donaldsonlab/Operant-Cage/V3/Documentation/Images/Dispenser/dispenser_fullAssembly.JPG

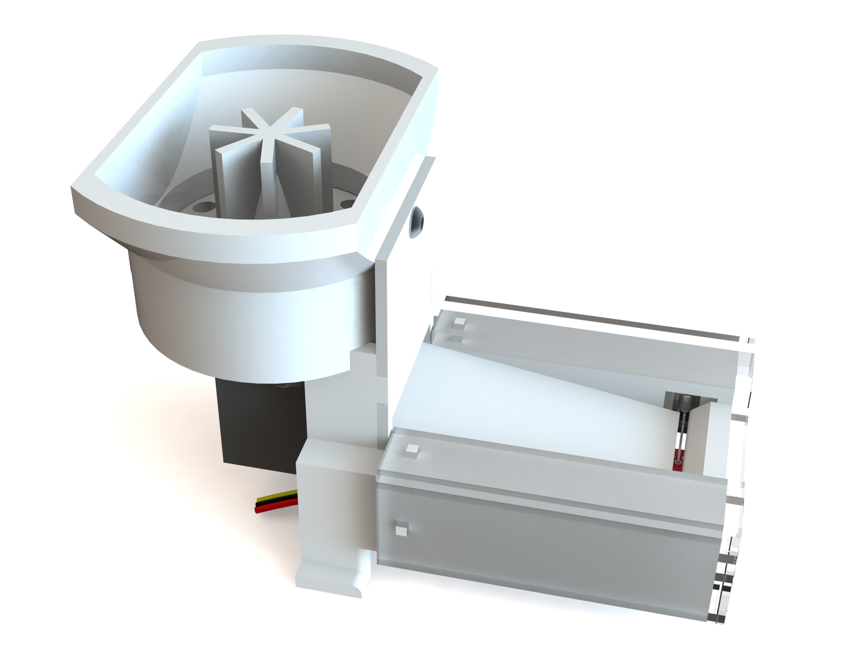
V3/Documentation/Images/Dispenser/dispenser_fullAssembly.JPG
