donaldsonlab/Operant-Cage/V3/Documentation/Images/Dispenser/dispenser_servoMount.JPG

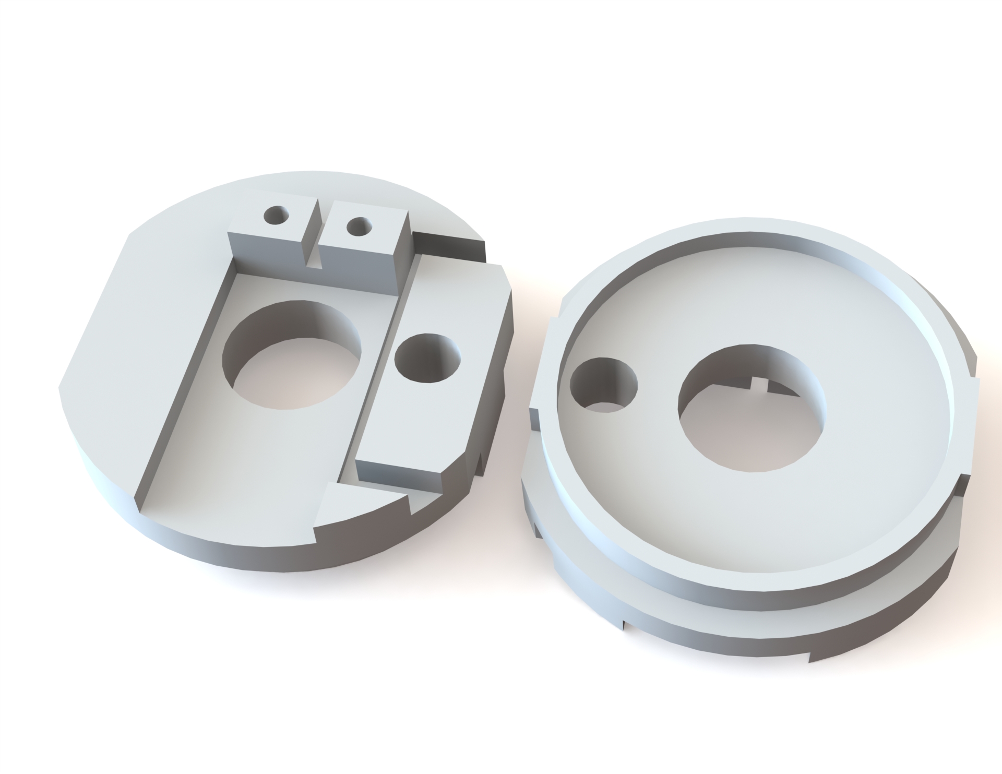
V3/Documentation/Images/Dispenser/dispenser_servoMount.JPG
