donaldsonlab/Operant-Cage/README.md

# Operant-Cage

This repository houses all of the hardware and software documents necessary for designing, manufacturing, and operating the operant cage developed by the Donaldson Lab at the University of Colorado - Boulder.

Its cool stuff.
