donaldsonlab/Operant-Cage/V3/Documentation/electricalDocumentationNotes.rtf

Introduction
- Link to operant documentation
- Maybe describe operant cage somewhat unless this is to be part of the full documentation (perhaps it should be since none of these components are really standalone)
Components
- Do we need to mention Bonsai here?
- If so, we should have an individual section on it, since it is somewhat complex
Raspberry Pi
- Give a brief intro explaining what a pi is and why we are using it
- We use a Raspberry Pi 3 B+
- Power supply
-5V
- SD card
- Size, purpose
Servo Hat
- Necessary for PWM control since Pi doesn't do it well
- Power supply can be 5-6V
- Current depends on number of servos, but we use 3A for 6 servos
- Can be easily controlled using Python and the Adafruit CircuitPython ServoKit library
- https://learn.adafruit.com/adafruit-16-channel-pwm-servo-hat-for-raspberry-pi/using-the-python-library
- I don't know if this is something we want to include in the setup tutorial or not
Front PCB
- PCBs are used to support secure connections with modularity (avoids jumper cables and permanent connections)
- Should we label the female vs male headers in the schematic? This can also just be mentioned in the assembly
Wiring
- Indicate the size of JST connectors
- JST are used for securement as well as modularity
- Wires are not easy to disconnect but can be if needed
- Link to JST assembly video/ say these can be purchased pre-assembled?
- It might be useful to give measurements for minimum wire lengths (this will be helpful for us too)
Raspberry Pi Setup
- I think there is a missing link for the microSD setup
- We may want to mention that a keyboard, mouse, and monitor are not neccessarily needed but are the easiest option
- We may want to mention that this is all using Python version 3
- I changed the import <packageName> suggestion to try to make it more clear
- Does the clone step have to be done from a specific directory?
- I think the code for making the local file and directory might not work
- Not sure if cd into \etc and then cd .. into RPI_operant will work
- Definitely need sudo commands for working in the local etc directory
- I don't even know if we will need this with the new code and config files
- The local settings file cannot be edited that easilly
- need to sudo vi or some other editing technique from the command line
- SSH needs to be enabled, should we mention that?
Assembly
Raspberry Pi
- It may be more useful to have a table with the total pinout, including front/back/hat specifications
- This should include which pins the servos are connected to
- This could also mention that these are the default pins and should be verified with the local settings file
- I'm not sure what this means "Note here that not all of the GPIO pins on the Pi are listed, and that is because these are the pins that come up through the Servo Hat and are available for the custom PCB to be connected to. "
Servo Hat
- Detail pin attachment
- Headers are included when purchased
- No need to solder 3V pin
- Add screws or spacers between hat and pi
Custom PCBs
- Mention that the user will have to solder pins either way
- Detail what pins to place where (is this obvious in the schematic?)
-Female vs. male headers
Third Party Printing
Connecting the Wires
- The servos are separate from the other components when going from front to back
- I don't remember if we changed this or not
Wire Holders
- Any epoxy will work
- Act as 0.5" spacers to match the feet
- I need to ask about the foam strips
- Might not be necessary if the wires are cut to the right length

GENERAL NOTES
- We should reference material sources
- We might want a BOM
- The document is missing some pictures and links
