donaldsonlab/Operant-Cage/V3/Documentation/Images/Chamber/cableCases.JPG

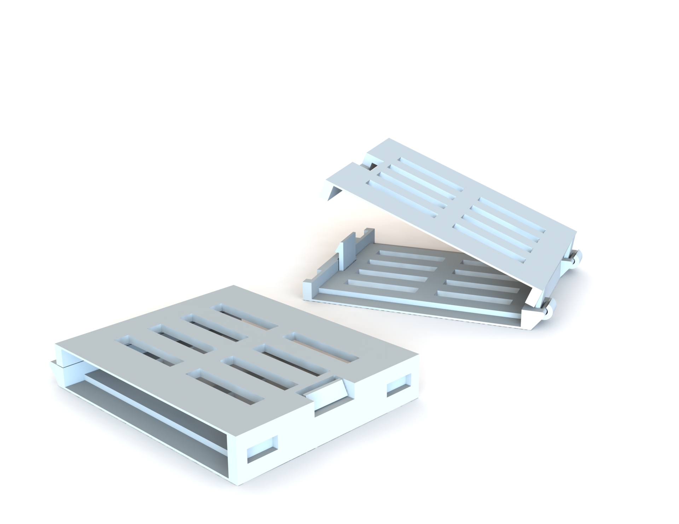
V3/Documentation/Images/Chamber/cableCases.JPG
