donaldsonlab/Operant-Cage/V3/Documentation/Images/Dispenser/disipenser_sectionView.JPG

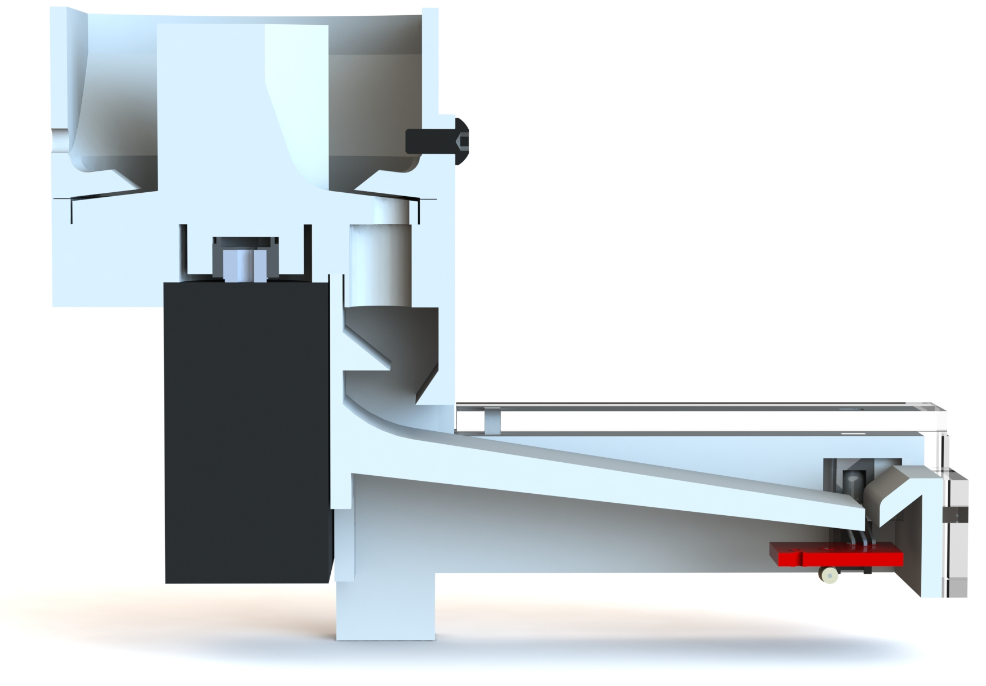
V3/Documentation/Images/Dispenser/disipenser_sectionView.JPG
