donaldsonlab/Operant-Cage/V3/Documentation/Images/Dispenser/dispenser_fullExploded.JPG

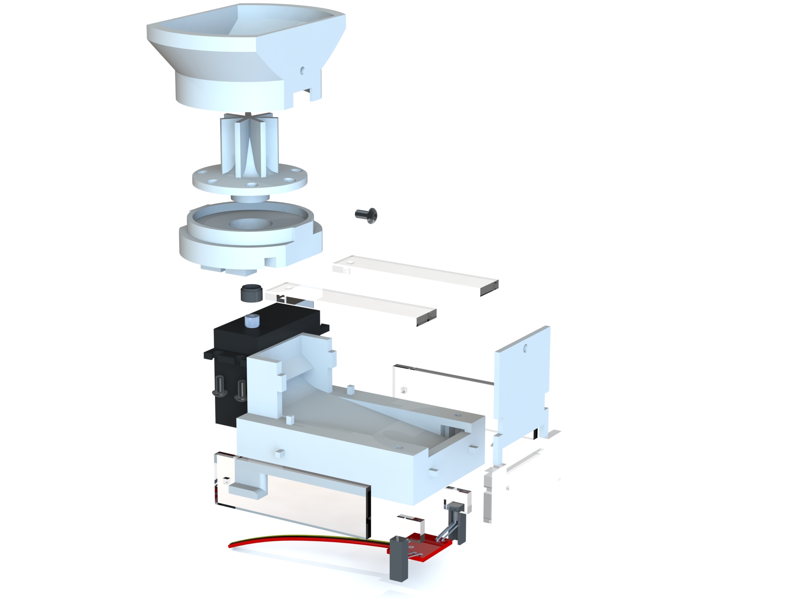
V3/Documentation/Images/Dispenser/dispenser_fullExploded.JPG
