donaldsonlab/Operant-Cage/V3/Documentation/Images/Dispenser/dispenser_hopperExplode2.JPG

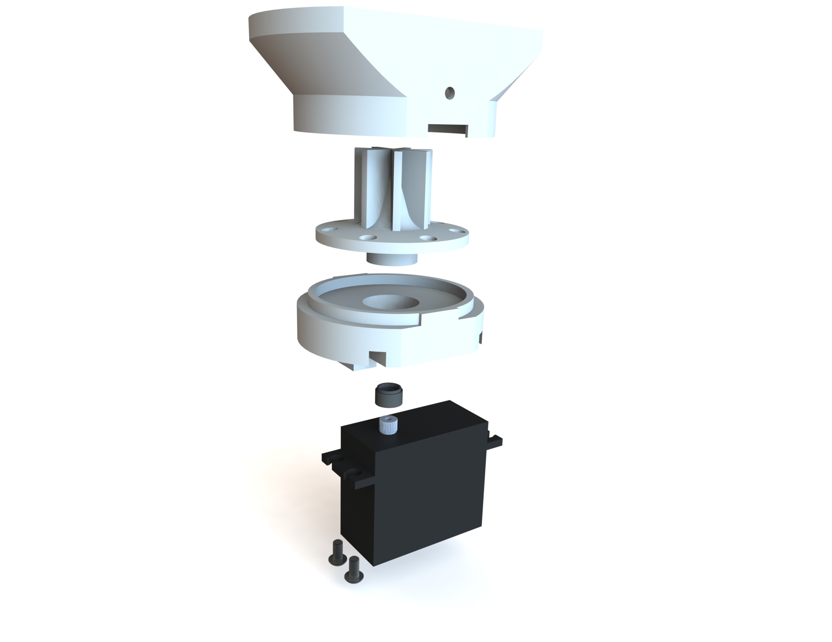
V3/Documentation/Images/Dispenser/dispenser_hopperExplode2.JPG
