donaldsonlab/Operant-Cage/V3/Documentation/Images/Dispenser/dispenser_hopperExplode.JPG

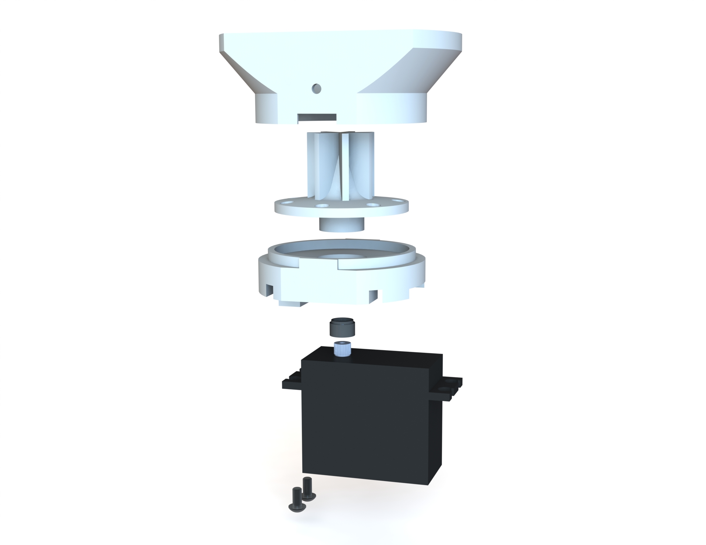
V3/Documentation/Images/Dispenser/dispenser_hopperExplode.JPG
