donaldsonlab/Operant-Cage/V3/Documentation/Images/Dispenser/dispenser_IR2.JPG

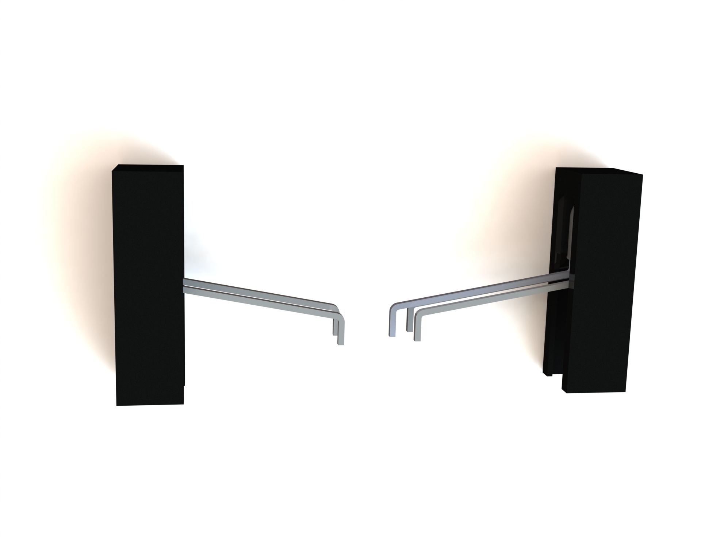
V3/Documentation/Images/Dispenser/dispenser_IR2.JPG
