donaldsonlab/Operant-Cage/V3/Documentation/Images/Dispenser/dispenser_IR.JPG

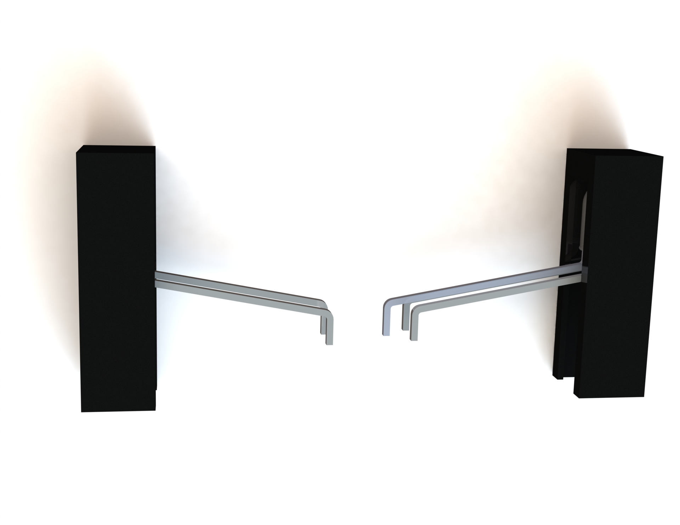
V3/Documentation/Images/Dispenser/dispenser_IR.JPG
