donaldsonlab/Operant-Cage/V3/Documentation/Images/Dispenser/dispenser_mountingPlate.JPG

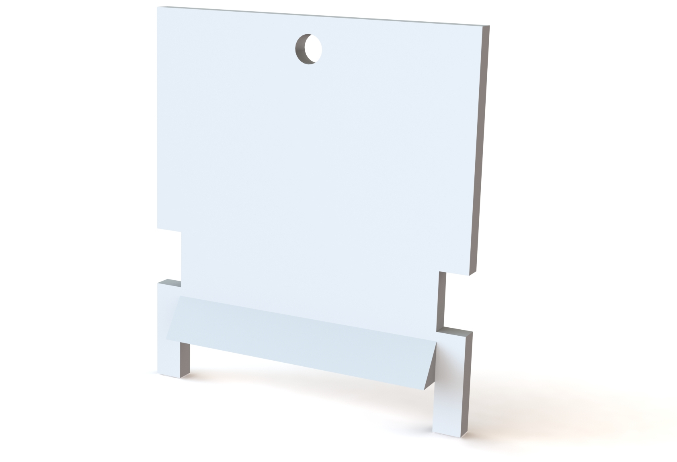
V3/Documentation/Images/Dispenser/dispenser_mountingPlate.JPG
