donaldsonlab/Operant-Cage/V3/Documentation/Images/Dispenser/dispenser_trough2.JPG

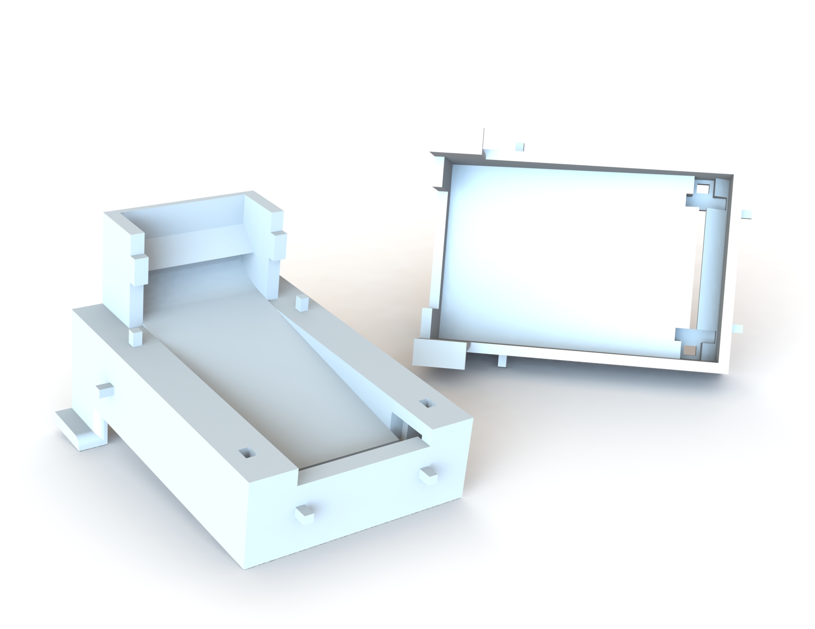
V3/Documentation/Images/Dispenser/dispenser_trough2.JPG
