donaldsonlab/Operant-Cage/V3/Documentation/Images/Dispenser/dispenser_troughExplode.JPG

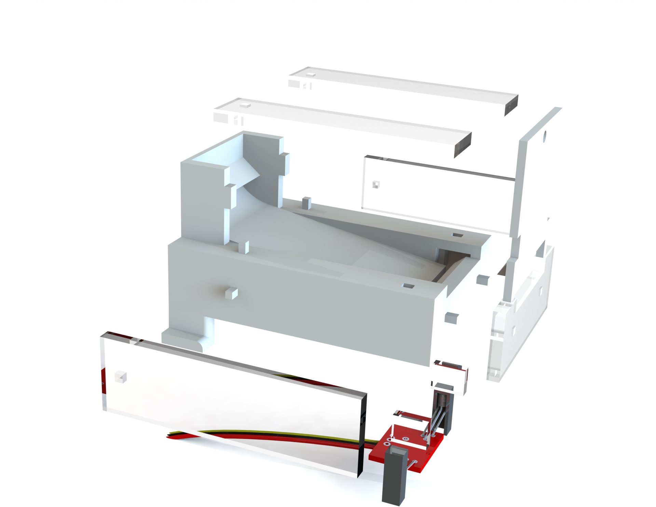
V3/Documentation/Images/Dispenser/dispenser_troughExplode.JPG
