donaldsonlab/Operant-Cage/V3/Documentation/Images/Dispenser/sparkfunPhotointerrupter.jpg

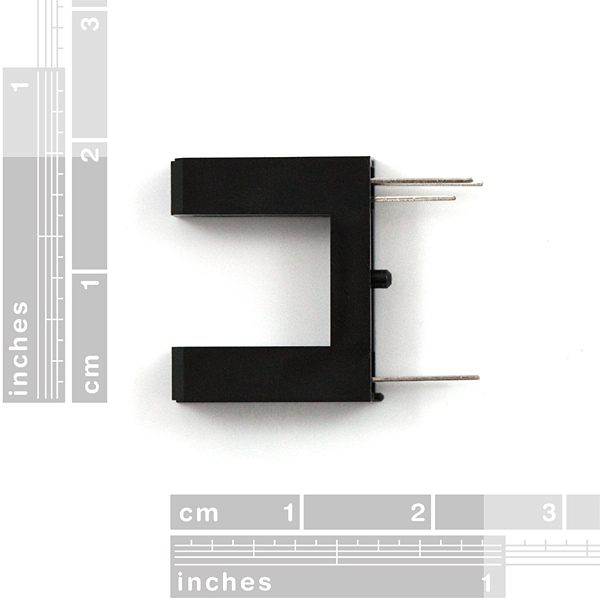
V3/Documentation/Images/Dispenser/sparkfunPhotointerrupter.jpg
