donaldsonlab/Operant-Cage/V3/Documentation/Images/Lever/AH1_schematic.png

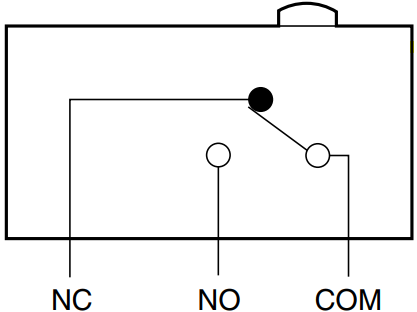
V3/Documentation/Images/Lever/AH1_schematic.png
