donaldsonlab/Operant-Cage/V3/Documentation/Images/Lever/ah1Dimensions.png

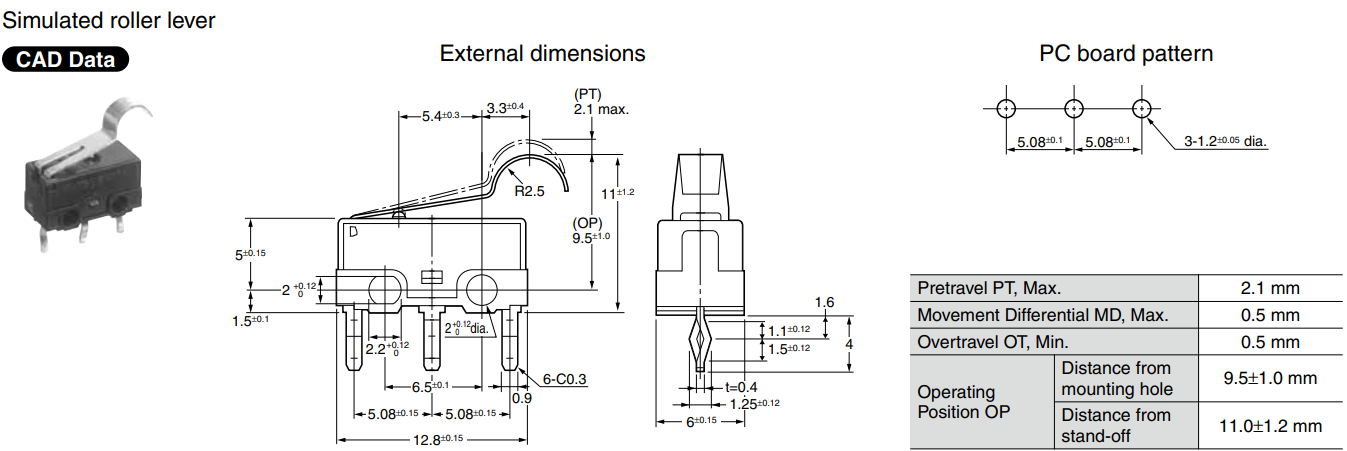
V3/Documentation/Images/Lever/ah1Dimensions.png
