donaldsonlab/Operant-Cage/V3/Documentation/Images/Lever/ah1Dimensions_2.png

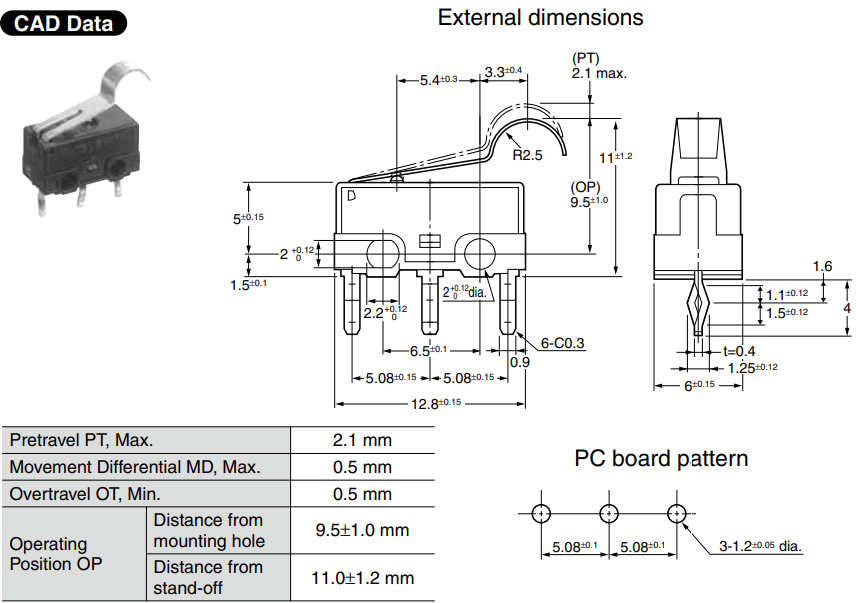
V3/Documentation/Images/Lever/ah1Dimensions_2.png
