donaldsonlab/Operant-Cage/V3/Documentation/Images/Lever/attachPinCap.jpg

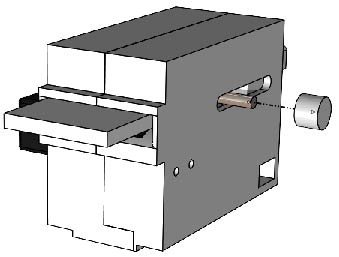
V3/Documentation/Images/Lever/attachPinCap.jpg
