donaldsonlab/Operant-Cage/V3/Documentation/Images/Lever/d2rvDimensions.png

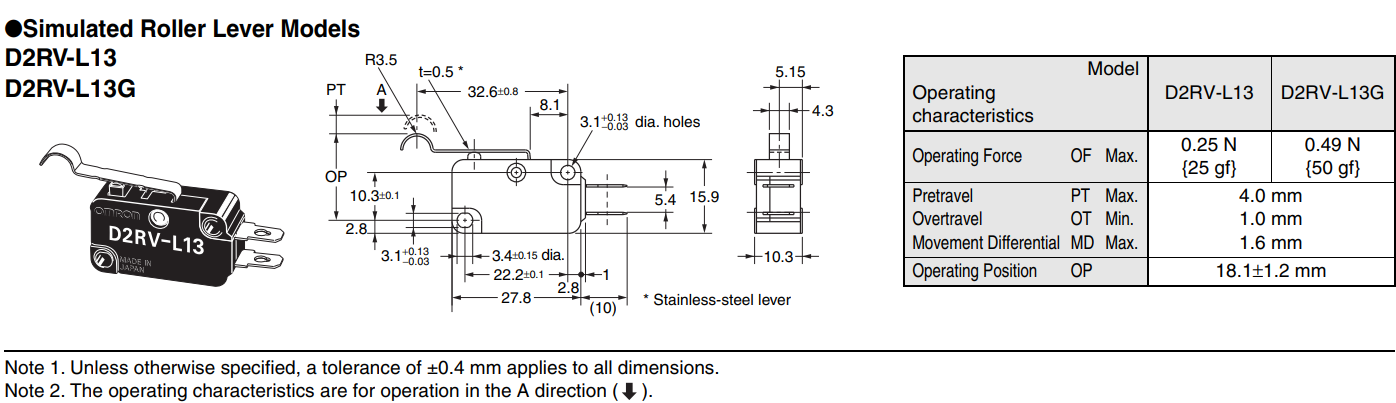
V3/Documentation/Images/Lever/d2rvDimensions.png
