donaldsonlab/Operant-Cage/V3/Documentation/Images/Lever/d2rvDimensions_2.png

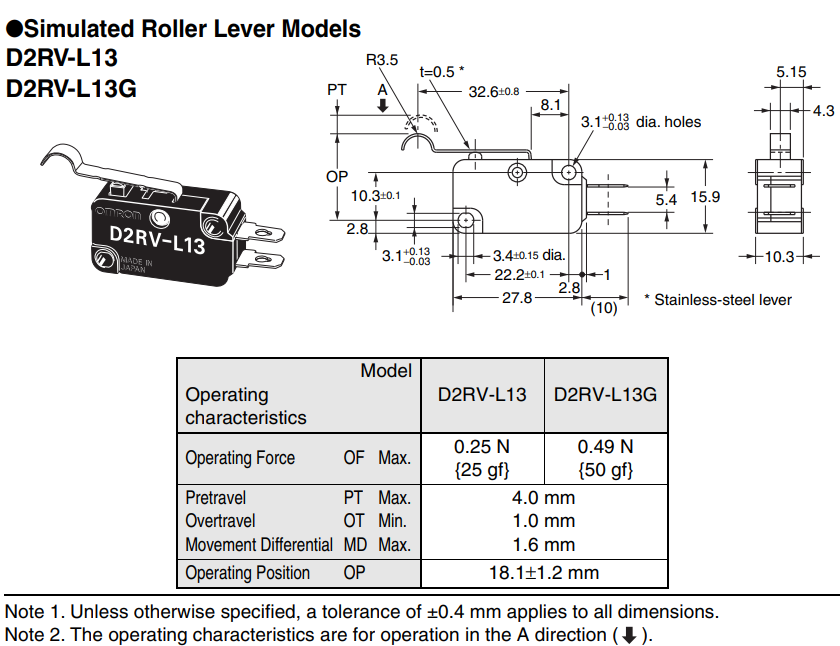
V3/Documentation/Images/Lever/d2rvDimensions_2.png
