donaldsonlab/Operant-Cage/V3/Documentation/Images/Lever/hornAdapterOnServo.jpg

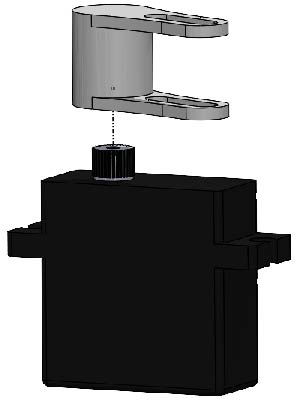
V3/Documentation/Images/Lever/hornAdapterOnServo.jpg
