donaldsonlab/Operant-Cage/V3/Documentation/Images/Lever/hornAdapterOnServo.png

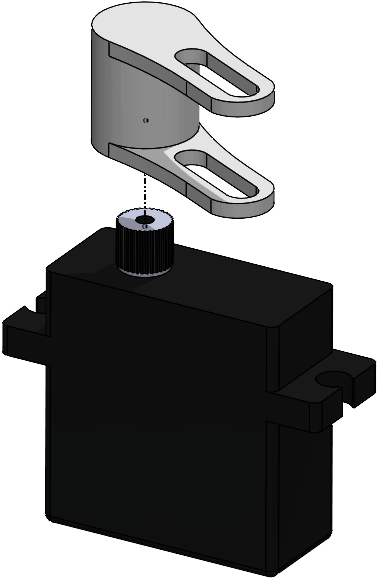
V3/Documentation/Images/Lever/hornAdapterOnServo.png
