donaldsonlab/Operant-Cage/V3/Documentation/Images/Lever/hornIntoAdapter.jpg

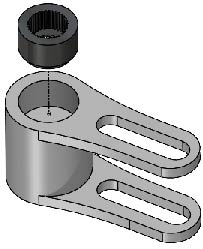
V3/Documentation/Images/Lever/hornIntoAdapter.jpg
