donaldsonlab/Operant-Cage/V3/Documentation/Images/Lever/insertM2Bolts.jpg

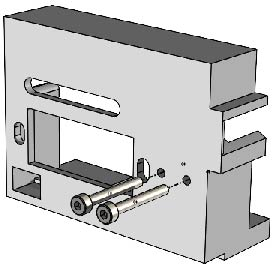
V3/Documentation/Images/Lever/insertM2Bolts.jpg
