donaldsonlab/Operant-Cage/V3/Documentation/Images/Lever/insertMagnets2.png

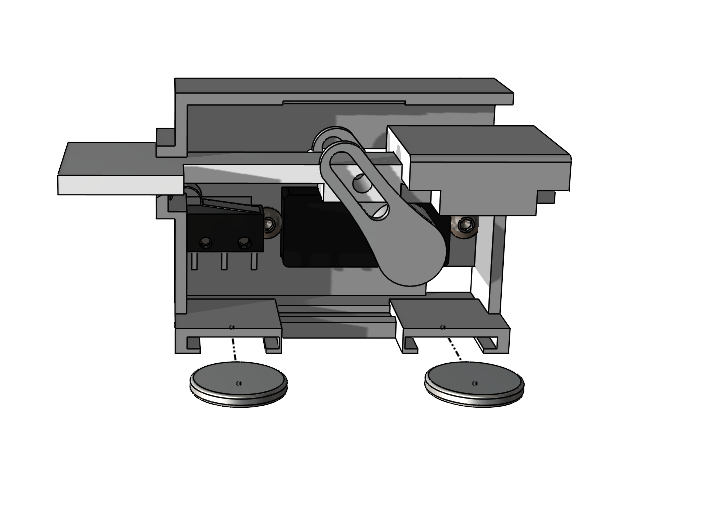
V3/Documentation/Images/Lever/insertMagnets2.png
