donaldsonlab/Operant-Cage/V3/Documentation/Images/Lever/insertPin2.png

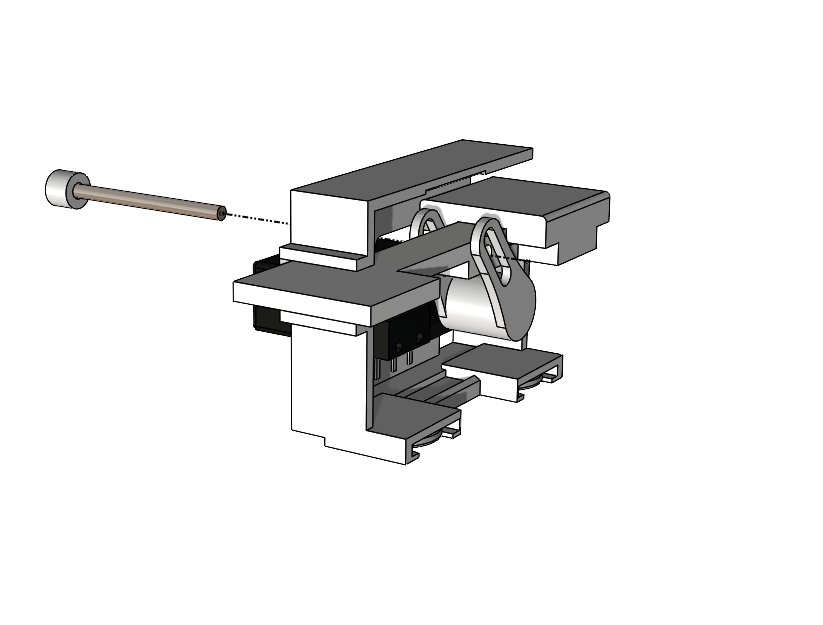
V3/Documentation/Images/Lever/insertPin2.png
