donaldsonlab/Operant-Cage/V3/Documentation/Images/Lever/lvrDrawing_metric.PNG

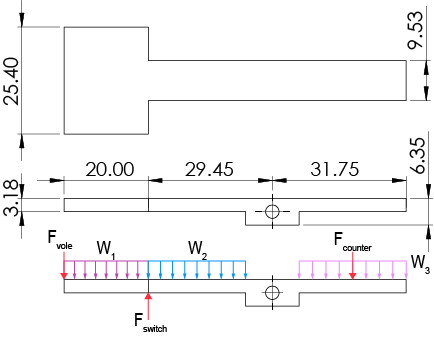
V3/Documentation/Images/Lever/lvrDrawing_metric.PNG
