donaldsonlab/Operant-Cage/V3/Documentation/Images/Lever/mountAH1.png

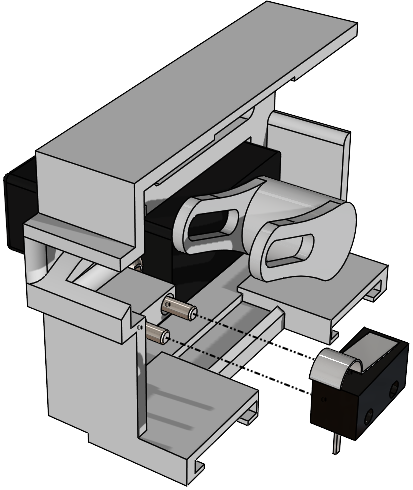
V3/Documentation/Images/Lever/mountAH1.png
