donaldsonlab/Operant-Cage/V3/Documentation/Images/Lever/mountLvrArm2.png

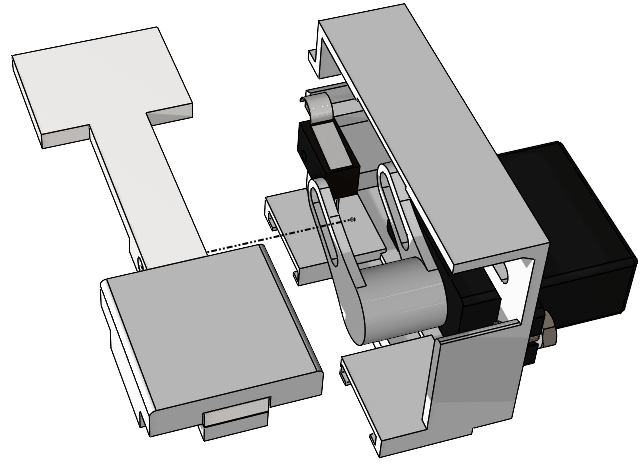
V3/Documentation/Images/Lever/mountLvrArm2.png
