donaldsonlab/Operant-Cage/V3/Documentation/Images/Lever/mountLvrArm3.png

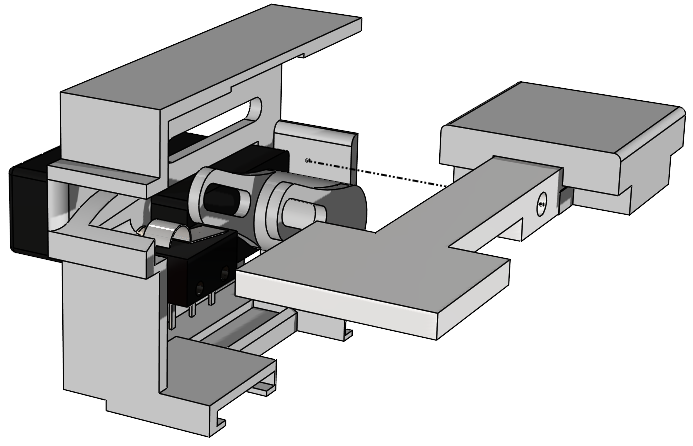
V3/Documentation/Images/Lever/mountLvrArm3.png
