donaldsonlab/Operant-Cage/V3/Documentation/Images/Lever/mountLvrArm4.png

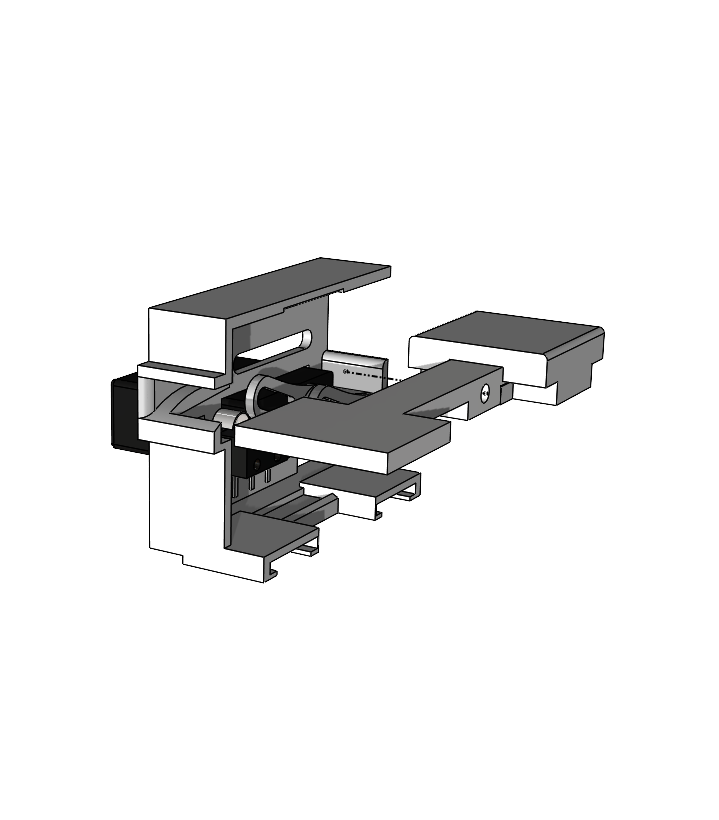
V3/Documentation/Images/Lever/mountLvrArm4.png
