donaldsonlab/Operant-Cage/V3/Documentation/Images/Lever/Screenshot 2021-10-13 123603.png

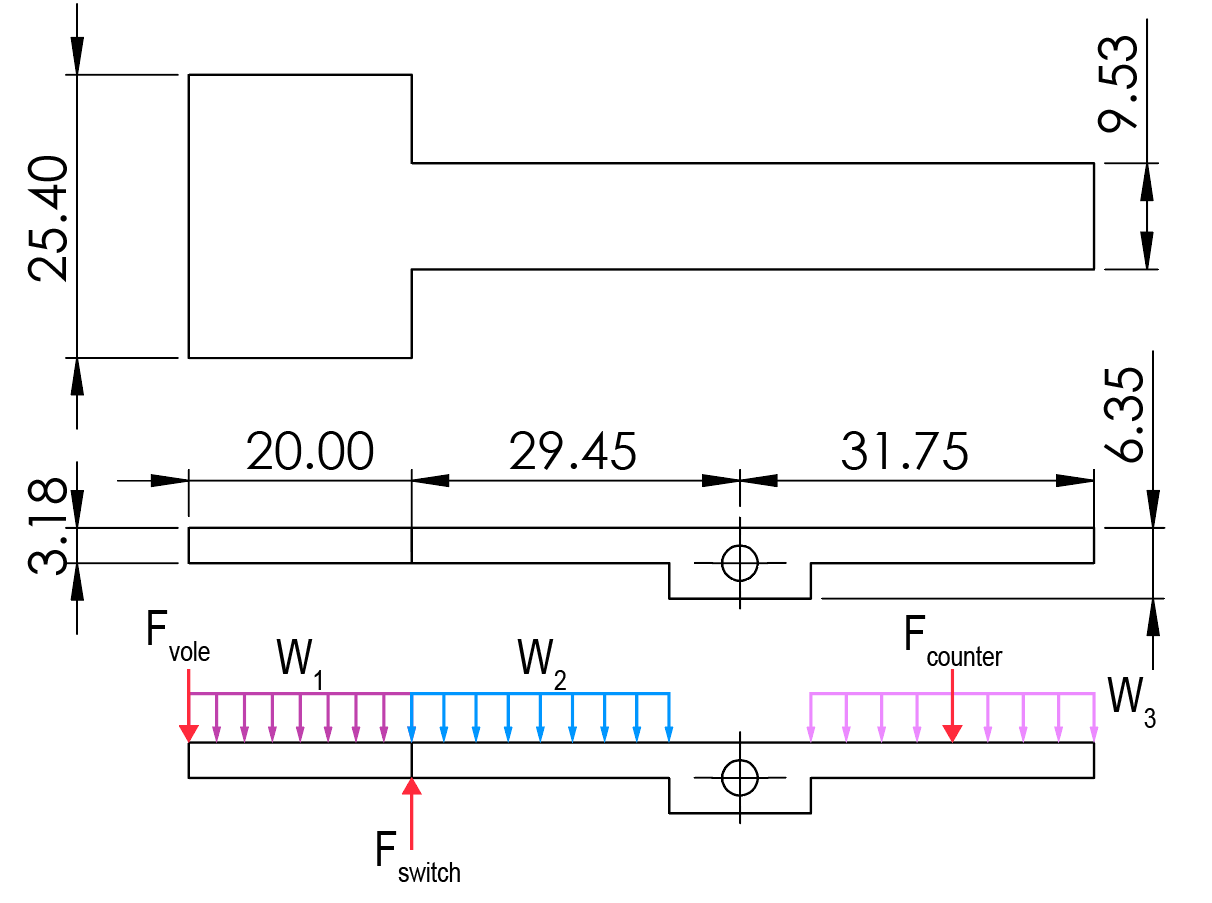
V3/Documentation/Images/Lever/Screenshot 2021-10-13 123603.png
