donaldsonlab/Operant-Cage/V3/Sound_Box/Bill of Materials.xlsx

Part | Boxes | Quantity | Price/Unit | Seller | Price
Plywood
3/4" x 4' x 8' MDF Panel | 4 | 1 | 45.61 | https://www.homedepot.com/p/3-4-in-x-4-ft-x-8-ft-MDF-Panel-D11612490970000/304325742 | 182.44
3/4 in.x 2 ft. x 4 ft. MDF Panel | 4 | 0.5 | 19.2 | https://www.homedepot.com/p/Medium-Density-Fiberboard-Common-3-4-in-x-2-ft-x-4-ft-Actual-0-734-in-x-23-75-in-x-47-75-in-219743/202093815 | 38.4
Hardware |  |  |  |  | 0
Everbuilt 1.5" x 30" Bright nickel Continuous Hinge | 4 | 2 | 9.78 | https://www.homedepot.com/p/Everbilt-1-1-2-in-x-30-in-Bright-Nickel-Continuous-Hinge-15175/202034057 | 78.24
API 2385-SN Window Casement Fastener, Zinc, Satin Nickel | 4 | 4 | 7.99 | https://www.mcguckin.com/2804141/product/API-2385-SN | 127.84
Simpson Strong Tie 2" x 1.5" x 1-3/8" Galvanized Angle | 4 | 4 | 0.58 | https://www.homedepot.com/p/Simpson-Strong-Tie-2-in-x-1-1-2-in-x-1-3-8-in-Galvanized-Angle-A21/100374951 | 9.28
Everbuilt 2" Zinc-Plated Heavy Duty Corner Brace (2-Pack) | 4 | 1 | 4.28 | https://www.homedepot.com/p/Everbilt-2-in-Zinc-Plated-Heavy-Duty-Corner-Brace-2-Pack-15442/202034088 | 17.12 | Total Price | 453.32
4.8mm screw holes |  | 24
#9 screws |  | 16
#9 screws again? |  | 6
