donaldsonlab/Operant-Cage/V3/Documentation/Assemblies/dispenser_feedingDisk.SLDASM

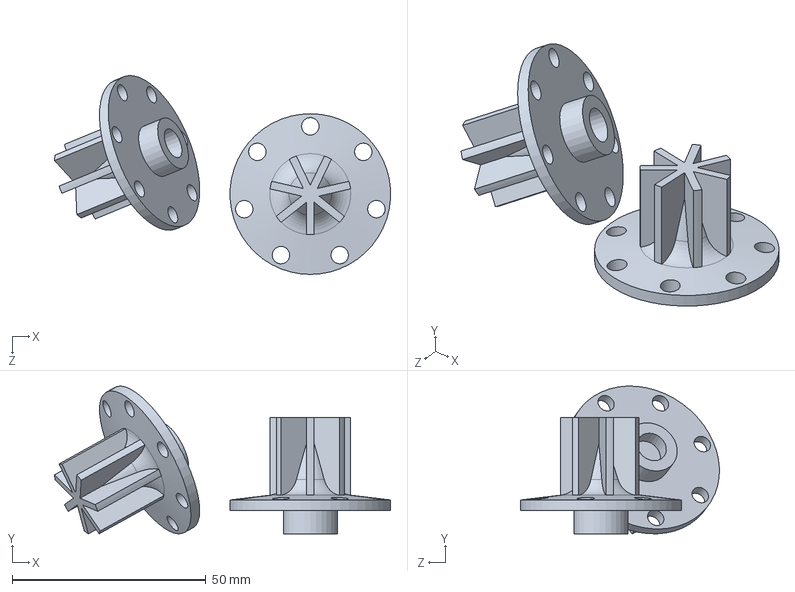
[picture p107: CAD file, 2022-07-01]
V3/Documentation/Assemblies/dispenser_feedingDisk.SLDASM
86.8 x 38.2 x 51.4 mm
preferenceV2_dispenser_feedingDisk_withAgitator x 2
