donaldsonlab/Operant-Cage/V3/Lever/lvrV2_assembly_22217.SLDASM

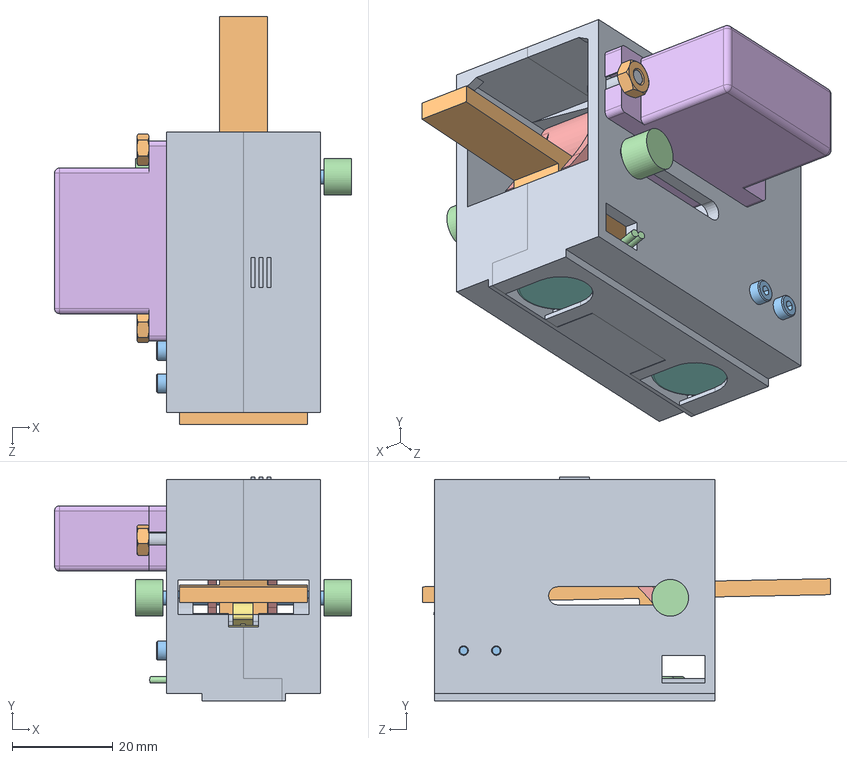
[picture p108: CAD file, 2023-07-26]
V3/Lever/lvrV2_assembly_22217.SLDASM
59.1 x 44.5 x 81.2 mm
lvrV2_housing_22217 x 2
lvrV2_arm
lvrV2_pin
lvrV2_pinCap x 2
lvrV2_HornAdapter
servoOutline_micro
AH1_switchOutline
lvrV2_magnet x 2
socket button head cap screw_am_V3 x 2
hex nut style 1_am_V3 x 2
socket head cap screw_am_V3 x 2
Wires^lvrV2_assembly_22217
