donaldsonlab/Operant-Cage/V3/Sound_Box/soundAssem2.SLDASM

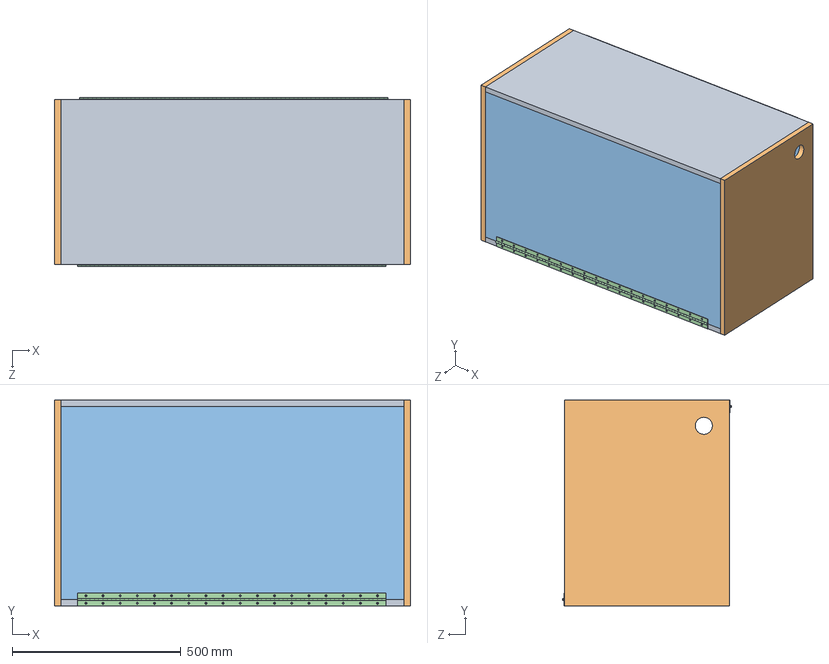
[picture p109: CAD file, 2023-07-11]
V3/Sound_Box/soundAssem2.SLDASM
1054.1 x 609.6 x 501.4 mm
bottom x 2
side x 2
front x 2
box-hinge x 2
preferenceV2_chamberBottom x 3
preferenceV2_chamberFront x 6
preferenceV2_chamberSide x 2
preferenceV2_door x 2
preferenceV2_door_panelSpacerClip x 2
preferenceV2_door_stopper x 2
door_rail x 2
preferenceV2_Extend_Feet x 8
preferenceV2_dispenser_trough
preferenceV2_dispenser_servoMount
servoOutline_DoorServo x 3
preferenceV2_dispenser_funnel
preferenceV2_dispenser_feedingDisk
preferenceV2_dispenser_troughShield_Top x 2
preferenceV2_dispenser_troughShield_Side x 2
lvrV2_housing1 x 6
lvr_armPin x 3
lvr_armPinClip x 3
servoOutline_micro x 3
lvrV2_HornAdapter x 3
lvrV2_armSleeve x 3
lvrV2_magnetMount x 3
preferenceV2_door_servoSpacer x 2
preferenceV2_door_guide x 2
pinion_201007 x 2
preferenceV2_irMount x 4
preferenceV2_door_GuideFlange x 4
preferenceV2_Extend_bracket x 4
preferenceV2_Extend_LBracket x 4
preferenceV2_Extend_topBracket x 4
