donaldsonlab/Operant-Cage/V3/Dispenser/sparkfunIR_LEDandCase.SLDPRT.SLDASM

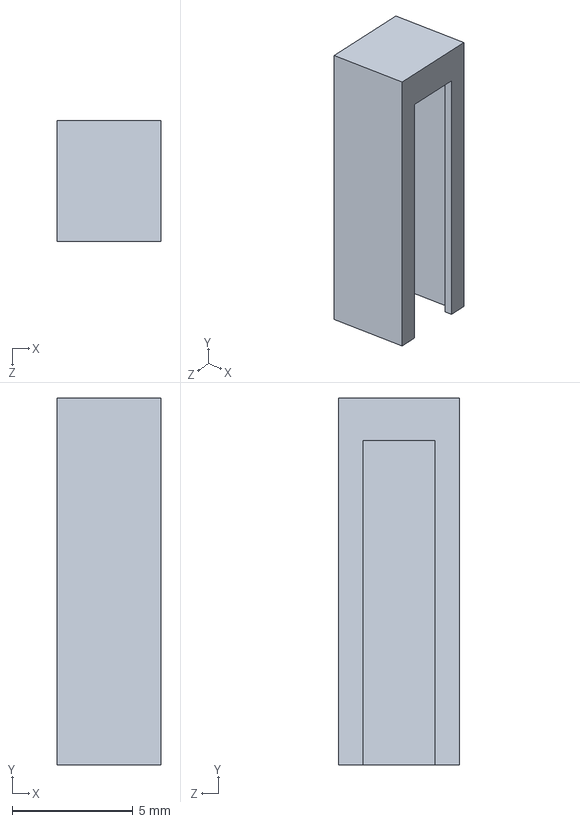
[picture p110: CAD file, 2024-12-18]
V3/Dispenser/sparkfunIR_LEDandCase.SLDPRT.SLDASM
4.30 x 15.2 x 5.00 mm
