donaldsonlab/Operant-Cage/V3/Documentation/Assemblies/dispenser_trough.SLDASM

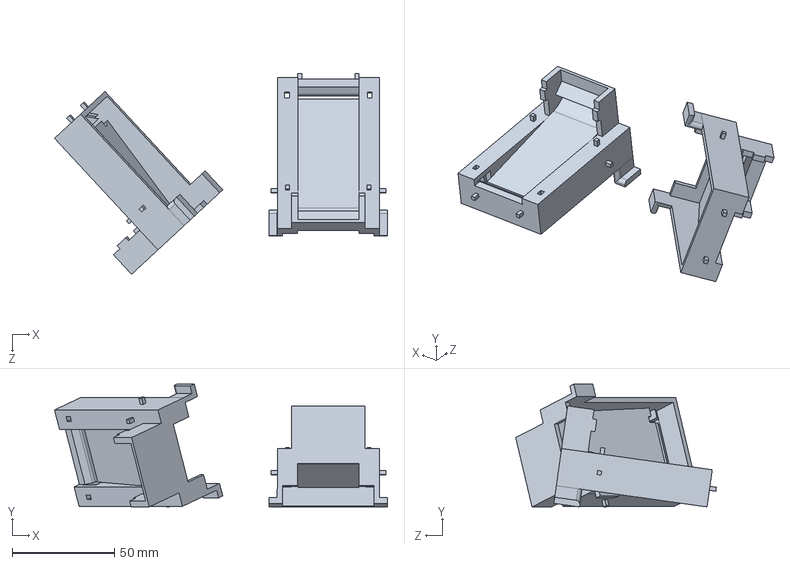
[picture p111: CAD file, 2022-07-01]
V3/Documentation/Assemblies/dispenser_trough.SLDASM
163.2 x 60.2 x 98.4 mm
preferenceV2_dispenser_trough_separateMount x 2
