donaldsonlab/Operant-Cage/V3/operant box bracket .SLDASM

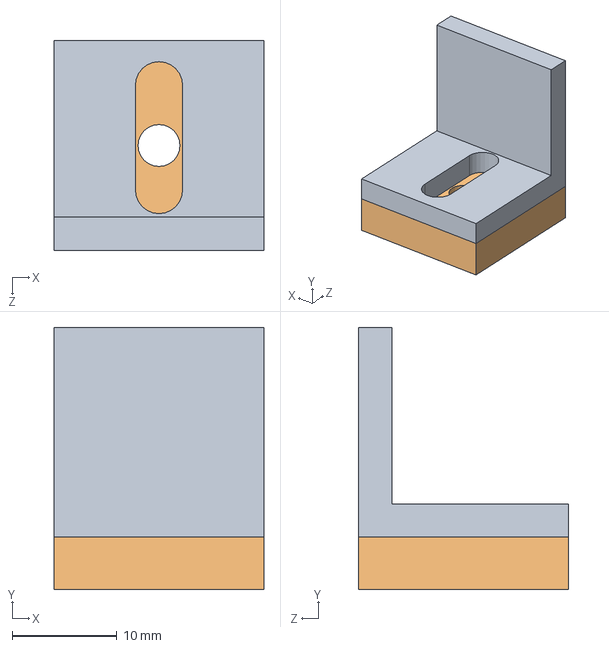
[picture p112: CAD file, 2024-12-18]
V3/operant box bracket .SLDASM
20.0 x 25.0 x 20.0 mm
operant box_bracket_A
operant box_bracket_B
