donaldsonlab/Operant-Cage/V3/Documentation/Assemblies/dispenser_servoMount.SLDASM

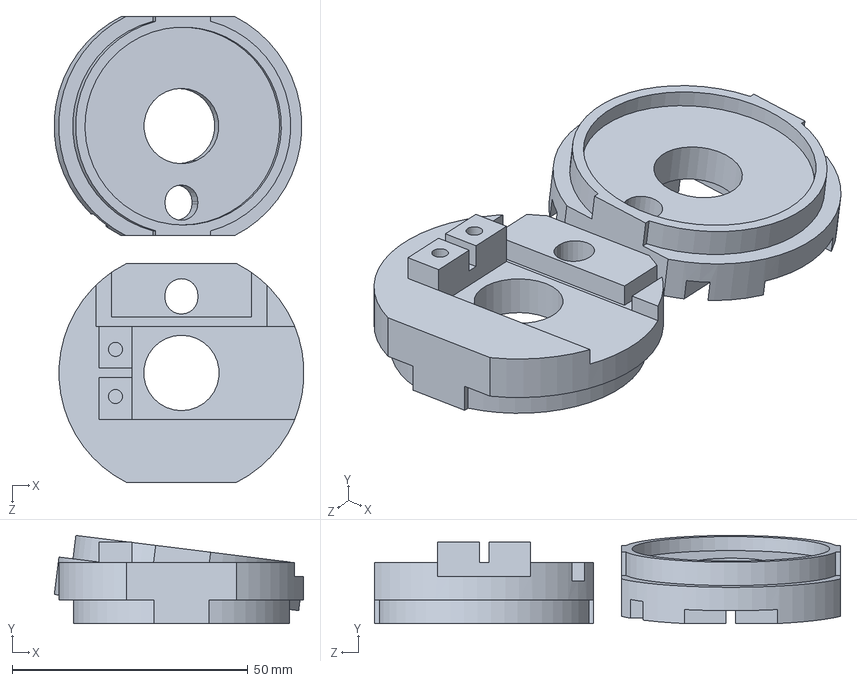
[picture p114: CAD file, 2022-07-01]
V3/Documentation/Assemblies/dispenser_servoMount.SLDASM
52.9 x 18.7 x 98.9 mm
preferenceV2_dispenser_servoMount x 2
