donaldsonlab/Operant-Cage/V3/Lever/nosepoke_V3/Nosepoke_Fit_check - new doors.SLDASM

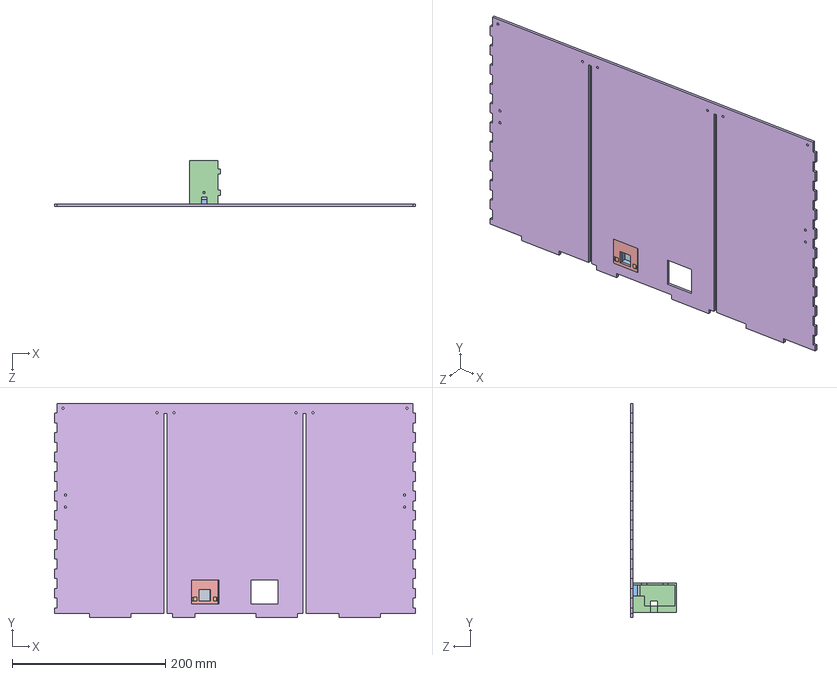
[picture p115: CAD file, 2024-12-18]
V3/Lever/nosepoke_V3/Nosepoke_Fit_check - new doors.SLDASM
470.8 x 279.4 x 60.2 mm
preferenceV2_chamberFront_new doors
nosepoke_new_wall_connector
nosepoke x 2
nosepoke_guard
sparkfunIR_casing x 2
nosepoke_guard_backing
