donaldsonlab/Operant-Cage/V3/Structural_base_TotalAssembly_V3.SLDPRT

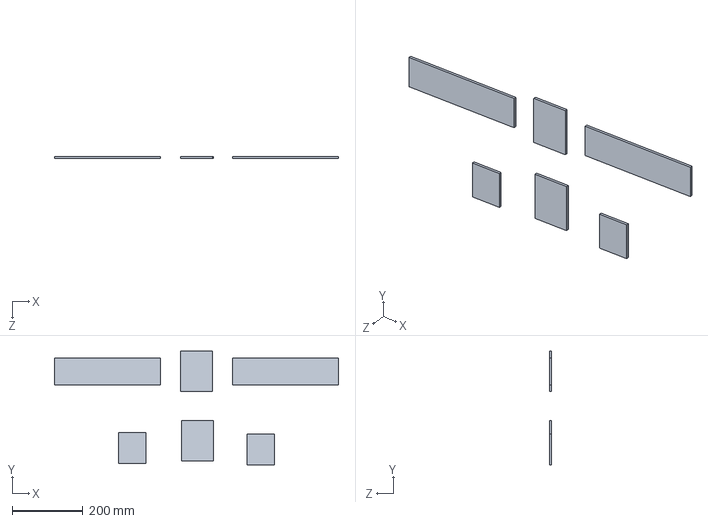
[picture p116: CAD file, 2024-12-18]
V3/Structural_base_TotalAssembly_V3.SLDPRT
802.8 x 322.2 x 6.35 mm
