donaldsonlab/Operant-Cage/GLOBAL/D2RV_L13/D2RV_L13_FLAT.SLDASM

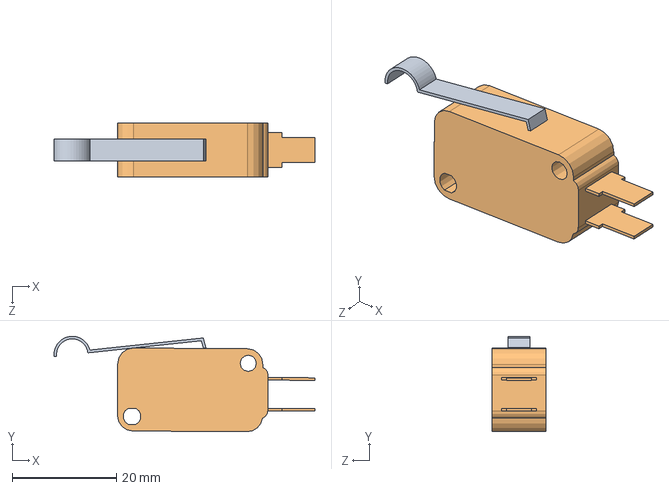
[picture p117: CAD file, 2021-05-10]
GLOBAL/D2RV_L13/D2RV_L13_FLAT.SLDASM
50.0 x 18.3 x 10.3 mm
D2RV_L13_ACTUATOR
D2RV_L13_BASE_FLAT
