donaldsonlab/Operant-Cage/V3/Chamber/New interaction box/Interaction_Box.SLDASM

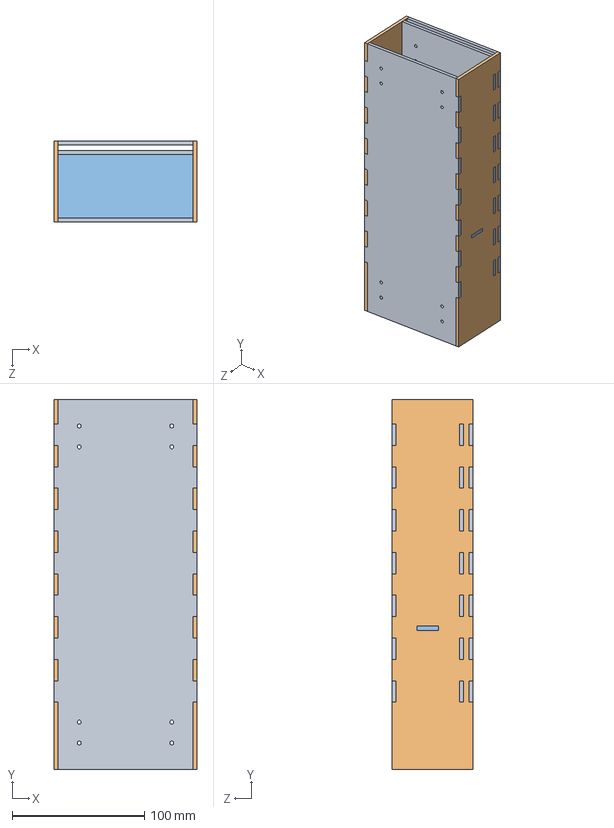
[picture p118: CAD file, 2024-11-19]
V3/Chamber/New interaction box/Interaction_Box.SLDASM
107.9 x 279.4 x 61.4 mm
front_back x 3
side x 2
interaction_lid
