donaldsonlab/Operant-Cage/V3/Documentation/Assemblies/dispenser_funnel.SLDASM

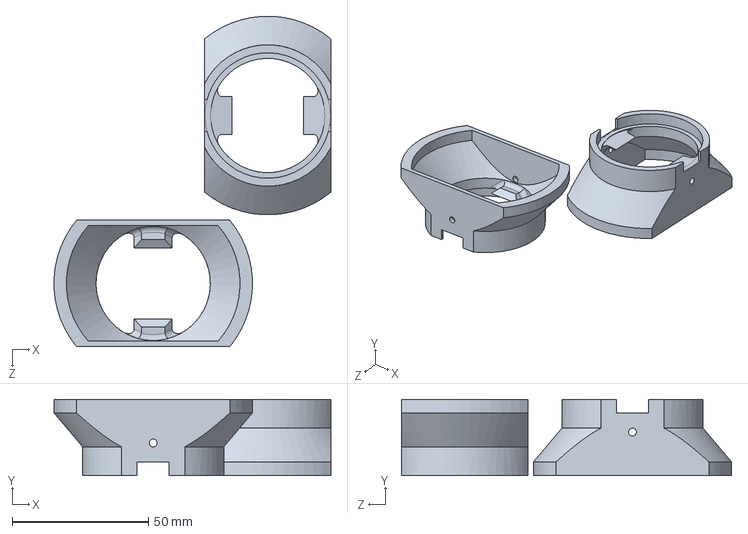
[picture p119: CAD file, 2022-07-01]
V3/Documentation/Assemblies/dispenser_funnel.SLDASM
101.8 x 28.0 x 121.4 mm
preferenceV2_dispenser_funnel x 2
