donaldsonlab/Operant-Cage/V3/Door/preferenceV2_door_Assembly.SLDASM

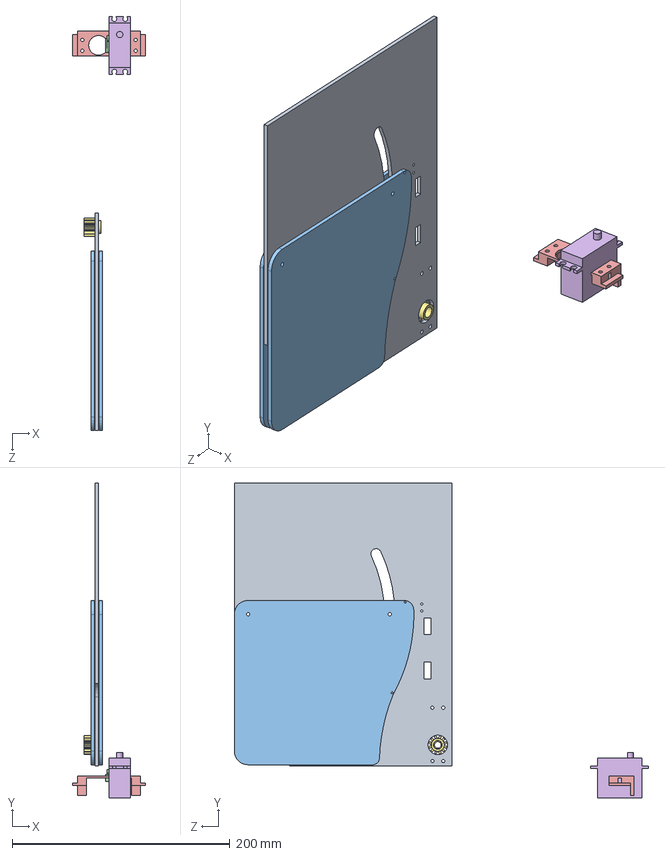
[picture p120: CAD file, 2024-06-27]
V3/Door/preferenceV2_door_Assembly.SLDASM
67.0 x 289.6 x 381.0 mm
preferenceV2_door
preferenceV2_door_panelSpacer
2TiltCageV2_doorPanel x 2
AH1_switchOutline
preferenceV2_doorServoMount
servoOutline_DoorServo
pinion_211705_2
