donaldsonlab/Operant-Cage/V3/operant box cable management.SLDASM

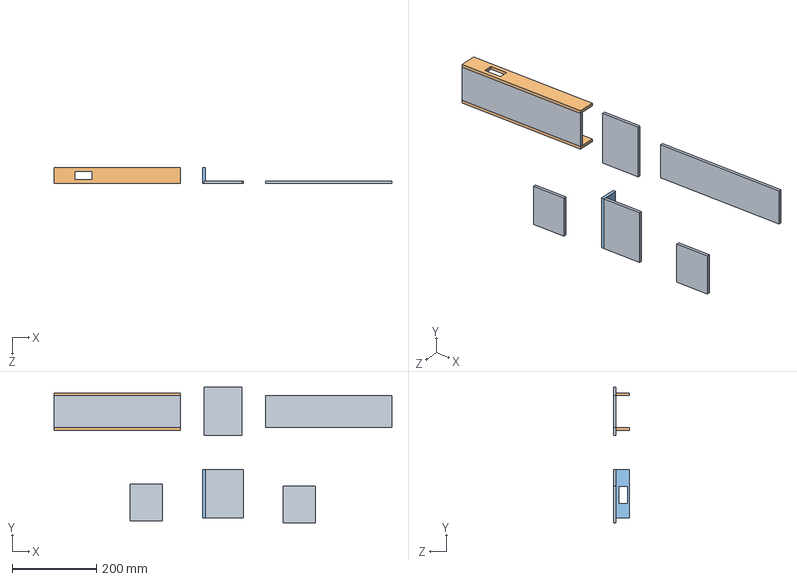
[picture p122: CAD file, 2024-12-18]
V3/operant box cable management.SLDASM
802.8 x 322.2 x 38.1 mm
Structural_base_TotalAssembly_V3
structural_base_A_side x 2
Part7^operant box cable management
