donaldsonlab/Operant-Cage/GLOBAL/D2RV_L13/D2RV_L13.SLDASM

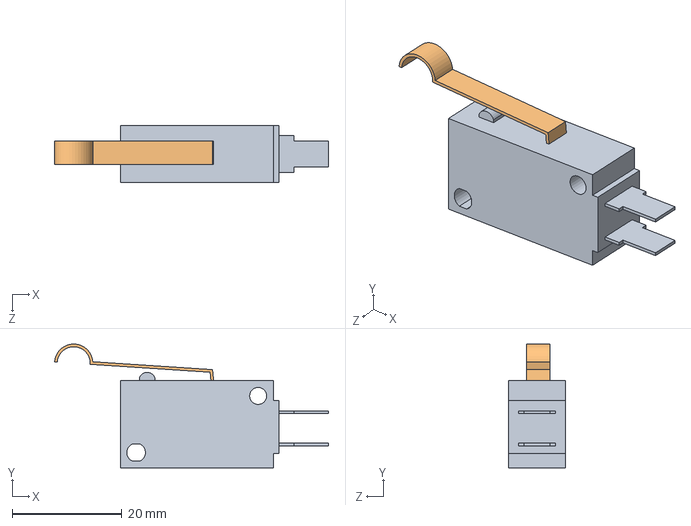
[picture p123: CAD file, 2021-05-10]
GLOBAL/D2RV_L13/D2RV_L13.SLDASM
49.8 x 22.5 x 10.3 mm
D2RV_L13_BASE
D2RV_L13_ACTUATOR
