donaldsonlab/Operant-Cage/V3/Chamber/New interaction box/Interaction_Box_Cover^preference_TotalAssembly_V3.SLDPRT

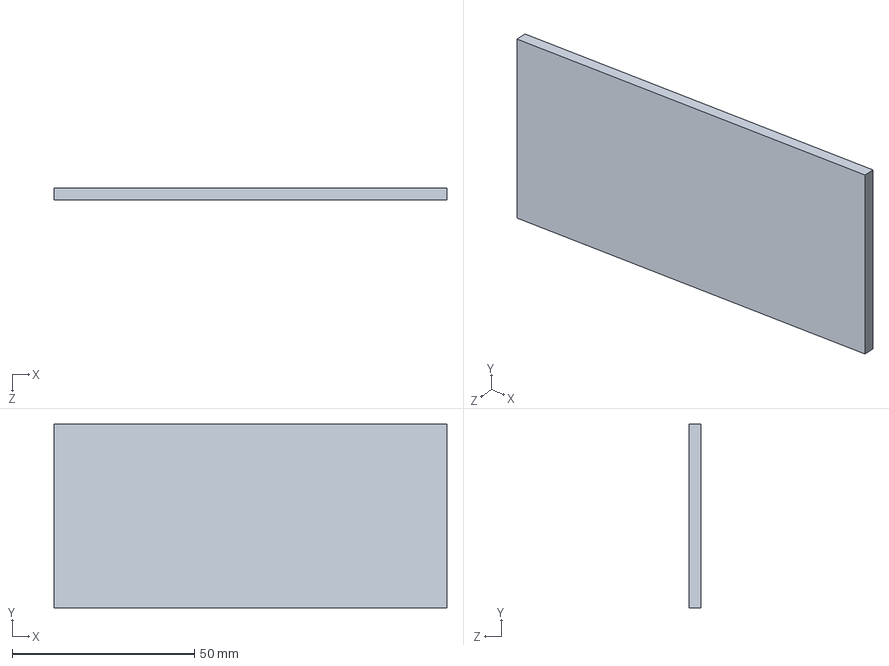
[picture p124: CAD file, 2023-07-26]
V3/Chamber/New interaction box/Interaction_Box_Cover^preference_TotalAssembly_V3.SLDPRT
107.9 x 50.5 x 3.17 mm
