donaldsonlab/Operant-Cage/V3/Documentation/Assemblies/chamber_cableCases.SLDASM

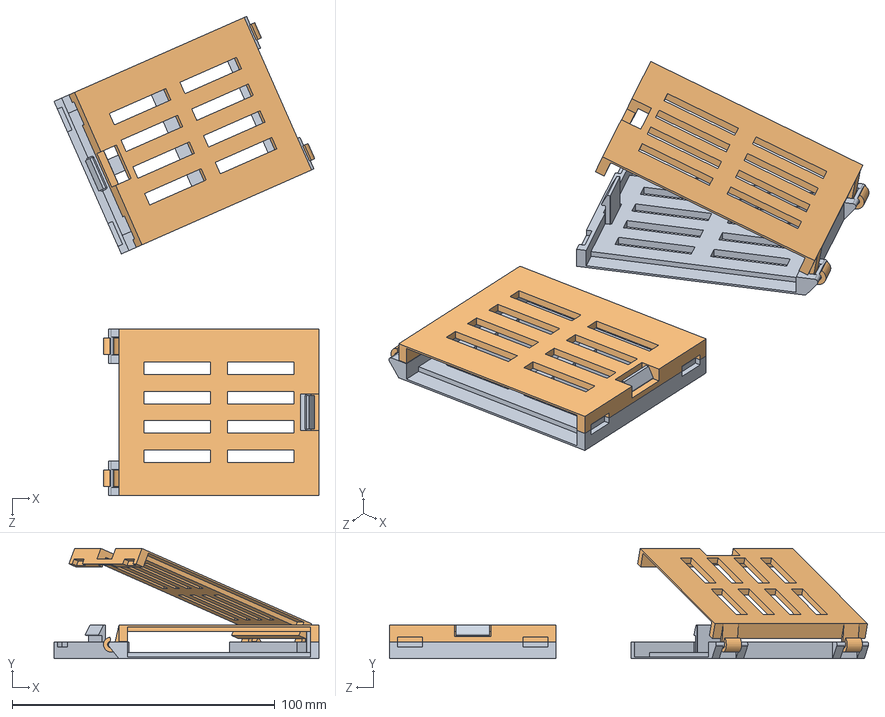
[picture p125: CAD file, 2022-07-01]
V3/Documentation/Assemblies/chamber_cableCases.SLDASM
100.9 x 42.0 x 182.5 mm
cableCase_bottom x 2
cableCase_top x 2
