donaldsonlab/Operant-Cage/V3/Dispenser/preferenceV2_dispenserAssembly.SLDASM

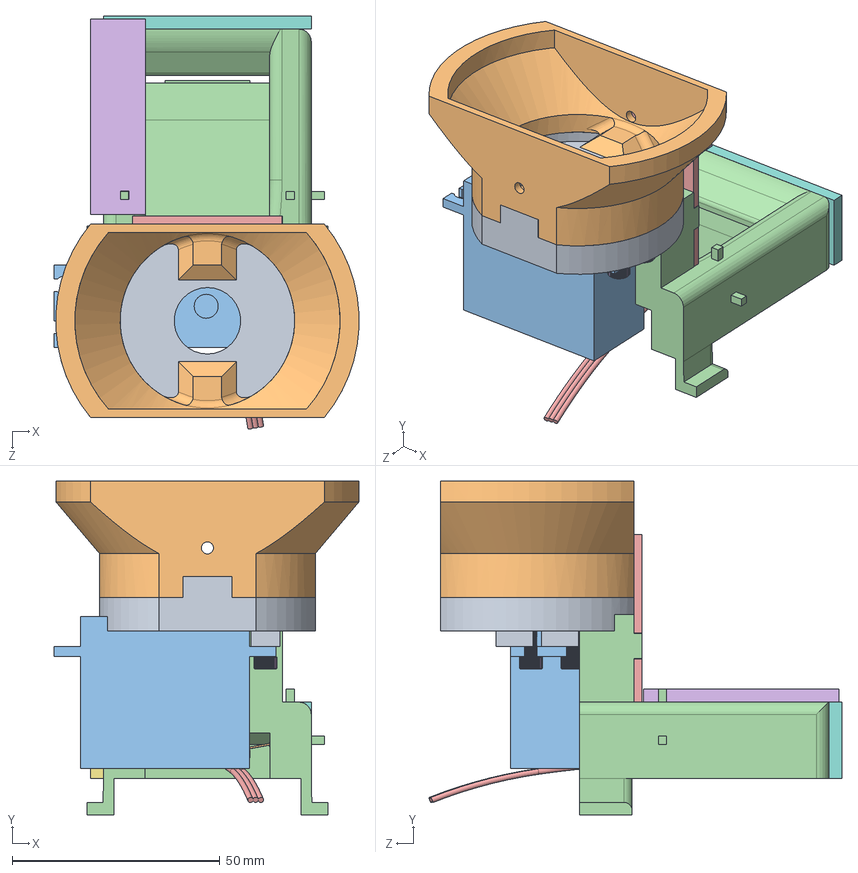
[picture p126: CAD file, 2023-05-15]
V3/Dispenser/preferenceV2_dispenserAssembly.SLDASM
73.3 x 80.3 x 99.4 mm
preferenceV2_dispenser_servoMount
preferenceV2_dispenser_funnel
servoOutline_DoorServo
preferenceV2_dispenser_trough
preferenceV2_dispenser_mountingPlate
preferenceV2_dispenser_troughShield_Top
preferenceV2_dispenser_troughShield_Side
preferenceV2_dispenser_troughShield_Front
preferenceV2_dispenser_IRShield x 2
sparkfunIR_LED x 2
sparkfunIR_casing x 2
sparkfunIR_breakoutBoard
dispenser_wires
M3x12 x 2
