donaldsonlab/Operant-Cage/V3/Lever/lvrV2_Nosepoke.SLDASM

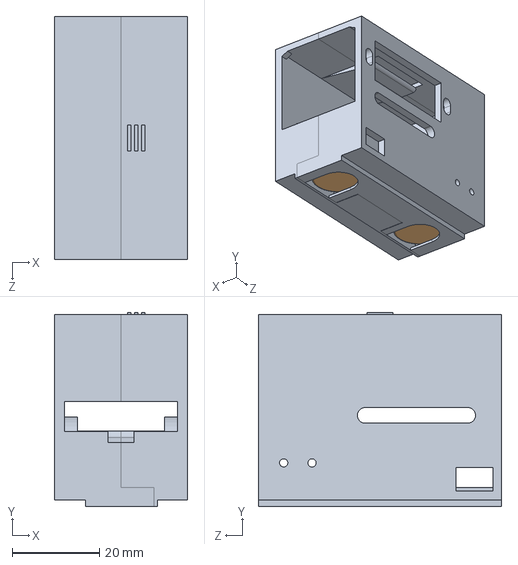
[picture p127: CAD file, 2023-07-26]
V3/Lever/lvrV2_Nosepoke.SLDASM
30.6 x 44.5 x 55.8 mm
lvrV2_housing_22217 x 2
lvrV2_magnet x 2
