donaldsonlab/Operant-Cage/V3/Lever/nosepoke_V3_extended/extended nosepoke.SLDASM

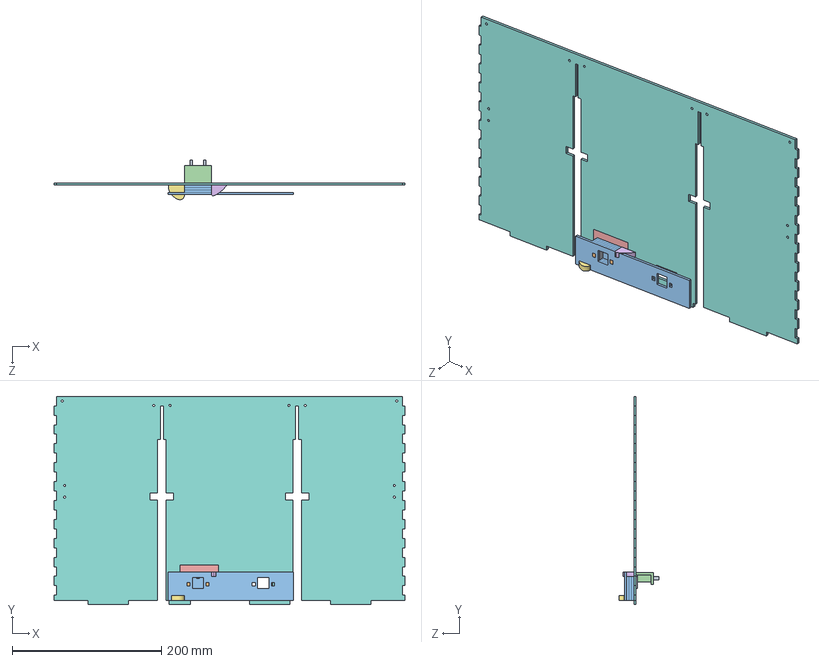
[picture p128: CAD file, 2024-11-25]
V3/Lever/nosepoke_V3_extended/extended nosepoke.SLDASM
470.8 x 279.4 x 53.0 mm
inner floor x 2
sparkfunIR_casing x 2
outside guard extended x 4
preferenceV2_chamberFront_nosepokes_scoped
