donaldsonlab/Operant-Cage/V3/Sound_Box/box_assem.SLDASM

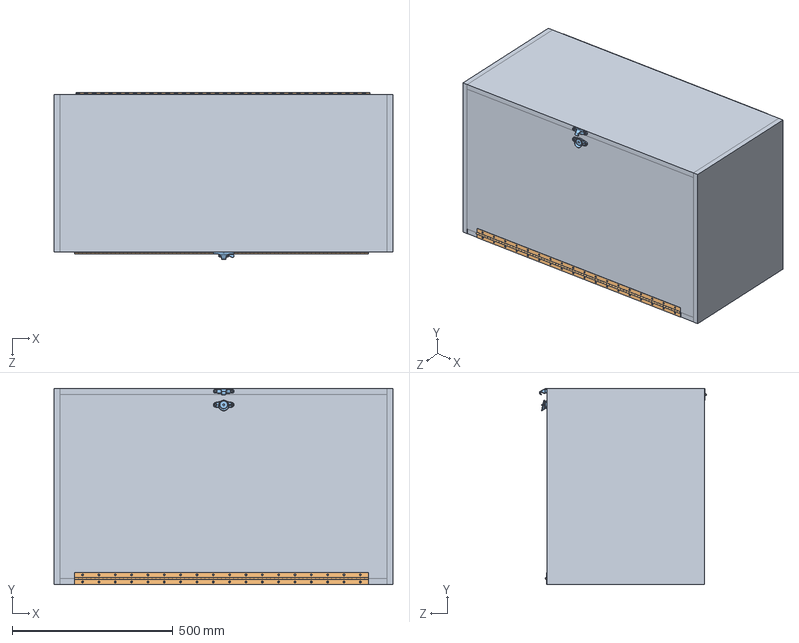
[picture p129: CAD file, 2021-06-29]
V3/Sound_Box/box_assem.SLDASM
1054.1 x 609.6 x 520.5 mm
boxV2
box-hinge x 2
latch
