donaldsonlab/Operant-Cage/V3/Lever/nosepoke_V3/nosepoke_assembly_V3.SLDASM

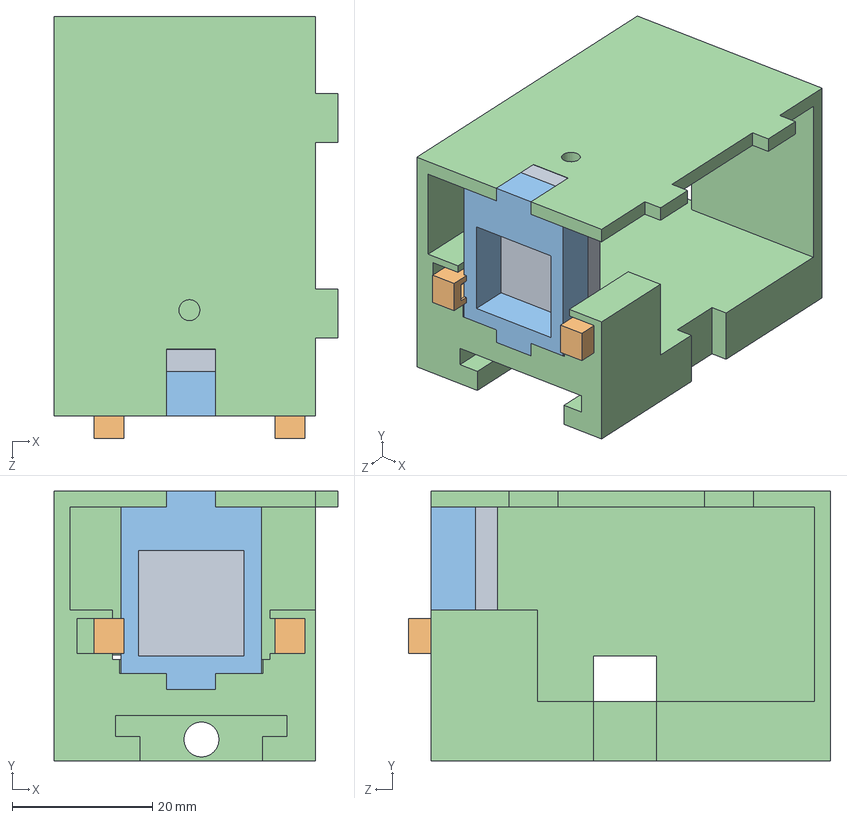
[picture p130: CAD file, 2024-12-18]
V3/Lever/nosepoke_V3/nosepoke_assembly_V3.SLDASM
40.5 x 38.5 x 60.2 mm
nosepoke x 2
nosepoke_guard
sparkfunIR_casing x 2
nosepoke_guard_backing
