donaldsonlab/Operant-Cage/V3/Lever/nosepoke_CloserIRs/Assem1.SLDASM

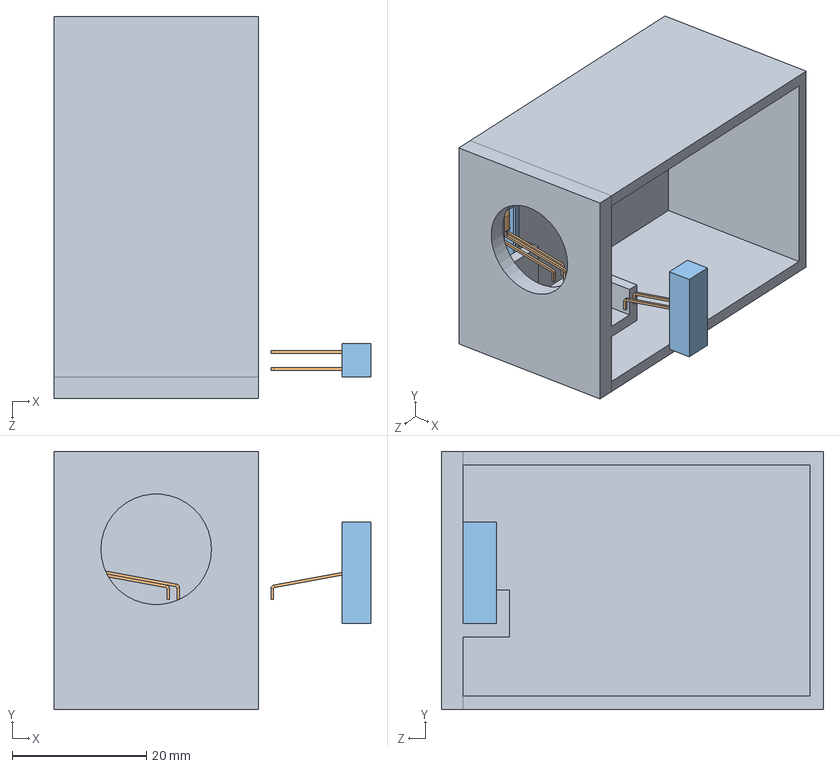
[picture p131: CAD file, 2023-07-26]
V3/Lever/nosepoke_CloserIRs/Assem1.SLDASM
47.3 x 38.5 x 57.0 mm
nosepoke
sparkfunIR_LED x 2
sparkfunIR_casing x 2
