donaldsonlab/Operant-Cage/V3/preference_TotalAssembly_V3.SLDASM

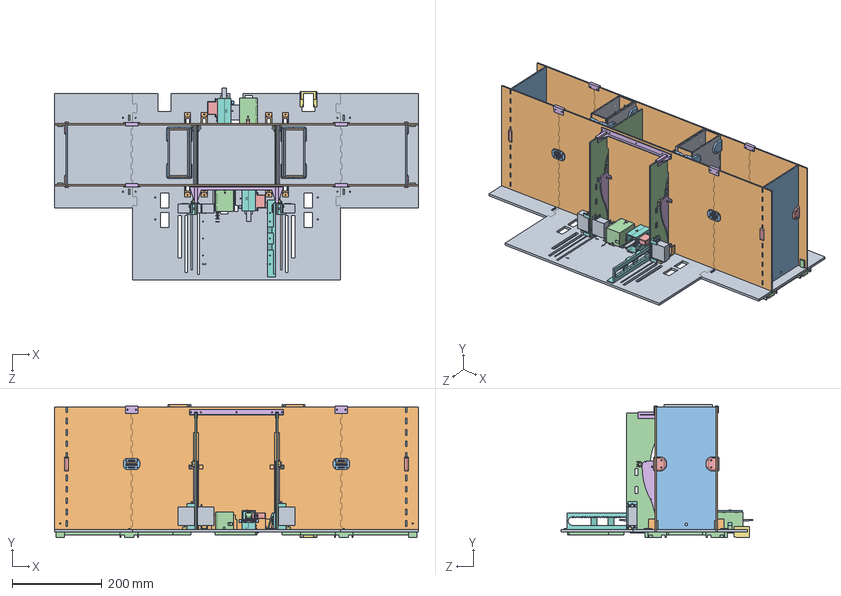
[picture p132: CAD file, 2024-06-27]
V3/preference_TotalAssembly_V3.SLDASM
812.8 x 297.7 x 428.2 mm
preferenceV2_chamberBottom x 3
preferenceV2_chamberFront x 6
preferenceV2_chamberSide x 2
preferenceV2_door x 2
preferenceV2_door_panelSpacer x 2
2TiltCageV2_doorPanel x 4
AH1_switchOutline x 6
preferenceV2_doorServoMount x 2
servoOutline_DoorServo x 3
pinion_211705_2 x 2
socket head cap screw_am_V3 x 16
flat washer regular_am_V3 x 4
hex nut style 1_am_V3 x 16
preferenceV2_door_guide
preferenceV2_door_GuideFlange x 4
door_rail_SurfaceMount
lvrV2_magnetMount x 3
preferenceV2_irMount x 8
preferenceV2_Extend_bracket x 4
preferenceV2_Extend_Feet x 8
preferenceV2_Extend_LBracket x 4
preferenceV2_Extend_topBracket x 4
preferenceV2_pcbMount
lvrV2_housing_22217 x 4
lvrV2_arm x 2
lvrV2_pin x 2
lvrV2_pinCap x 4
lvrV2_HornAdapter x 2
servoOutline_micro x 2
lvrV2_magnet x 4
socket button head cap screw_am_V3 x 4
Wires^lvrV2_assembly_22217 x 2
front_back x 6
side x 4
wall_bracket x 8
nosepoke x 4
nosepoke_guard x 2
sparkfunIR_casing x 4
nosepoke_guard_backing x 2
nosepoke_magnet_mount x 2
Structural_base_TotalAssembly_V3
