donaldsonlab/Operant-Cage/V3/Lever/nosepoke_V3/preferenceV2_dispenser_IRAssembly - Copy.SLDASM

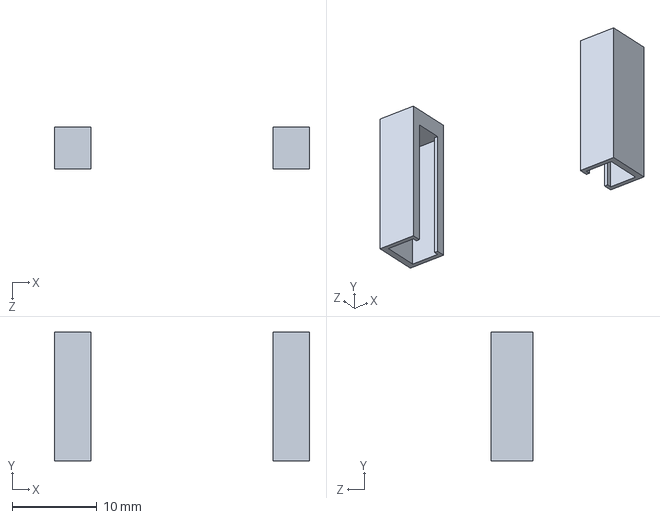
[picture p133: CAD file, 2024-12-18]
V3/Lever/nosepoke_V3/preferenceV2_dispenser_IRAssembly - Copy.SLDASM
30.1 x 15.2 x 5.00 mm
sparkfunIR_casing x 2
