donaldsonlab/Operant-Cage/V3/Lever/nosepoke_CloserIRs/preferenceV2_dispenser_IRAssembly.SLDASM

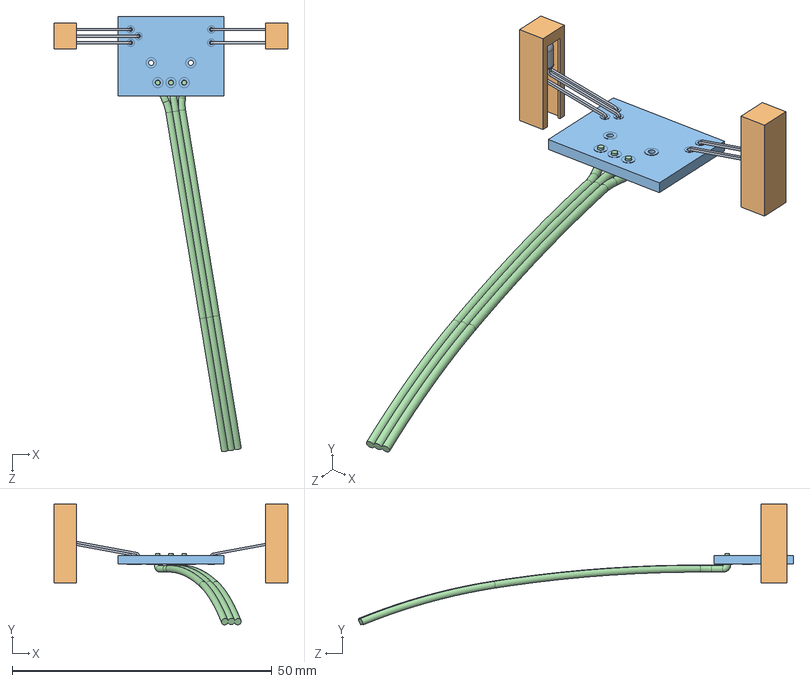
[picture p134: CAD file, 2023-07-26]
V3/Lever/nosepoke_CloserIRs/preferenceV2_dispenser_IRAssembly.SLDASM
45.0 x 23.2 x 83.7 mm
sparkfunIR_LED x 2
sparkfunIR_casing x 2
sparkfunIR_breakoutBoard
dispenser_wires
