donaldsonlab/Operant-Cage/V3/Lever/lvrV2_assembly.SLDASM

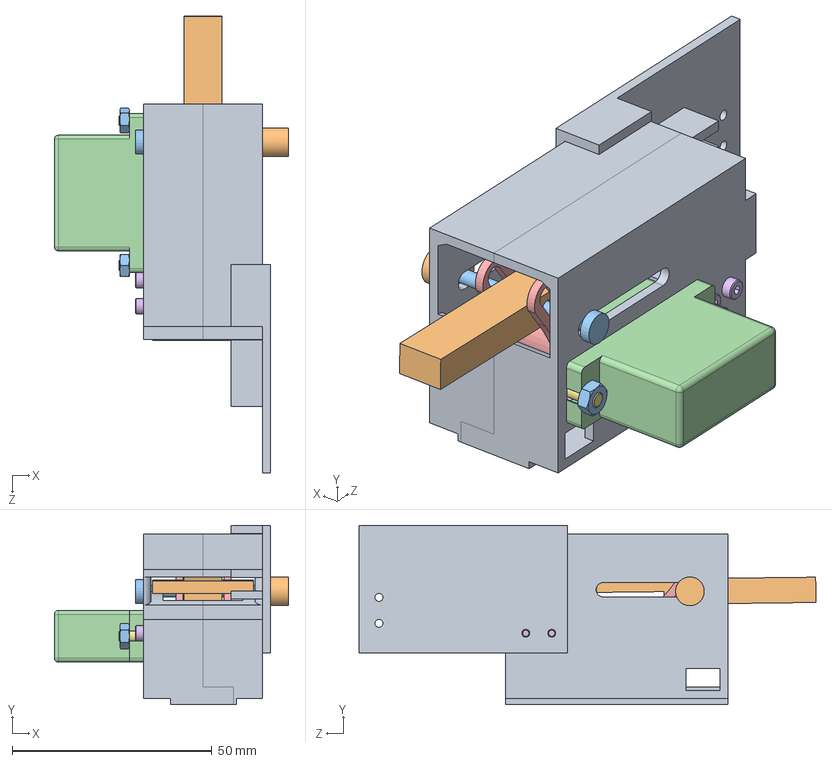
[picture p135: CAD file, 2023-05-15]
V3/Lever/lvrV2_assembly.SLDASM
58.7 x 44.9 x 114.5 mm
lvrV2_housing1 x 2
lvr_armV3
lvr_armPin
servoOutline_micro
lvrV2_HornAdapter
socket head cap screw_am x 2
socket button head cap screw_am x 2
lvr_magnet x 2
lvrV2_armCap
hex nut style 1_am x 2
