donaldsonlab/Operant-Cage/V3/Lever/lvrV2_magnetAssembly.SLDASM

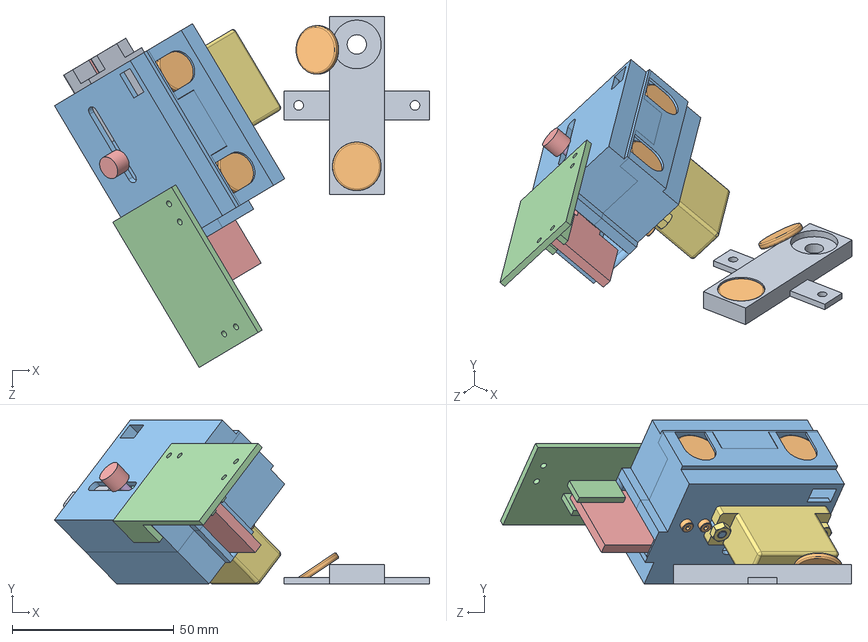
[picture p136: CAD file, 2022-07-01]
V3/Lever/lvrV2_magnetAssembly.SLDASM
116.1 x 50.7 x 108.6 mm
lvrV2_magnetMount
lvr_magnet x 4
lvrV2_housing1 x 2
AH1_switchOutline
lvr_arm
lvr_armPin
servoOutline_micro
lvrV2_HornAdapter
lvrV2_armSleeve
socket head cap screw_am x 2
socket button head cap screw_am x 2
lvrV2_armCap x 2
servoHorn_DoorServo
hex nut style 1_am x 2
