donaldsonlab/Operant-Cage/V3/Lever/nosepoke_V3_extended/nosepoke_assembly_V3.SLDASM

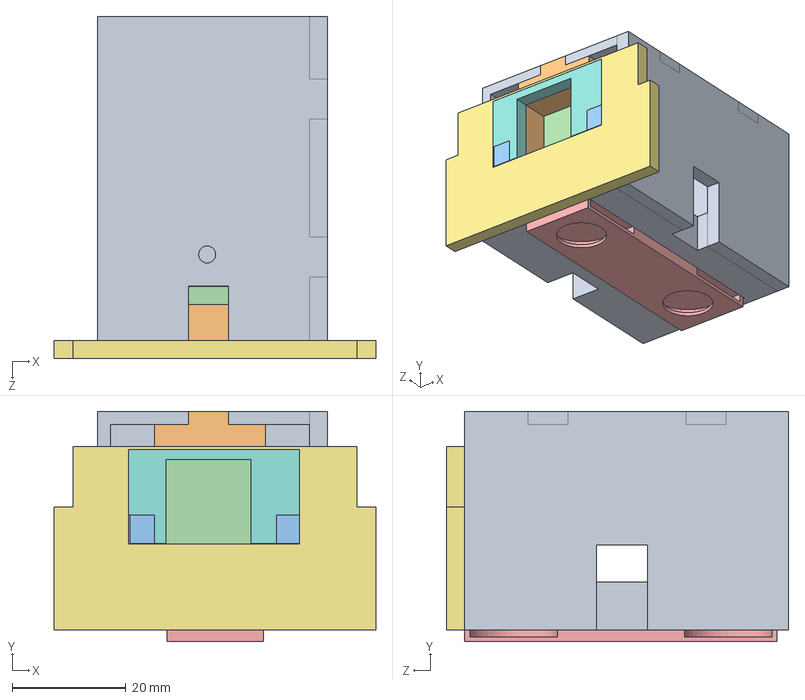
[picture p137: CAD file, 2024-06-27]
V3/Lever/nosepoke_V3_extended/nosepoke_assembly_V3.SLDASM
56.6 x 40.5 x 60.2 mm
nosepoke x 2
nosepoke_guard
sparkfunIR_casing x 2
nosepoke_guard_backing
nosepoke_magnet_mount
