donaldsonlab/Operant-Cage/V3/Lever/lvrV2_housingHalves.SLDASM

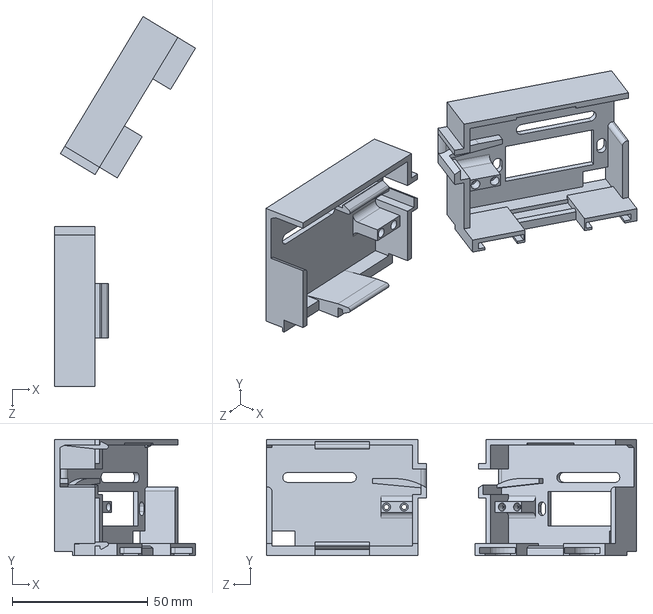
[picture p138: CAD file, 2022-07-01]
V3/Lever/lvrV2_housingHalves.SLDASM
52.0 x 42.8 x 136.3 mm
lvrV2_housing1 x 2
