donaldsonlab/Operant-Cage/GLOBAL/D2RV_L13/D2RV_L13_BASE_FLAT.SLDPRT

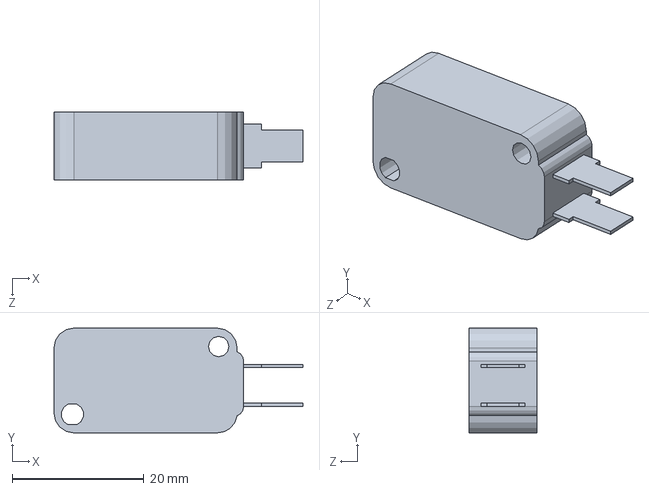
[picture p139: CAD file, 2021-05-10]
GLOBAL/D2RV_L13/D2RV_L13_BASE_FLAT.SLDPRT
37.8 x 15.9 x 10.3 mm
