donaldsonlab/Operant-Cage/GLOBAL/Door/door_rail.SLDPRT

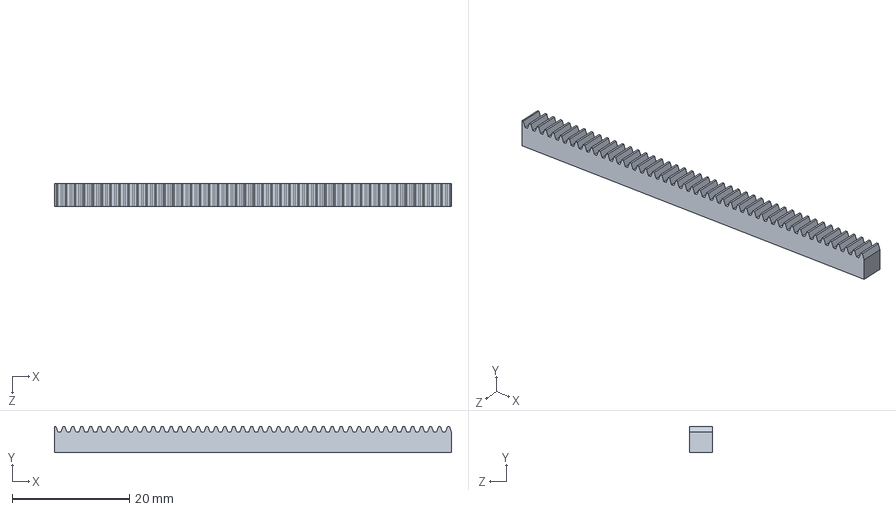
[picture p140: CAD file, 2021-06-29]
GLOBAL/Door/door_rail.SLDPRT
67.7 x 4.50 x 4.00 mm
