donaldsonlab/Operant-Cage/GLOBAL/Food Dispenser/feedingDisk.SLDPRT

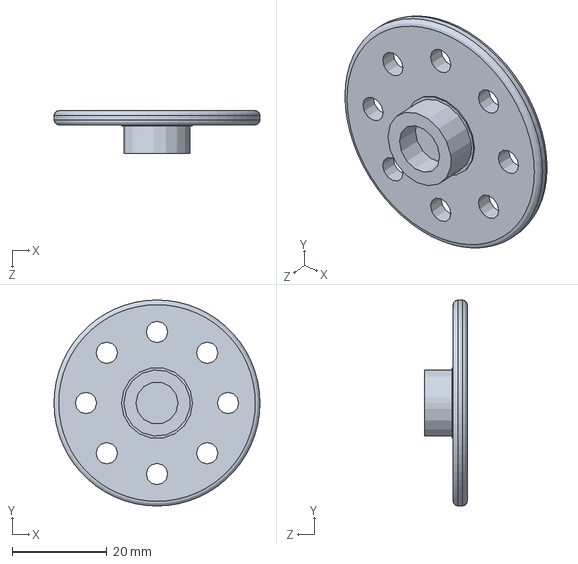
[picture p141: CAD file, 2021-05-10]
GLOBAL/Food Dispenser/feedingDisk.SLDPRT
43.5 x 43.5 x 9.00 mm
