donaldsonlab/Operant-Cage/GLOBAL/Lever/lvr_armPin.SLDPRT

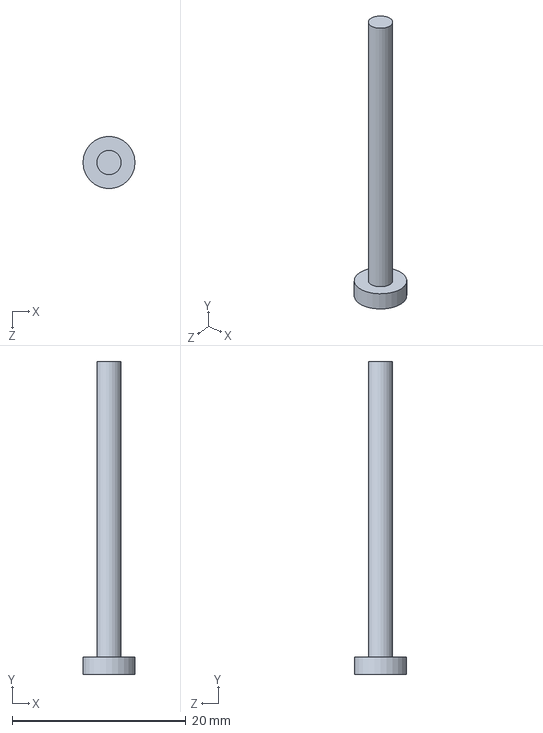
[picture p142: CAD file, 2022-07-01]
GLOBAL/Lever/lvr_armPin.SLDPRT
6.00 x 36.0 x 5.96 mm
