donaldsonlab/Operant-Cage/GLOBAL/Motors/servoOutline_DoorServo.SLDPRT

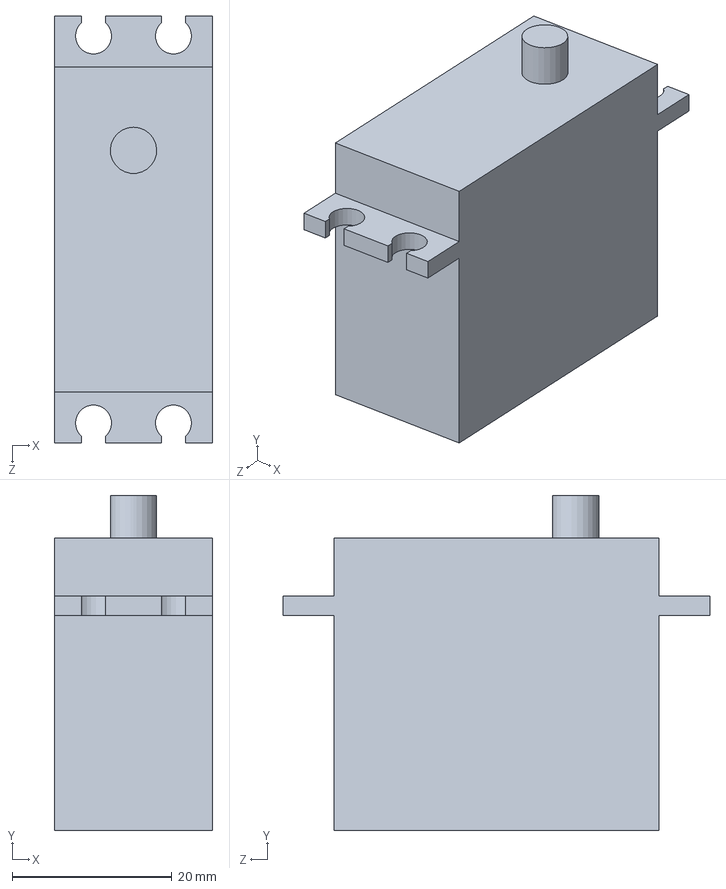
[picture p143: CAD file, 2023-07-24]
GLOBAL/Motors/servoOutline_DoorServo.SLDPRT
19.8 x 41.9 x 53.4 mm
