donaldsonlab/Operant-Cage/GLOBAL/STL/servoJig_leverSpacer.STL

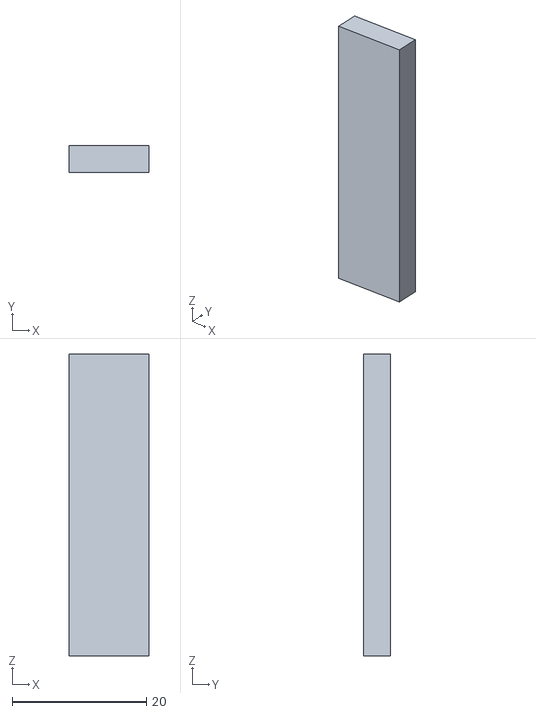
[picture p144: CAD file, 2021-05-10]
GLOBAL/STL/servoJig_leverSpacer.STL
11.9 x 4.00 x 45.0
