donaldsonlab/Operant-Cage/Operant Cage Drawing Files Scoped Voles - 20241001/preferenceV2_Extend_Feet_short.STL

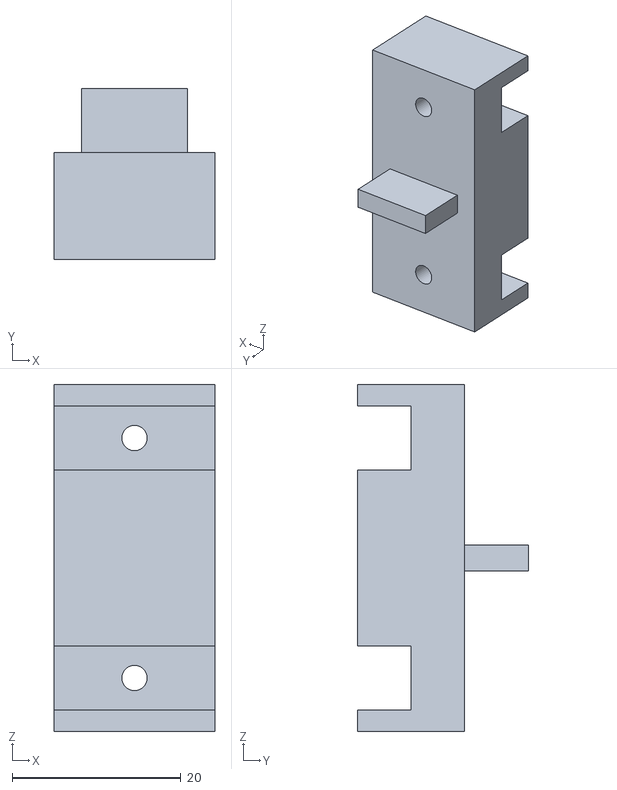
[picture p145: CAD file, 2024-09-05]
Operant Cage Drawing Files Scoped Voles - 20241001/preferenceV2_Extend_Feet_short.STL
19.1 x 20.3 x 41.1
