donaldsonlab/Operant-Cage/V3/Chamber/Interaction_Box/printing/Interaction_Box_Cover.DXF

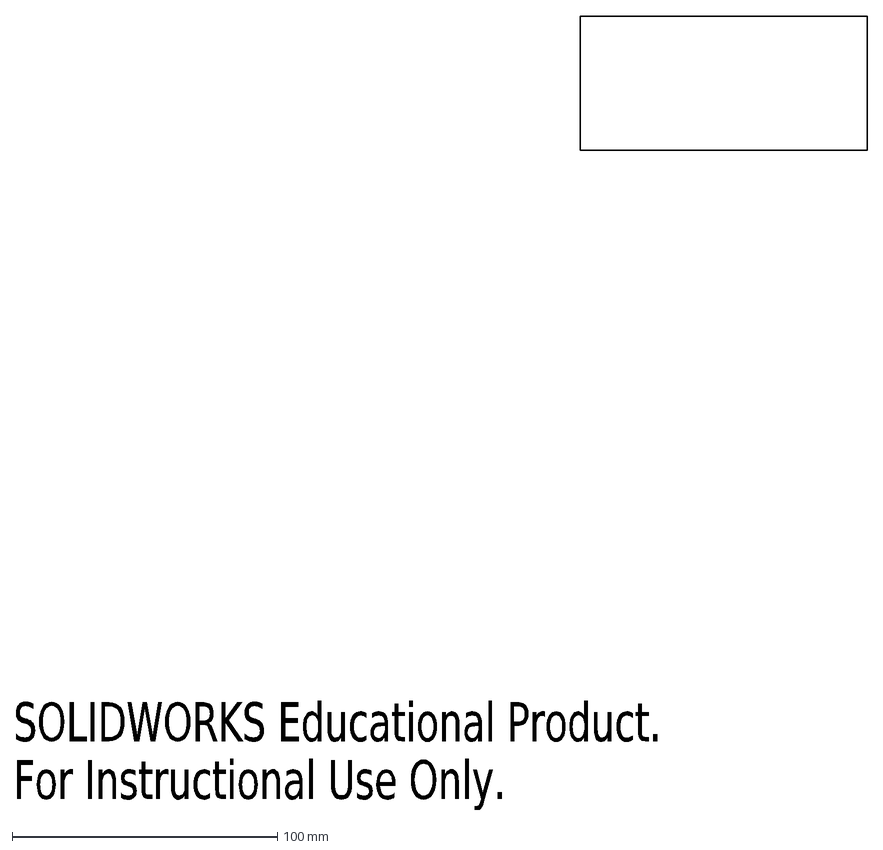
[picture p146: CAD file, 2023-07-26]
V3/Chamber/Interaction_Box/printing/Interaction_Box_Cover.DXF
SOLIDWORKS Educational Product.
For Instructional Use Only.
