donaldsonlab/Operant-Cage/V3/Chamber/New interaction box/20240415_drawing_files/side_v2.DXF

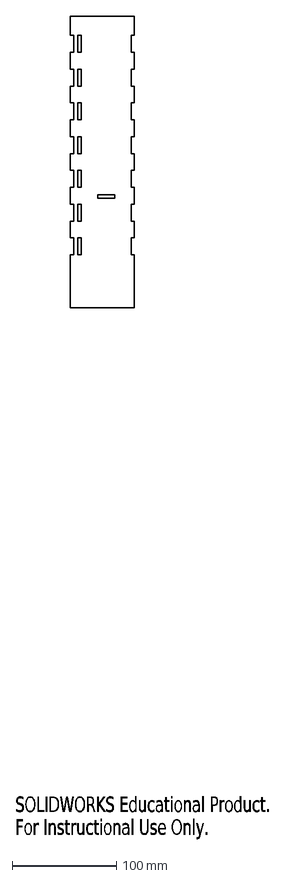
[picture p147: CAD file, 2024-11-19]
V3/Chamber/New interaction box/20240415_drawing_files/side_v2.DXF
SOLIDWORKS Educational Product.
For Instructional Use Only.
