donaldsonlab/Operant-Cage/V3/Chamber/New interaction box/20240521_new_interaction_box/front_back.DXF

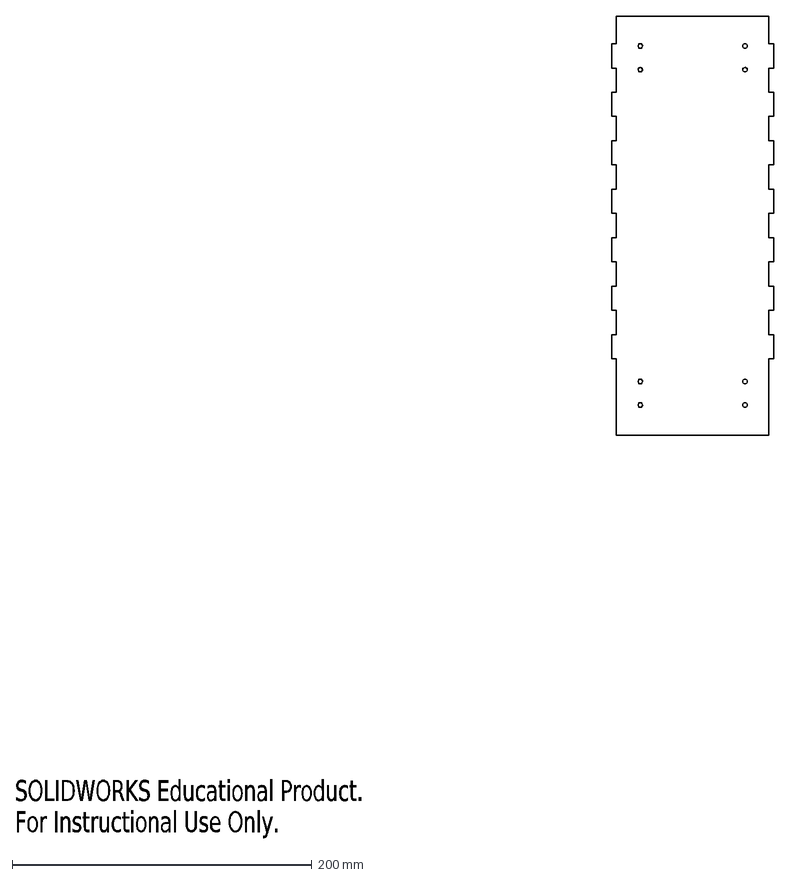
[picture p148: CAD file, 2024-09-05]
V3/Chamber/New interaction box/20240521_new_interaction_box/front_back.DXF
SOLIDWORKS Educational Product.
For Instructional Use Only.
