donaldsonlab/Operant-Cage/V3/Chamber/New interaction box/side.SLDPRT

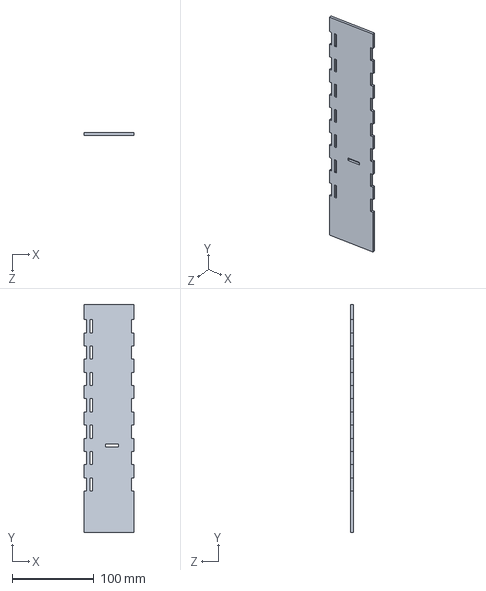
[picture p149: CAD file, 2024-11-19]
V3/Chamber/New interaction box/side.SLDPRT
61.4 x 279.4 x 3.17 mm
