donaldsonlab/Operant-Cage/V3/Chamber/printing/basex2.DXF

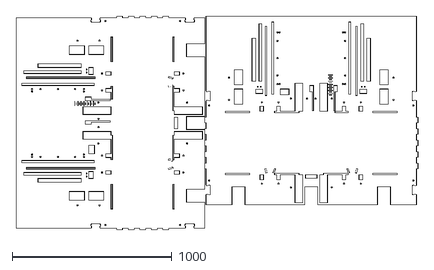
[picture p151: CAD file, 2023-06-13]
V3/Chamber/printing/basex2.DXF
2514.0 x 1335.0
