donaldsonlab/Operant-Cage/V3/Chamber/scoped nosepokes/preferenceV2_chamberFront_nosepokes_scoped.DXF

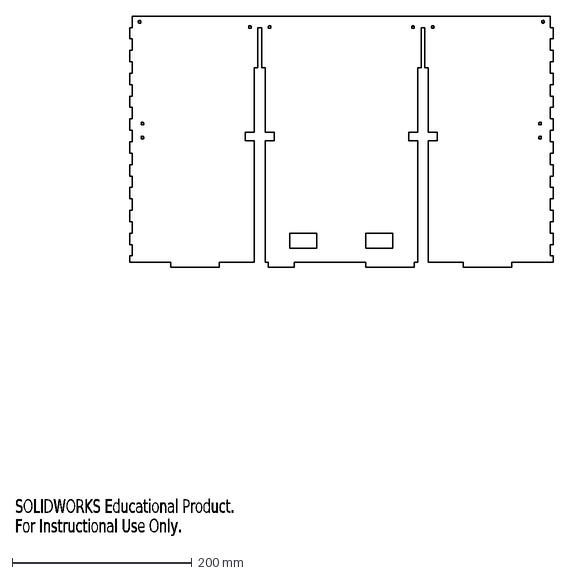
[picture p152: CAD file, 2024-09-05]
V3/Chamber/scoped nosepokes/preferenceV2_chamberFront_nosepokes_scoped.DXF
SOLIDWORKS Educational Product.
For Instructional Use Only.
