donaldsonlab/Operant-Cage/V3/Dispenser/printing/preferenceV2_dispenser_feedingDisk_4hole.STL

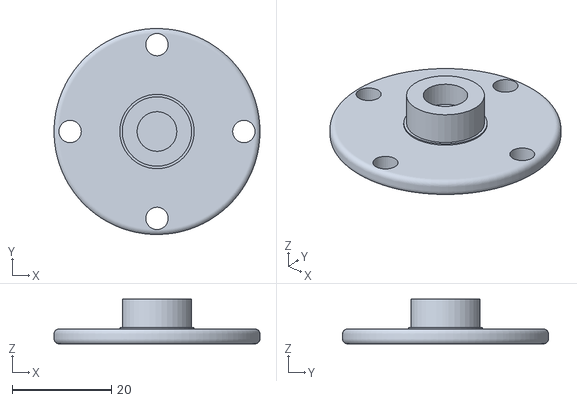
[picture p153: CAD file, 2023-02-03]
V3/Dispenser/printing/preferenceV2_dispenser_feedingDisk_4hole.STL
41.5 x 41.5 x 9.00
