donaldsonlab/Operant-Cage/V3/Door/preferenceV2_door_larger_gap.SLDPRT

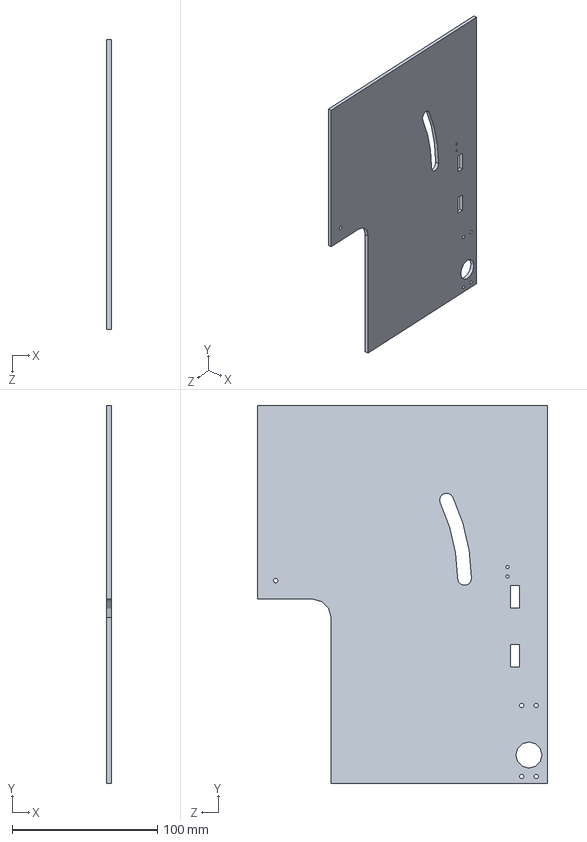
[picture p154: CAD file, 2024-12-18]
V3/Door/preferenceV2_door_larger_gap.SLDPRT
3.17 x 260.3 x 200.0 mm
