donaldsonlab/Operant-Cage/V3/Door/printing/pinion.STL

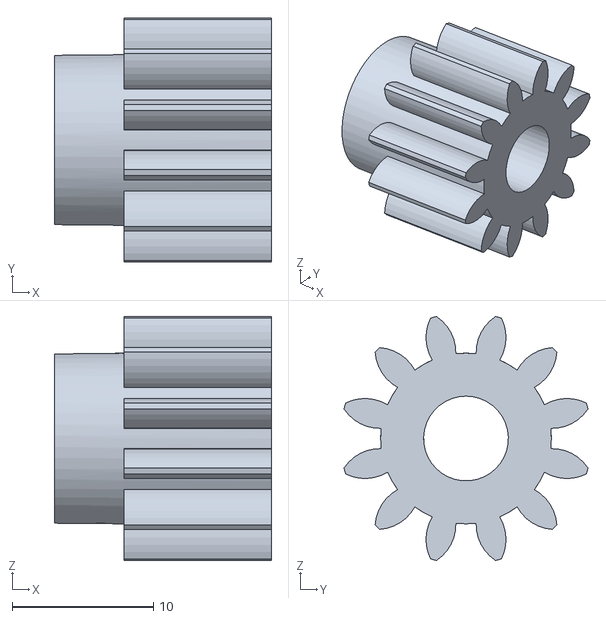
[picture p155: CAD file, 2022-08-15]
V3/Door/printing/pinion.STL
15.4 x 17.3 x 17.3
