donaldsonlab/Operant-Cage/V3/Extra Feet/preferenceV3_Extend_Feet_Extra_ thinner.SLDPRT

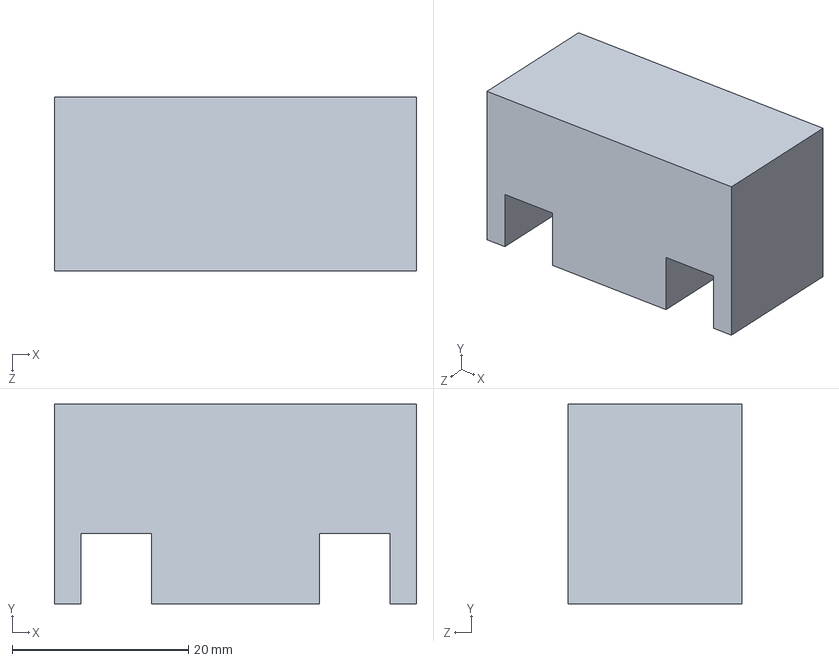
[picture p157: CAD file, 2024-11-19]
V3/Extra Feet/preferenceV3_Extend_Feet_Extra_ thinner.SLDPRT
41.1 x 22.7 x 19.7 mm
