donaldsonlab/Operant-Cage/V3/Lever/nosepoke_CloserIRs/nosepoke_guard.SLDPRT

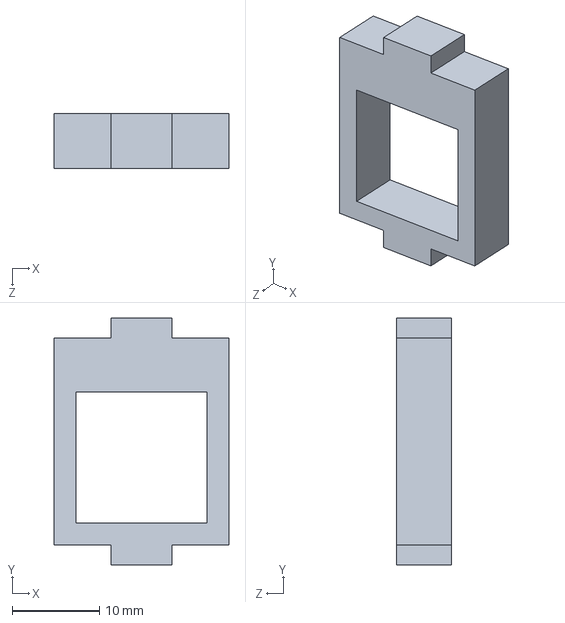
[picture p158: CAD file, 2024-11-25]
V3/Lever/nosepoke_CloserIRs/nosepoke_guard.SLDPRT
20.0 x 28.3 x 6.35 mm
