donaldsonlab/Operant-Cage/V3/Lever/nosepoke_V3/nosepoke_guard_backing.SLDPRT

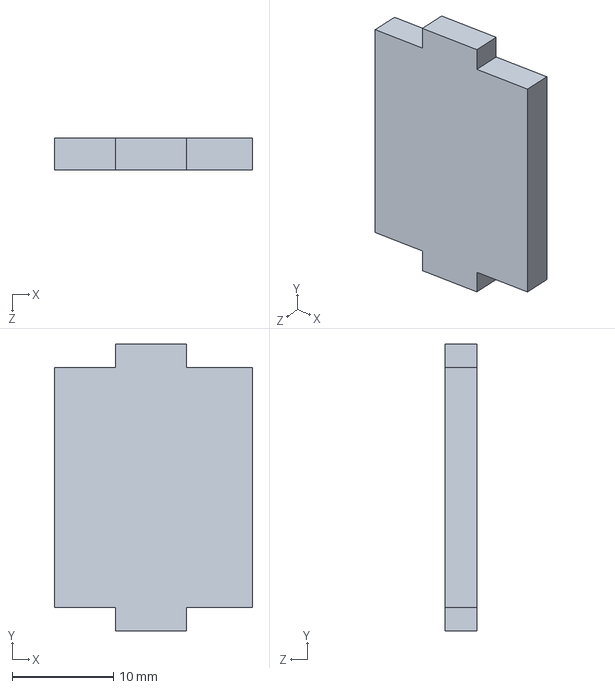
[picture p159: CAD file, 2024-12-18]
V3/Lever/nosepoke_V3/nosepoke_guard_backing.SLDPRT
19.5 x 28.3 x 3.17 mm
