donaldsonlab/Operant-Cage/V3/Lever/nosepoke_V3_extended - rotated IRs/extended_drw_v4/outside guard extended second face.DXF

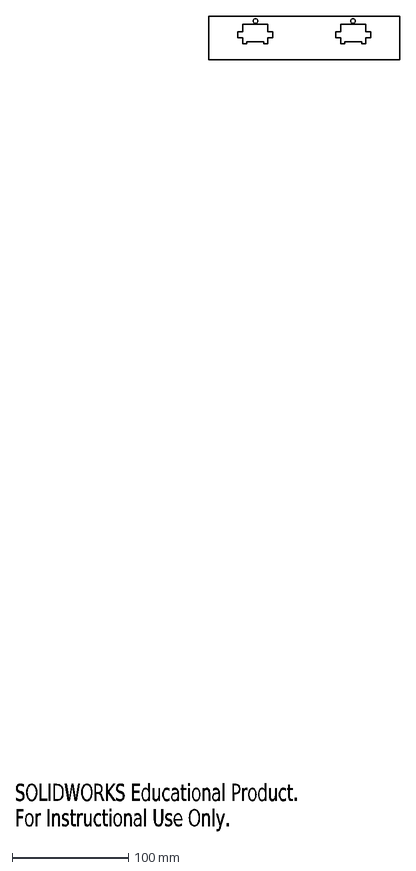
[picture p160: CAD file, 2024-09-05]
V3/Lever/nosepoke_V3_extended - rotated IRs/extended_drw_v4/outside guard extended second face.DXF
SOLIDWORKS Educational Product.
For Instructional Use Only.
