donaldsonlab/Operant-Cage/V3/Lever/nosepoke_V3_extended - rotated IRs/Food dispenser mod.SLDPRT

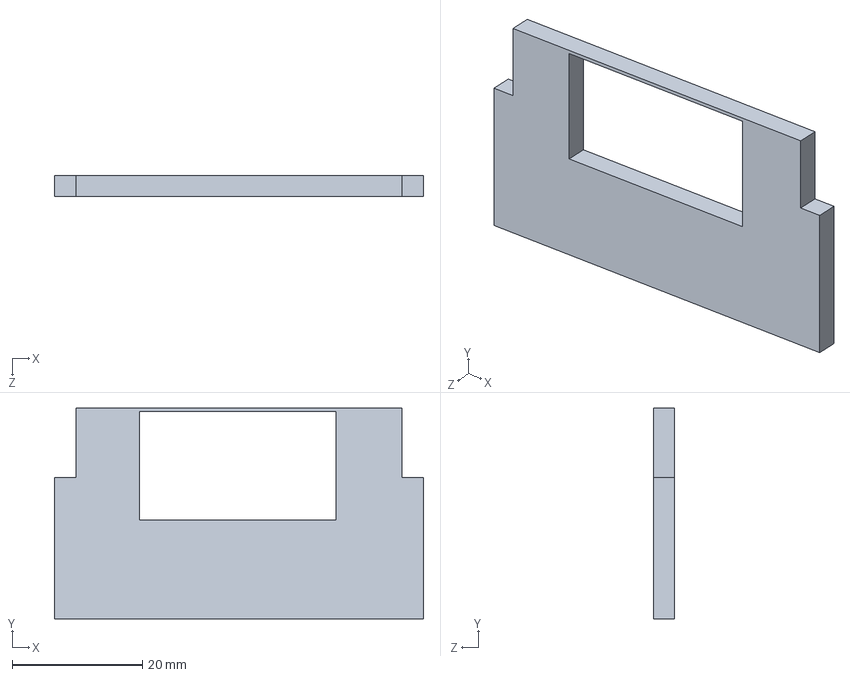
[picture p161: CAD file, 2024-11-25]
V3/Lever/nosepoke_V3_extended - rotated IRs/Food dispenser mod.SLDPRT
56.6 x 32.3 x 3.17 mm
