donaldsonlab/Operant-Cage/V3/Lever/nosepoke_V3_extended - rotated IRs/New folder/side_guard_A.DXF

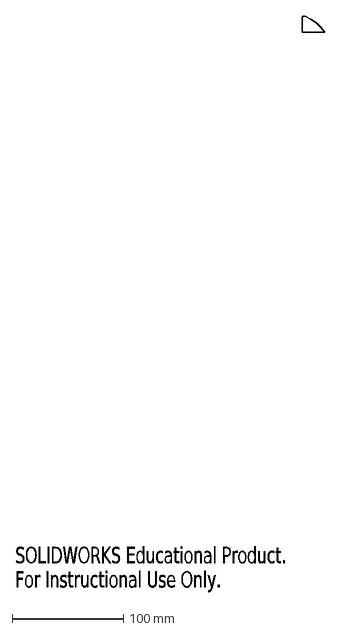
[picture p162: CAD file, 2024-11-25]
V3/Lever/nosepoke_V3_extended - rotated IRs/New folder/side_guard_A.DXF
SOLIDWORKS Educational Product.
For Instructional Use Only.
