donaldsonlab/Operant-Cage/V3/Lever/nosepoke_V3_extended/extended_drawing_files/outside guard extended.DXF

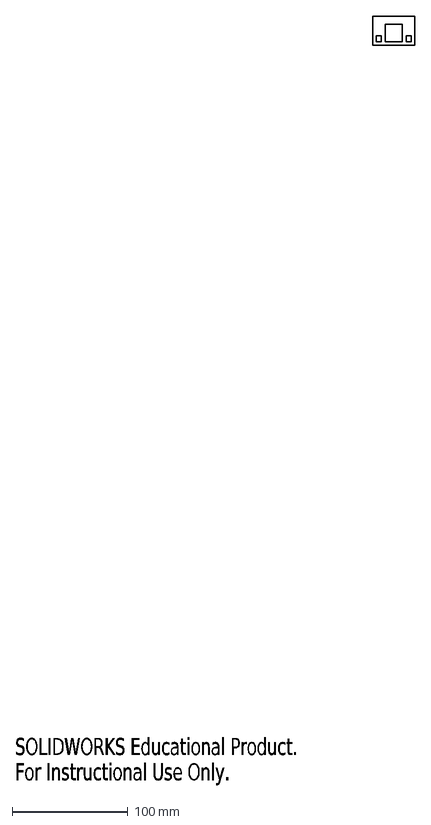
[picture p163: CAD file, 2024-11-25]
V3/Lever/nosepoke_V3_extended/extended_drawing_files/outside guard extended.DXF
SOLIDWORKS Educational Product.
For Instructional Use Only.
