donaldsonlab/Operant-Cage/V3/Lever/nosepoke_V3_extended/extended_drw_v4/inner walls.DXF

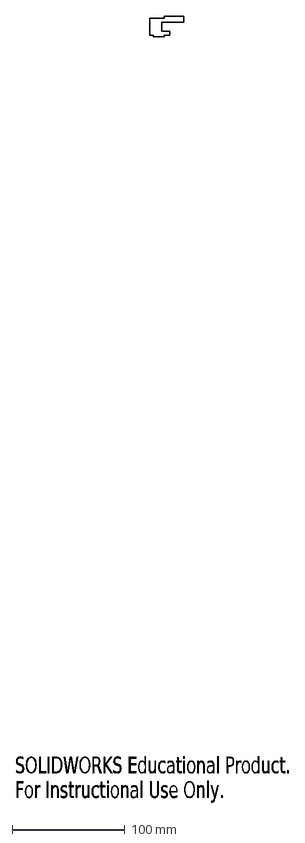
[picture p164: CAD file, 2024-09-05]
V3/Lever/nosepoke_V3_extended/extended_drw_v4/inner walls.DXF
SOLIDWORKS Educational Product.
For Instructional Use Only.
