donaldsonlab/Operant-Cage/V3/Lever/nosepoke_V3_extended/New folder/inner wall.DXF

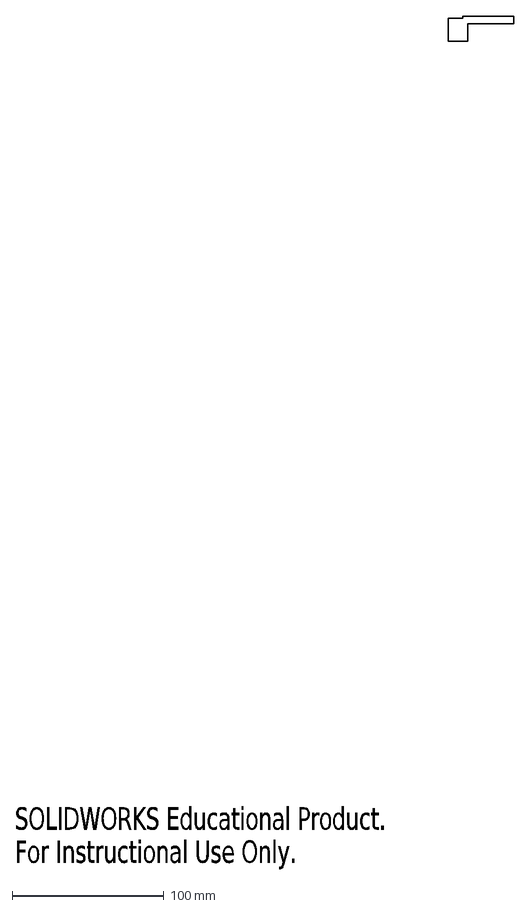
[picture p165: CAD file, 2024-11-25]
V3/Lever/nosepoke_V3_extended/New folder/inner wall.DXF
SOLIDWORKS Educational Product.
For Instructional Use Only.
