donaldsonlab/Operant-Cage/V3/Lever/printing/lvrV2_housing_tall_rightSide.STL

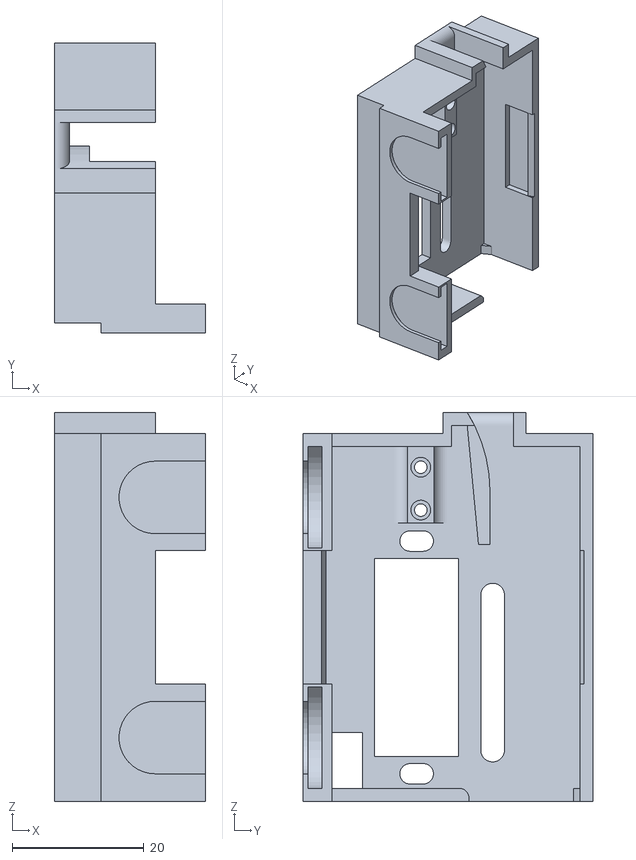
[picture p166: CAD file, 2023-05-15]
V3/Lever/printing/lvrV2_housing_tall_rightSide.STL
22.9 x 44.0 x 59.0
