donaldsonlab/Operant-Cage/V3/operant box_bracket_B.SLDPRT

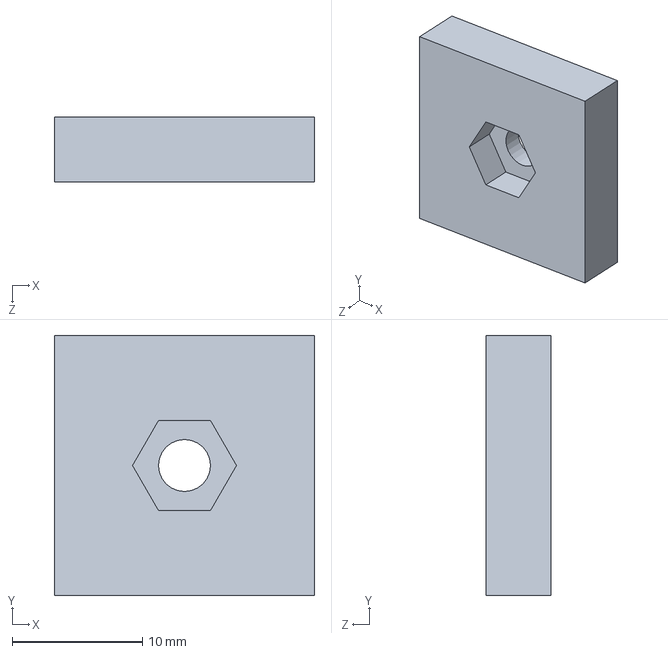
[picture p167: CAD file, 2024-12-18]
V3/operant box_bracket_B.SLDPRT
20.0 x 20.0 x 5.00 mm
