donaldsonlab/Operant-Cage/V3/STL/bw_LBracket.STL

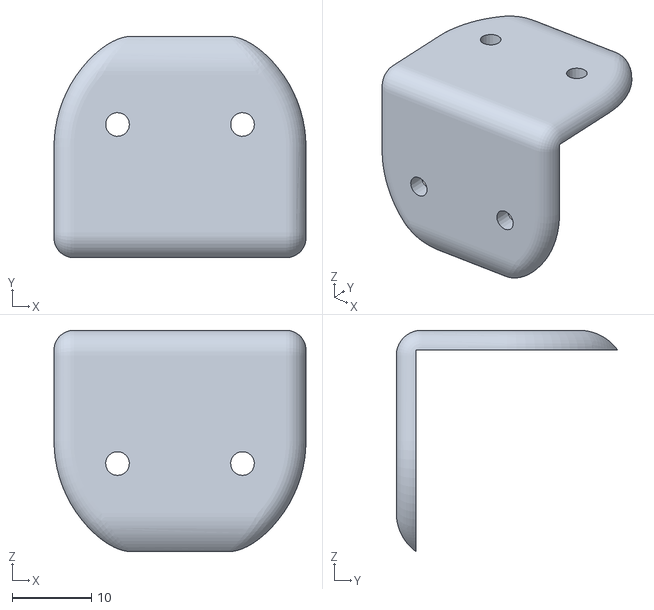
[picture p168: CAD file, 2022-07-01]
V3/STL/bw_LBracket.STL
31.8 x 27.9 x 27.9
