donaldsonlab/Operant-Cage/GLOBAL/D2RV_L13/D2RV_L13_BASE.SLDPRT

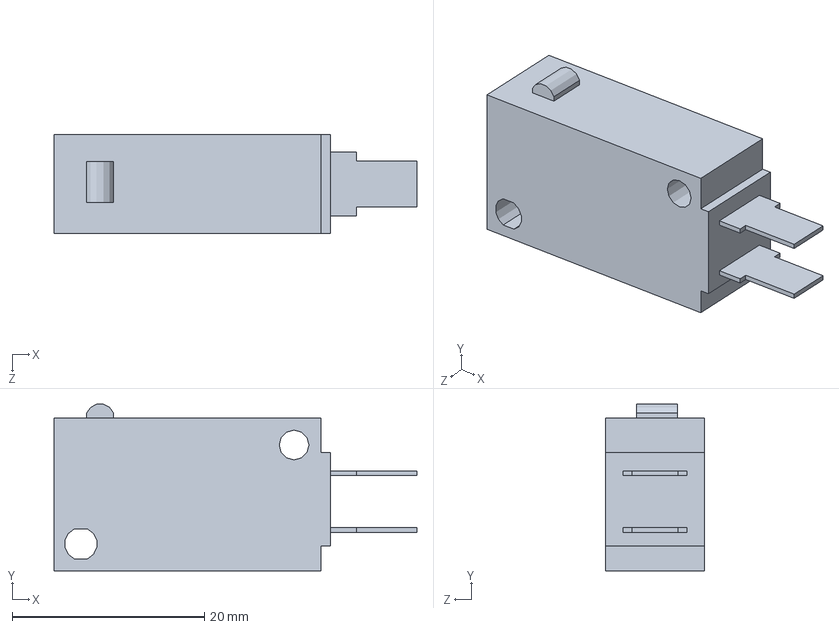
[picture p169: CAD file, 2021-05-10]
GLOBAL/D2RV_L13/D2RV_L13_BASE.SLDPRT
37.8 x 17.3 x 10.3 mm
