donaldsonlab/Operant-Cage/GLOBAL/Door/pinion_201007.SLDPRT

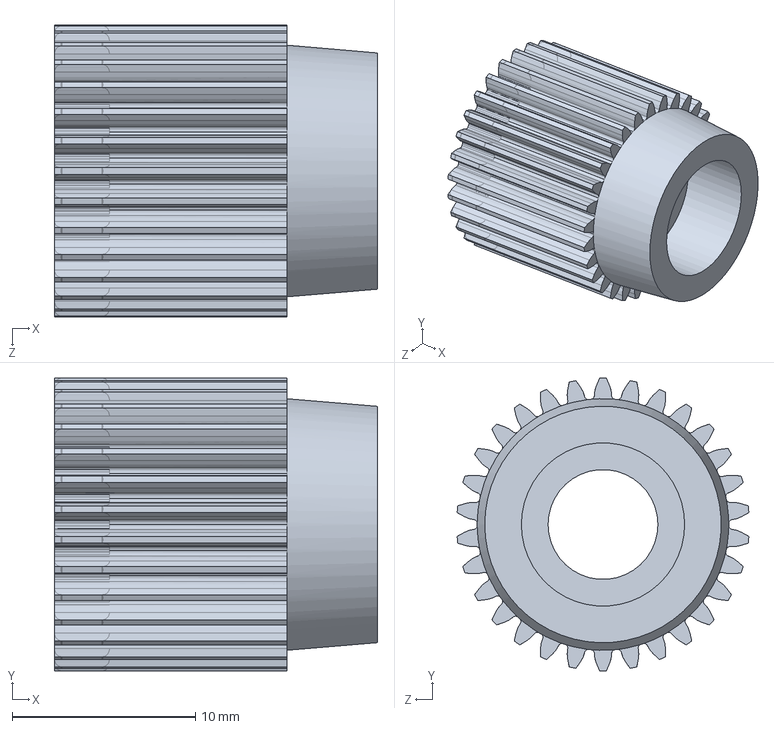
[picture p170: CAD file, 2021-06-29]
GLOBAL/Door/pinion_201007.SLDPRT
17.6 x 16.0 x 15.9 mm
