donaldsonlab/Operant-Cage/GLOBAL/Lever/lvr_armPinClip.SLDPRT

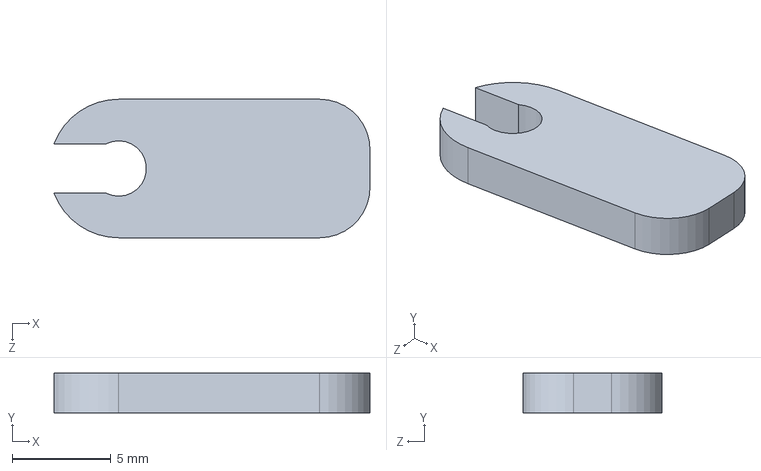
[picture p171: CAD file, 2021-06-29]
GLOBAL/Lever/lvr_armPinClip.SLDPRT
16.0 x 2.00 x 7.00 mm
