donaldsonlab/Operant-Cage/GLOBAL/Motors/servoOutline_micro.SLDPRT

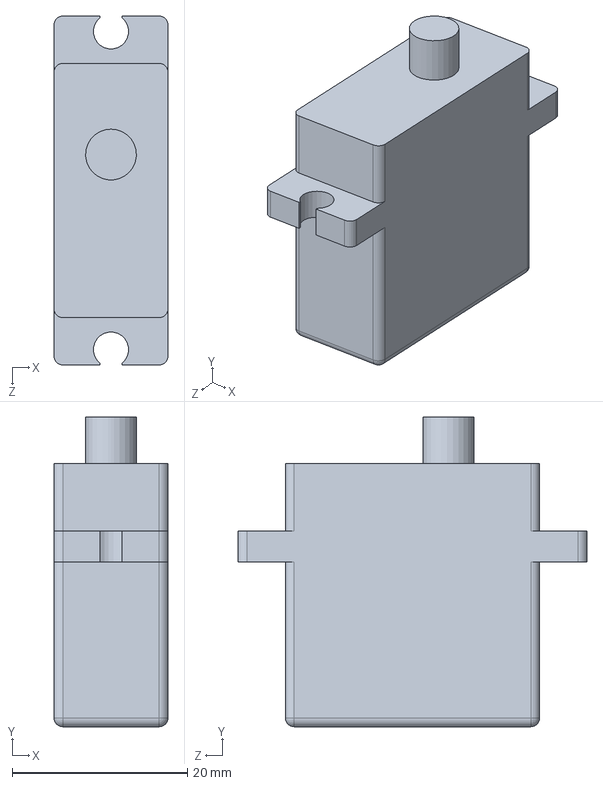
[picture p172: CAD file, 2022-07-01]
GLOBAL/Motors/servoOutline_micro.SLDPRT
13.0 x 35.3 x 39.8 mm
