donaldsonlab/Operant-Cage/Operant Cage Drawing Files Scoped Voles - 20241001/preferenceV2_Extend_bracket.STL

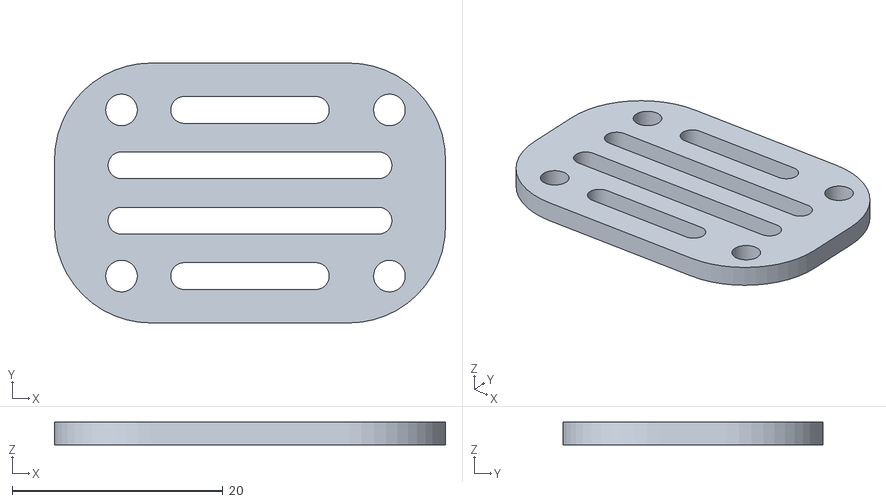
[picture p173: CAD file, 2024-09-05]
Operant Cage Drawing Files Scoped Voles - 20241001/preferenceV2_Extend_bracket.STL
37.1 x 24.6 x 2.16
