donaldsonlab/Operant-Cage/V3/Chamber/New interaction box/20240415_drawing_files/side.DXF

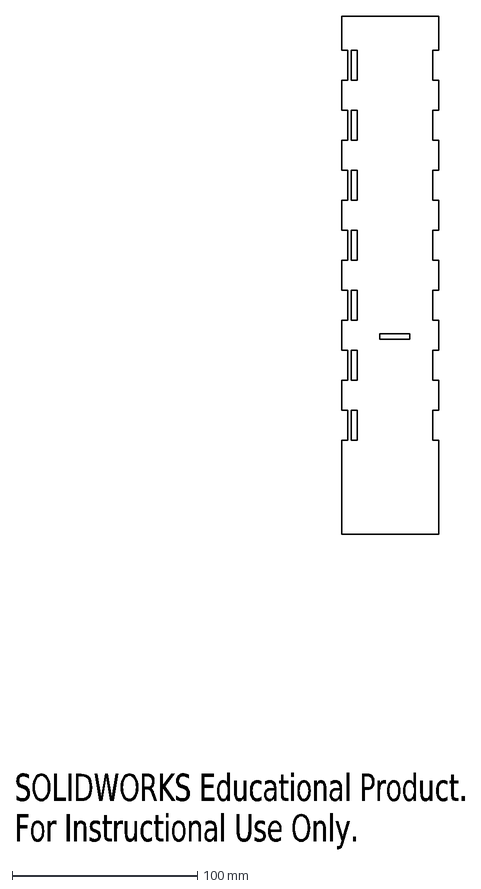
[picture p174: CAD file, 2024-11-19]
V3/Chamber/New interaction box/20240415_drawing_files/side.DXF
SOLIDWORKS Educational Product.
For Instructional Use Only.
