donaldsonlab/Operant-Cage/V3/Chamber/New interaction box/20240521_new_interaction_box/side.DXF

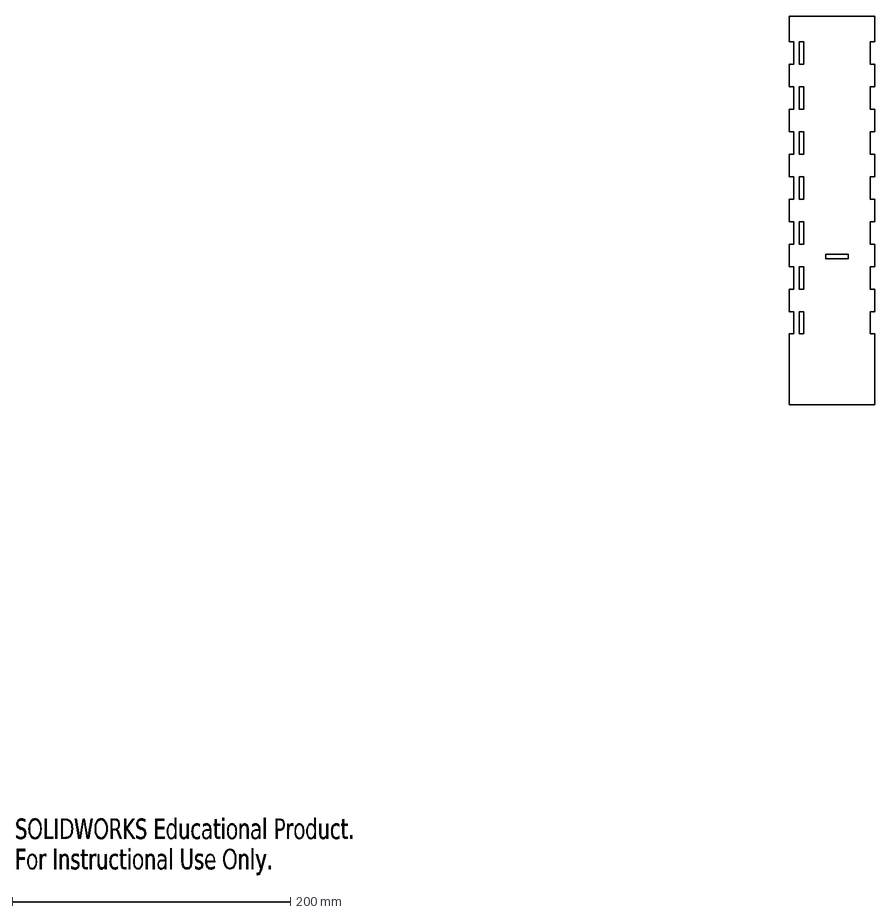
[picture p175: CAD file, 2024-09-05]
V3/Chamber/New interaction box/20240521_new_interaction_box/side.DXF
SOLIDWORKS Educational Product.
For Instructional Use Only.
