donaldsonlab/Operant-Cage/V3/Chamber/New interaction box/interaction_lid.SLDPRT

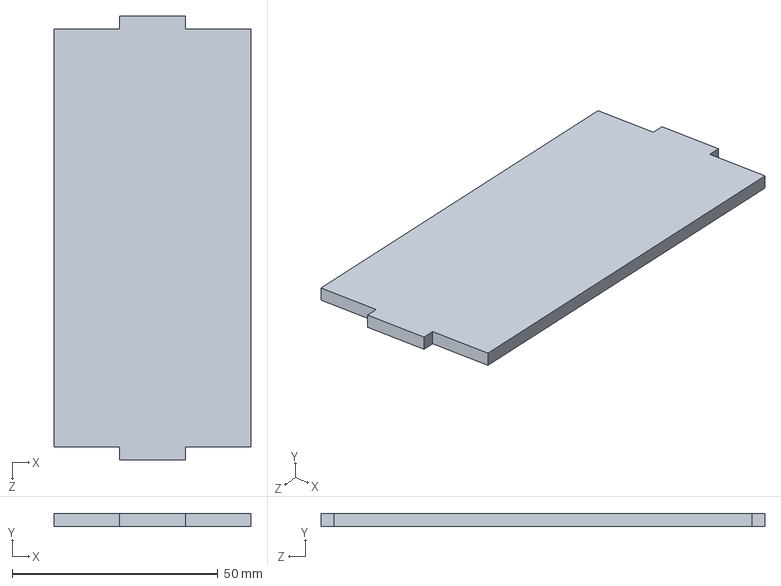
[picture p176: CAD file, 2024-11-19]
V3/Chamber/New interaction box/interaction_lid.SLDPRT
47.8 x 3.17 x 107.9 mm
