donaldsonlab/Operant-Cage/V3/Chamber/preferenceV2_chamberFront_nosepokes_scoped.SLDPRT

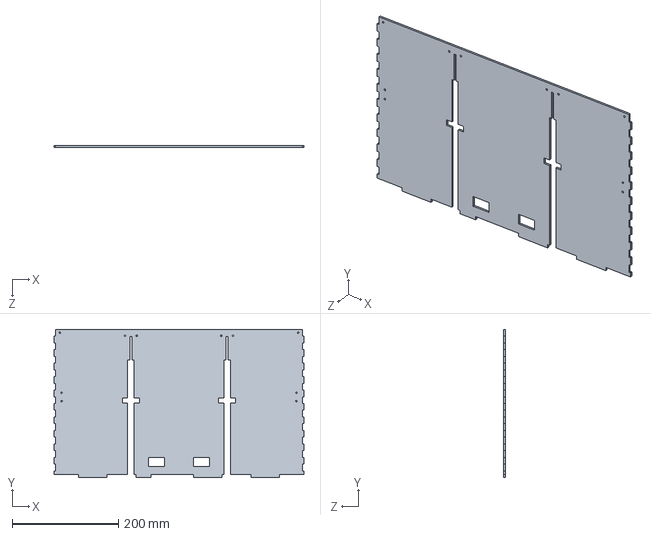
[picture p177: CAD file, 2024-12-18]
V3/Chamber/preferenceV2_chamberFront_nosepokes_scoped.SLDPRT
470.8 x 279.4 x 3.17 mm
