donaldsonlab/Operant-Cage/V3/Chamber/printing/mesh_dividerx2.DXF

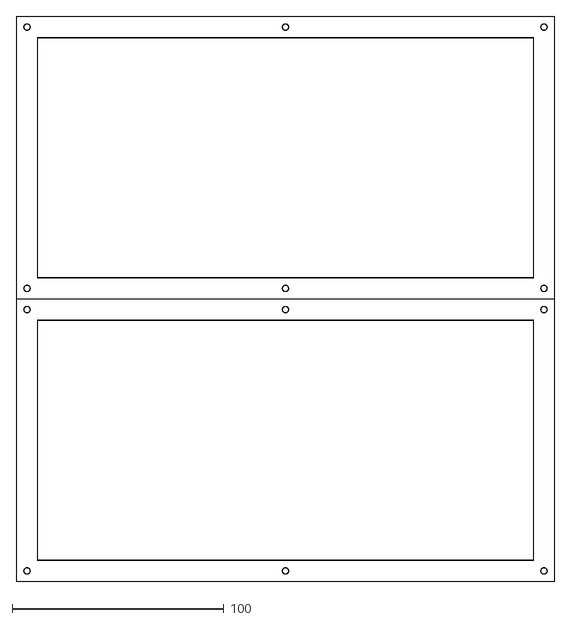
[picture p178: CAD file, 2023-05-15]
V3/Chamber/printing/mesh_dividerx2.DXF
254.4 x 267.1
