donaldsonlab/Operant-Cage/V3/Door/preferenceV2_door_guide_extended.SLDPRT

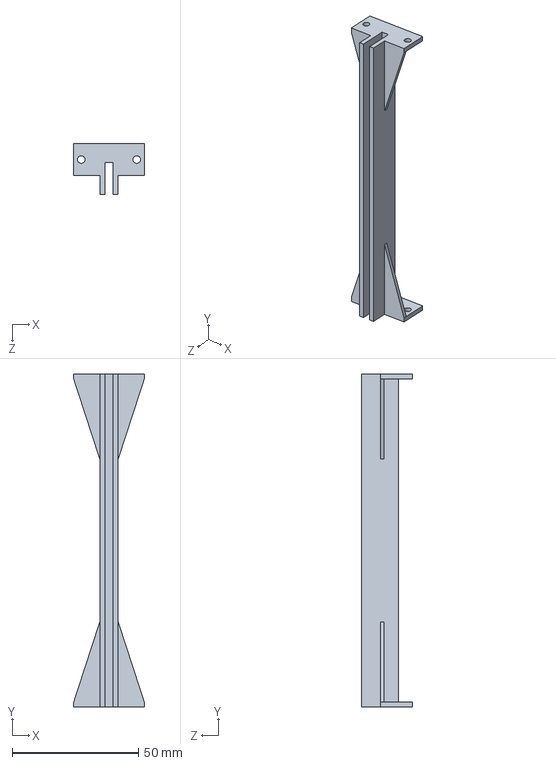
[picture p179: CAD file, 2024-12-18]
V3/Door/preferenceV2_door_guide_extended.SLDPRT
28.0 x 132.1 x 20.2 mm
