donaldsonlab/Operant-Cage/V3/Lever/lvrV2_housing_22217.SLDPRT

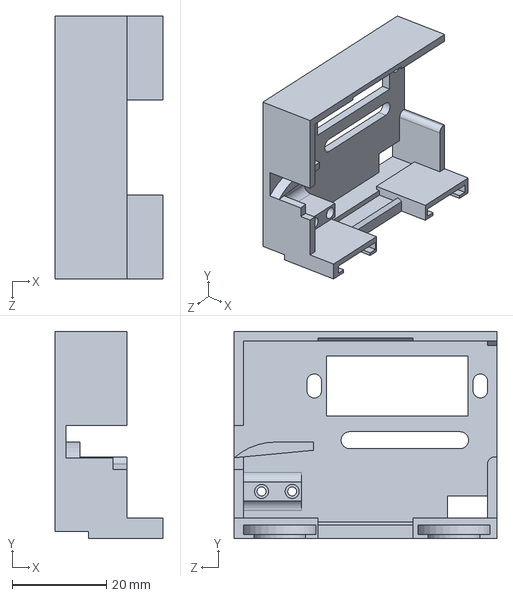
[picture p181: CAD file, 2023-07-26]
V3/Lever/lvrV2_housing_22217.SLDPRT
22.9 x 44.0 x 55.8 mm
