donaldsonlab/Operant-Cage/V3/Lever/nosepoke_V3/nosepoke_new_wall_connector.SLDPRT

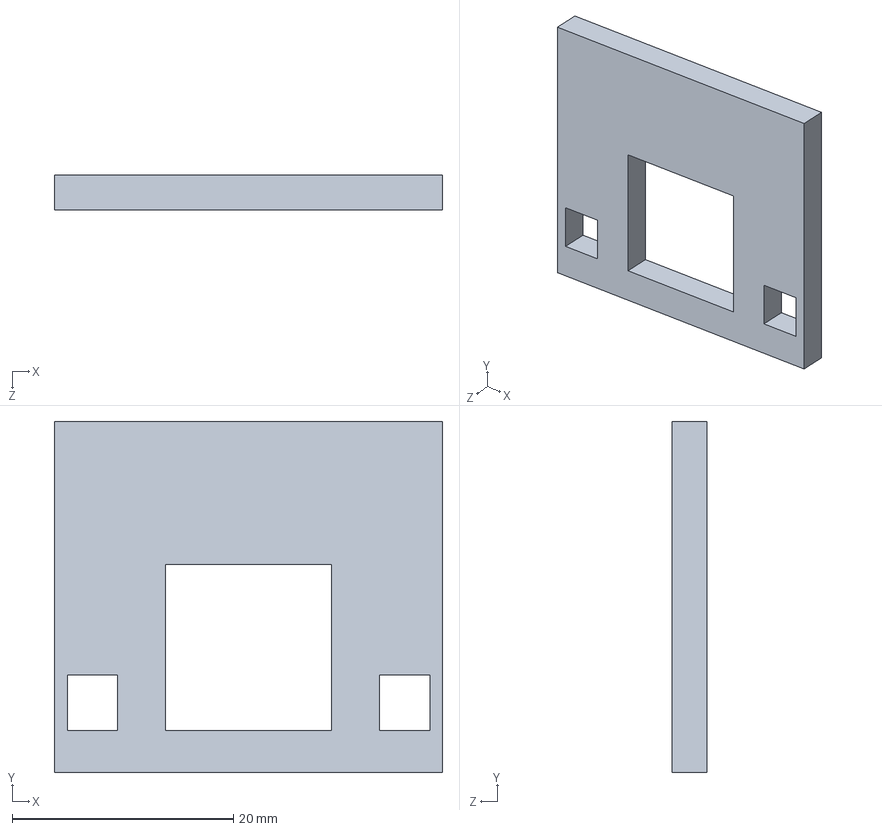
[picture p182: CAD file, 2024-12-18]
V3/Lever/nosepoke_V3/nosepoke_new_wall_connector.SLDPRT
35.1 x 31.8 x 3.17 mm
