donaldsonlab/Operant-Cage/V3/Lever/nosepoke_V3_extended - rotated IRs/extended_drawing_files/outside guard extended_second_v2.DXF

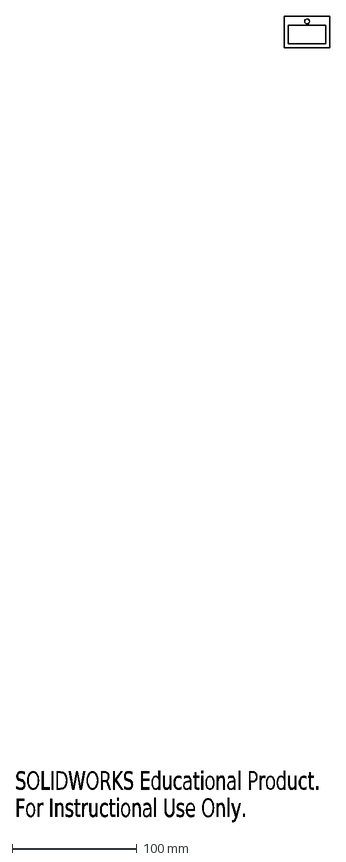
[picture p183: CAD file, 2024-11-25]
V3/Lever/nosepoke_V3_extended - rotated IRs/extended_drawing_files/outside guard extended_second_v2.DXF
SOLIDWORKS Educational Product.
For Instructional Use Only.
