donaldsonlab/Operant-Cage/V3/Lever/nosepoke_V3_extended - rotated IRs/New folder/front_face.DXF

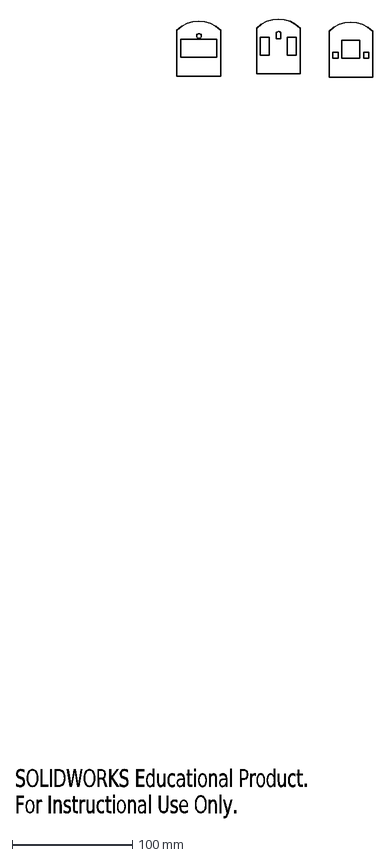
[picture p184: CAD file, 2024-11-25]
V3/Lever/nosepoke_V3_extended - rotated IRs/New folder/front_face.DXF
SOLIDWORKS Educational Product.
For Instructional Use Only.
