donaldsonlab/Operant-Cage/V3/Lever/nosepoke_V3_extended - rotated IRs/Part4.SLDPRT

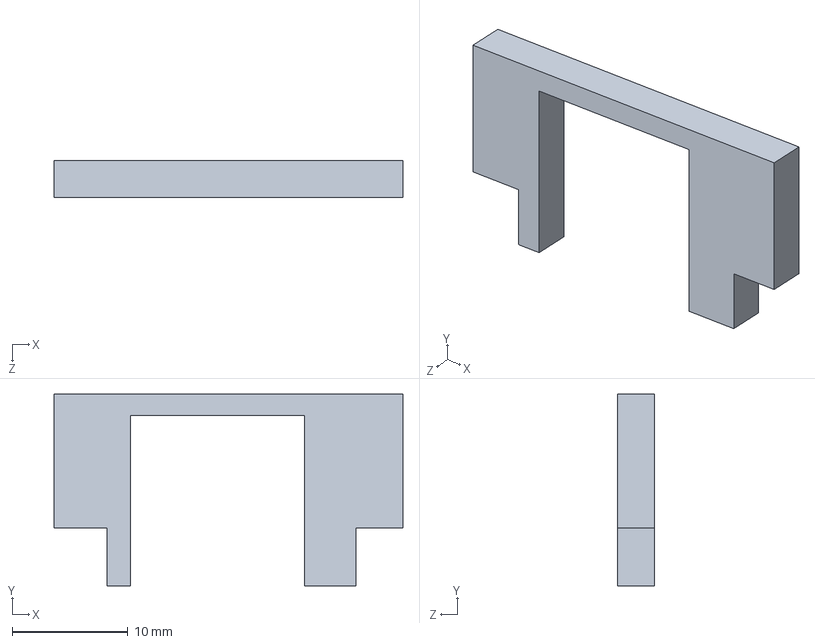
[picture p185: CAD file, 2024-11-25]
V3/Lever/nosepoke_V3_extended - rotated IRs/Part4.SLDPRT
30.1 x 16.5 x 3.17 mm
