donaldsonlab/Operant-Cage/V3/Lever/nosepoke_V3_extended/extended_drawing_files/outside guard extended_back_v2.DXF

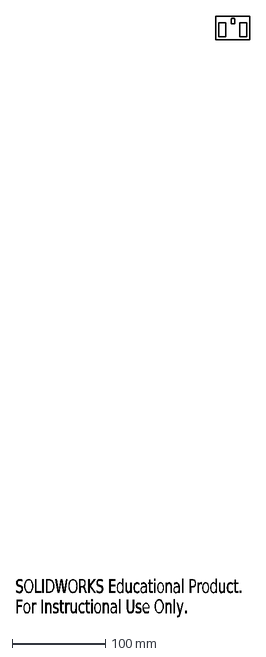
[picture p186: CAD file, 2024-11-25]
V3/Lever/nosepoke_V3_extended/extended_drawing_files/outside guard extended_back_v2.DXF
SOLIDWORKS Educational Product.
For Instructional Use Only.
