donaldsonlab/Operant-Cage/V3/Lever/printing/lvrV2_housing_tall_leftSide.STL

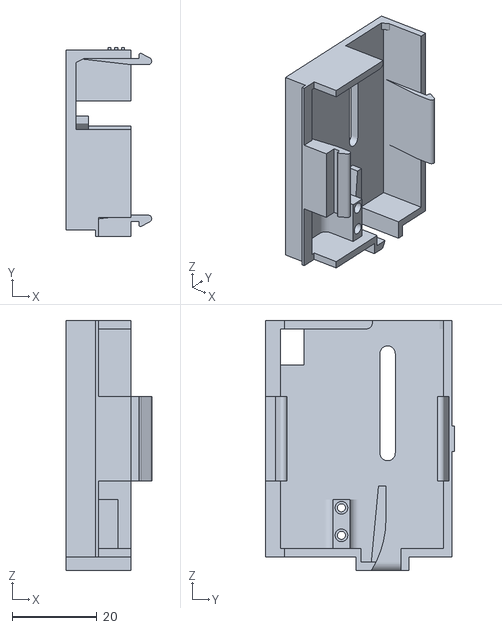
[picture p187: CAD file, 2023-05-15]
V3/Lever/printing/lvrV2_housing_tall_leftSide.STL
20.2 x 44.5 x 59.0
