donaldsonlab/Operant-Cage/V3/STL/preferenceV2_dispenser_funnel.STL

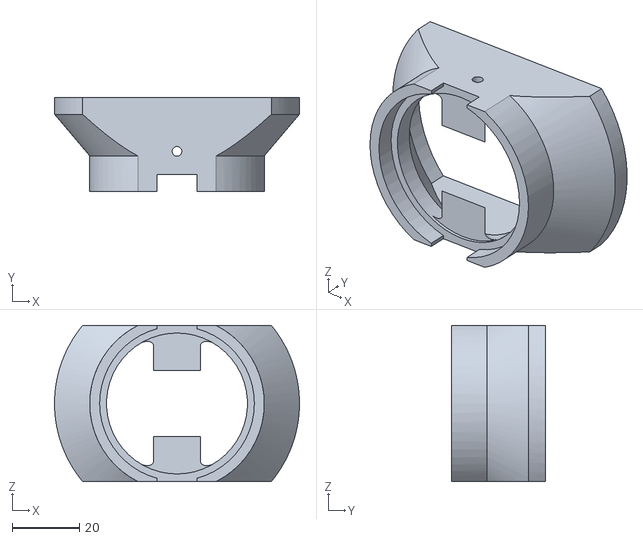
[picture p188: CAD file, 2022-07-01]
V3/STL/preferenceV2_dispenser_funnel.STL
73.0 x 28.0 x 46.5
