donaldsonlab/Operant-Cage/GLOBAL/D2RV_L13/D2RV_L13_ACTUATOR.SLDPRT

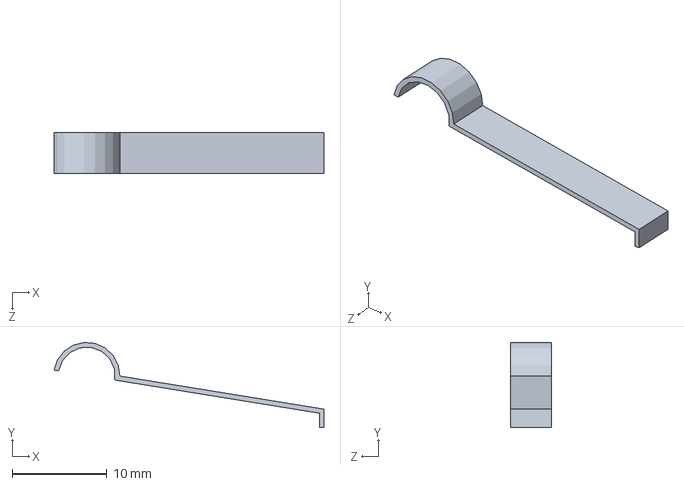
[picture p189: CAD file, 2021-05-10]
GLOBAL/D2RV_L13/D2RV_L13_ACTUATOR.SLDPRT
28.5 x 8.99 x 4.30 mm
