donaldsonlab/Operant-Cage/GLOBAL/Door/servoJig_pinionB.SLDPRT

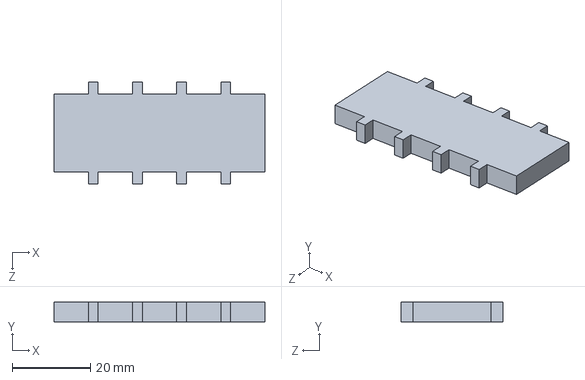
[picture p190: CAD file, 2021-05-10]
GLOBAL/Door/servoJig_pinionB.SLDPRT
54.0 x 5.00 x 26.0 mm
