donaldsonlab/Operant-Cage/GLOBAL/Lever/servoJig_leverA.SLDPRT

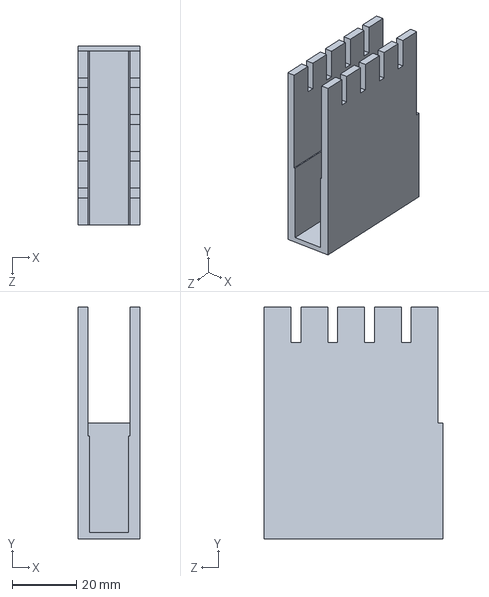
[picture p191: CAD file, 2021-05-10]
GLOBAL/Lever/servoJig_leverA.SLDPRT
19.1 x 72.0 x 55.5 mm
