donaldsonlab/Operant-Cage/GLOBAL/Motors/stepperMotor.SLDPRT

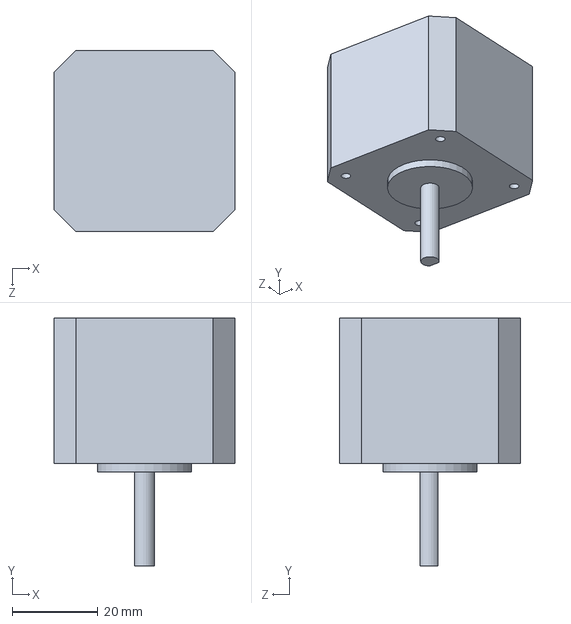
[picture p192: CAD file, 2021-05-10]
GLOBAL/Motors/stepperMotor.SLDPRT
42.3 x 58.0 x 42.3 mm
