donaldsonlab/Operant-Cage/Operant Cage Drawing Files Scoped Voles - 20241001/preferenceV2_Extend_Feet.STL

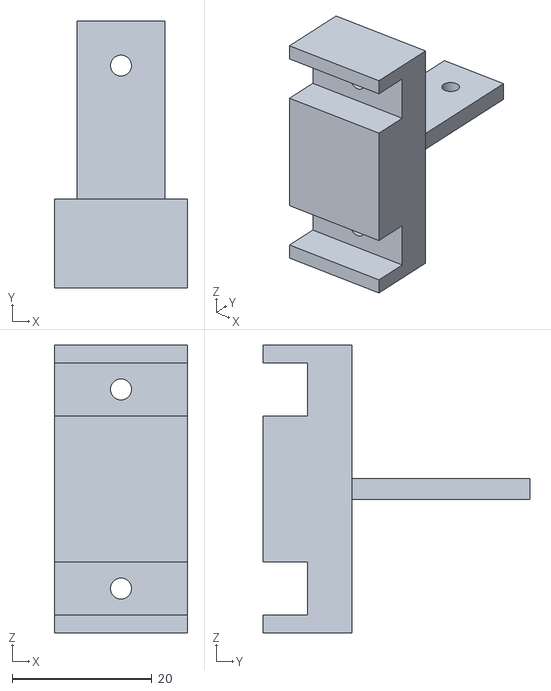
[picture p193: CAD file, 2024-09-05]
Operant Cage Drawing Files Scoped Voles - 20241001/preferenceV2_Extend_Feet.STL
19.1 x 38.1 x 41.1
