donaldsonlab/Operant-Cage/V3/Chamber/New interaction box/20240415_drawing_files/interaction_lid_v2.DXF

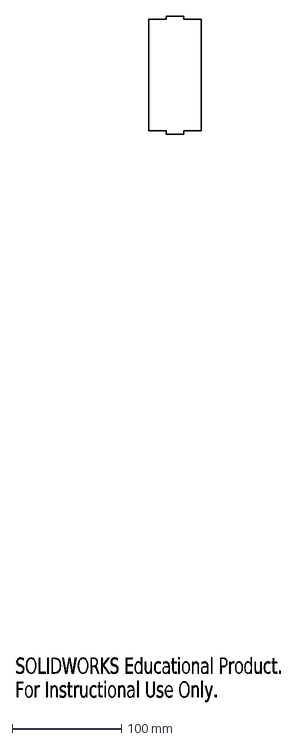
[picture p194: CAD file, 2024-11-19]
V3/Chamber/New interaction box/20240415_drawing_files/interaction_lid_v2.DXF
SOLIDWORKS Educational Product.
For Instructional Use Only.
