donaldsonlab/Operant-Cage/V3/Chamber/New interaction box/front_back.SLDPRT

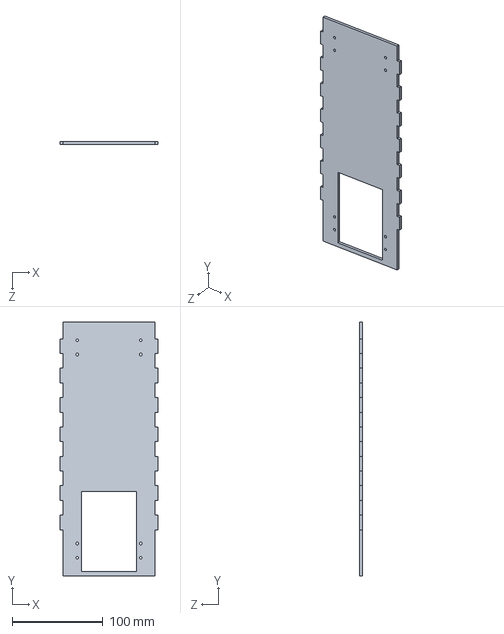
[picture p196: CAD file, 2024-11-19]
V3/Chamber/New interaction box/front_back.SLDPRT
107.9 x 279.4 x 3.17 mm
