donaldsonlab/Operant-Cage/V3/Chamber/preferenceV2_chamberBottom.SLDPRT

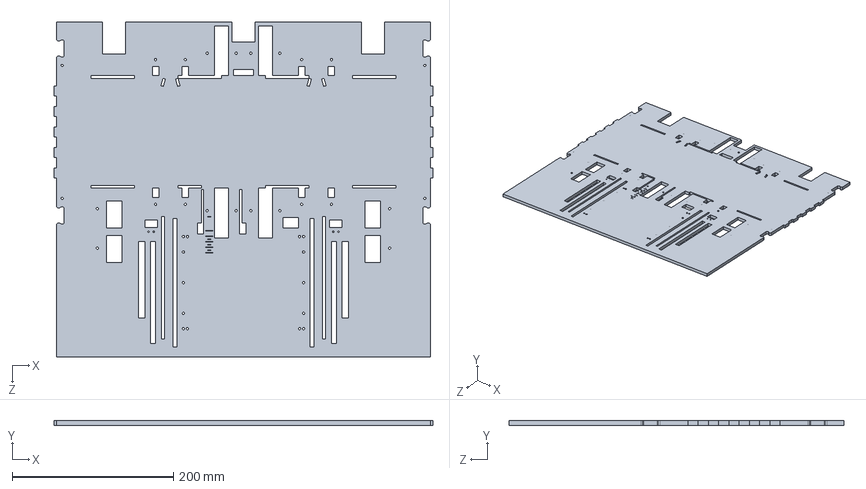
[picture p197: CAD file, 2023-07-26]
V3/Chamber/preferenceV2_chamberBottom.SLDPRT
470.6 x 5.59 x 415.9 mm
