donaldsonlab/Operant-Cage/V3/Chamber/printing/preferenceV2_back_inter.DXF

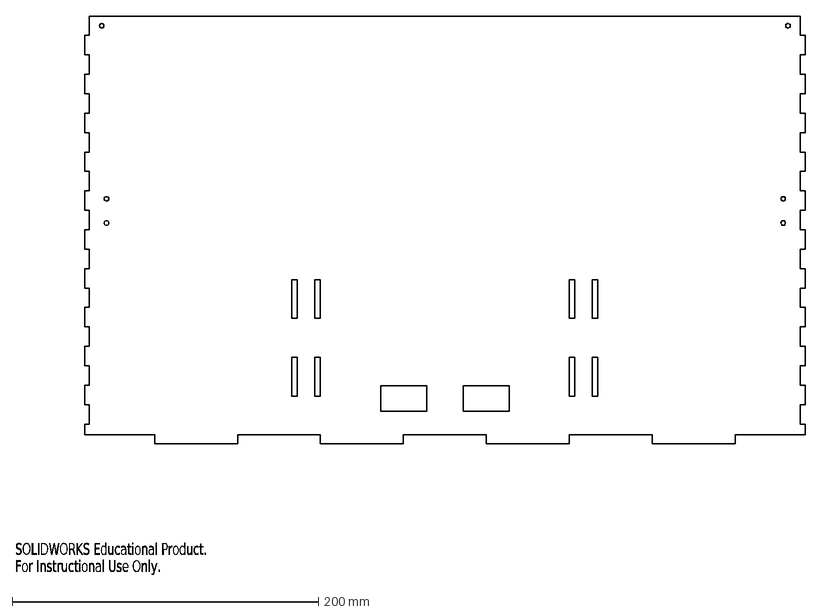
[picture p198: CAD file, 2023-05-15]
V3/Chamber/printing/preferenceV2_back_inter.DXF
SOLIDWORKS Educational Product.
For Instructional Use Only.
