donaldsonlab/Operant-Cage/V3/Dispenser/dispenser_wires.SLDPRT

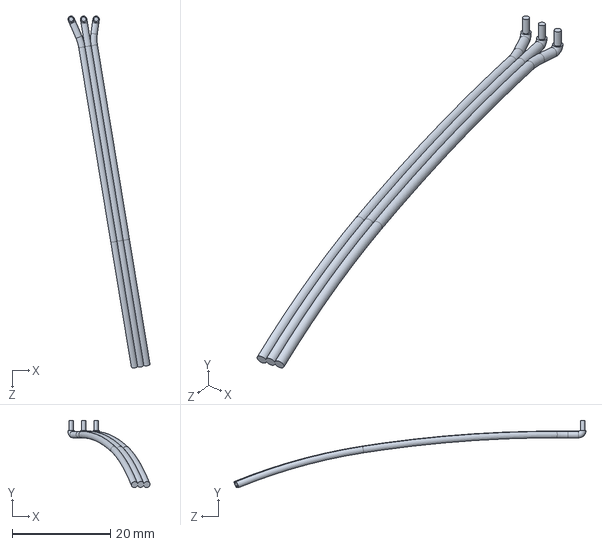
[picture p199: CAD file, 2023-07-26]
V3/Dispenser/dispenser_wires.SLDPRT
16.7 x 13.7 x 71.6 mm
