donaldsonlab/Operant-Cage/V3/Dispenser/printing/preferenceV2_dispenser_trough525.STL

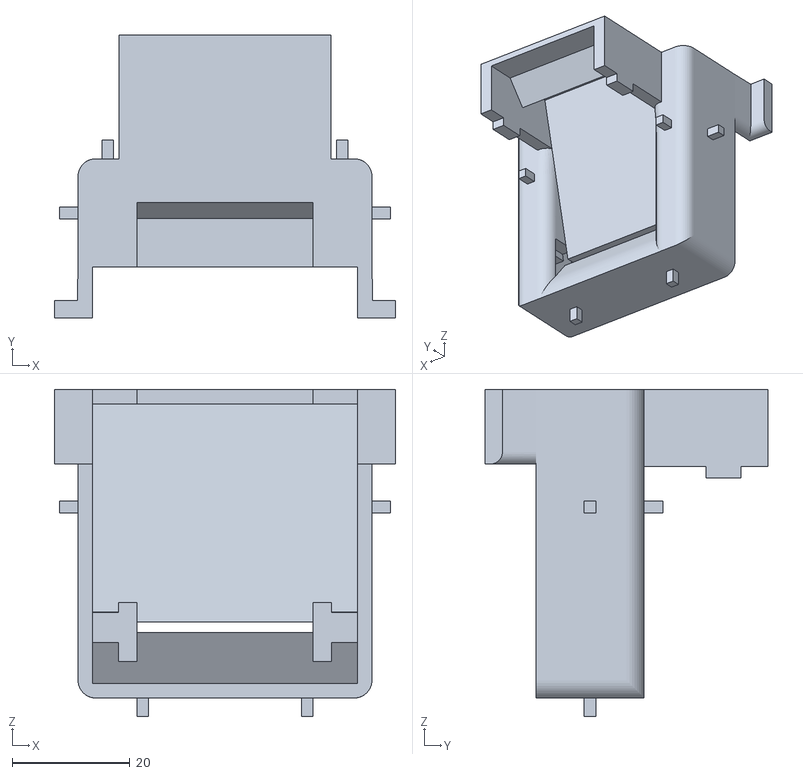
[picture p200: CAD file, 2023-02-03]
V3/Dispenser/printing/preferenceV2_dispenser_trough525.STL
58.0 x 48.2 x 55.7
