donaldsonlab/Operant-Cage/V3/DXF/preferenceV2_dispenser_troughShield_Front_72.DXF

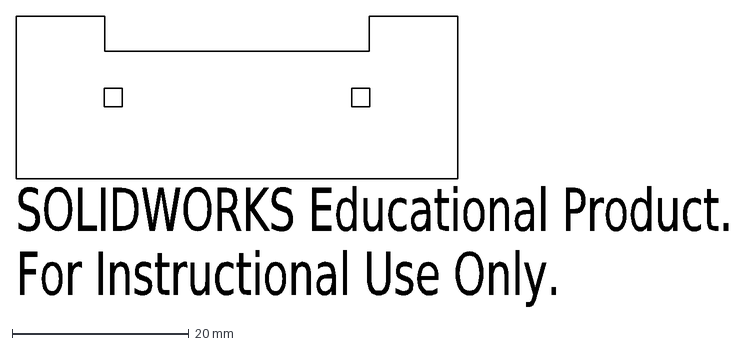
[picture p201: CAD file, 2022-07-01]
V3/DXF/preferenceV2_dispenser_troughShield_Front_72.DXF
SOLIDWORKS Educational Product.
For Instructional Use Only.
