donaldsonlab/Operant-Cage/V3/Lever/lvrV2_magnetMount.SLDPRT

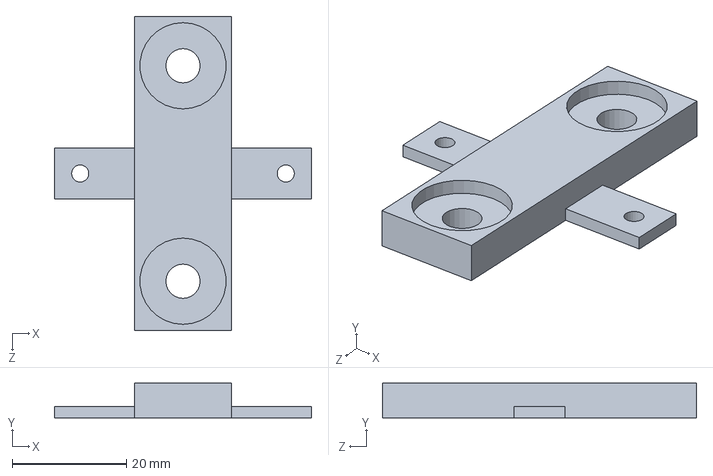
[picture p202: CAD file, 2023-07-26]
V3/Lever/lvrV2_magnetMount.SLDPRT
45.0 x 6.09 x 55.0 mm
