donaldsonlab/Operant-Cage/V3/Lever/nosepoke_CloserIRs/nosepoke.SLDPRT

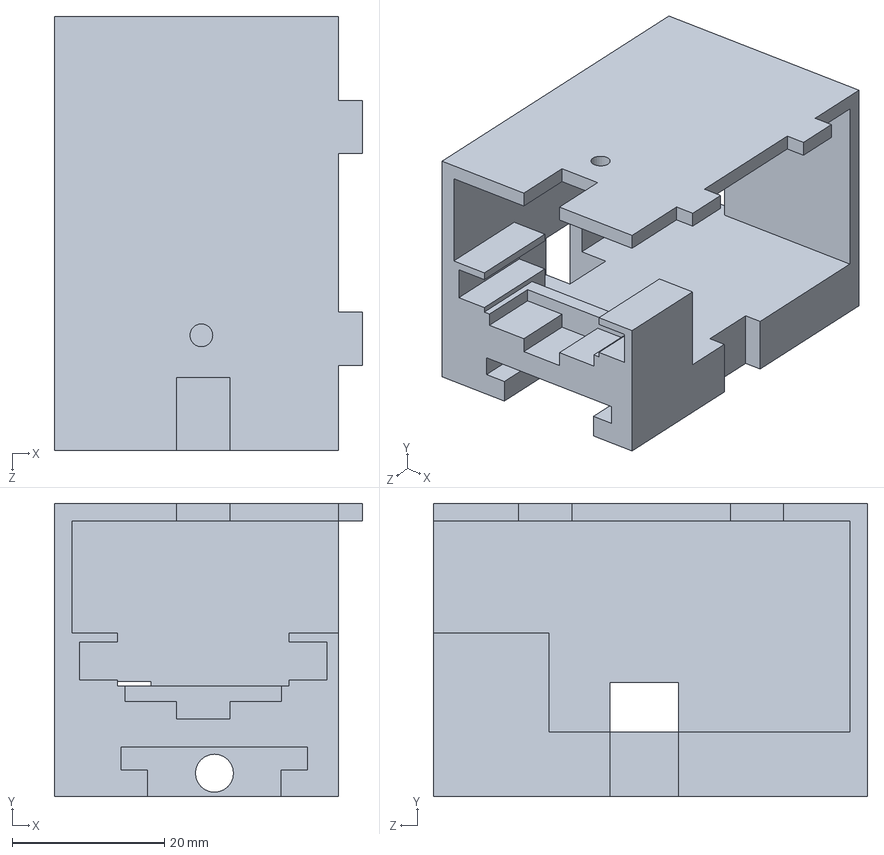
[picture p203: CAD file, 2024-11-25]
V3/Lever/nosepoke_CloserIRs/nosepoke.SLDPRT
40.5 x 38.5 x 57.0 mm
