donaldsonlab/Operant-Cage/V3/Lever/nosepoke_V3_extended - rotated IRs/extended_drawing_files/inner wall.DXF

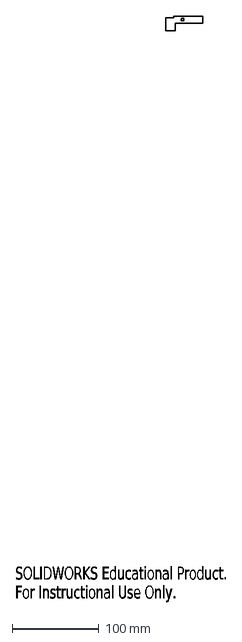
[picture p204: CAD file, 2024-11-25]
V3/Lever/nosepoke_V3_extended - rotated IRs/extended_drawing_files/inner wall.DXF
SOLIDWORKS Educational Product.
For Instructional Use Only.
