donaldsonlab/Operant-Cage/V3/Lever/nosepoke_V3_extended - rotated IRs/extended_drw_v4/outside guard extended back face.DXF

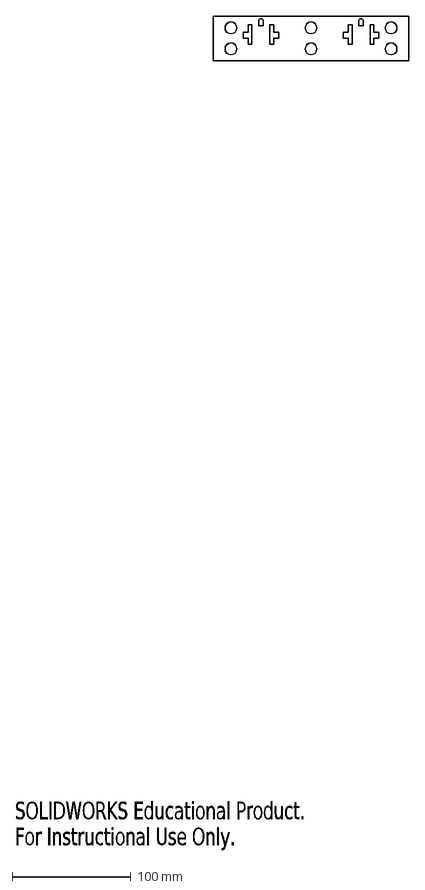
[picture p205: CAD file, 2024-09-05]
V3/Lever/nosepoke_V3_extended - rotated IRs/extended_drw_v4/outside guard extended back face.DXF
SOLIDWORKS Educational Product.
For Instructional Use Only.
