donaldsonlab/Operant-Cage/V3/Lever/nosepoke_V3_extended - rotated IRs/New folder/side_guard_B.DXF

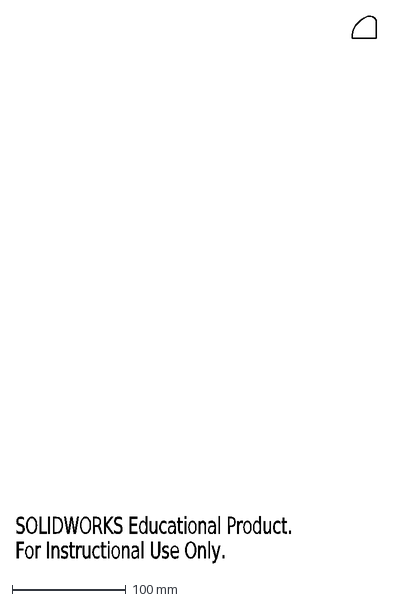
[picture p206: CAD file, 2024-11-25]
V3/Lever/nosepoke_V3_extended - rotated IRs/New folder/side_guard_B.DXF
SOLIDWORKS Educational Product.
For Instructional Use Only.
