donaldsonlab/Operant-Cage/V3/Lever/nosepoke_V3_extended - rotated IRs/nosepoke_cap.SLDPRT

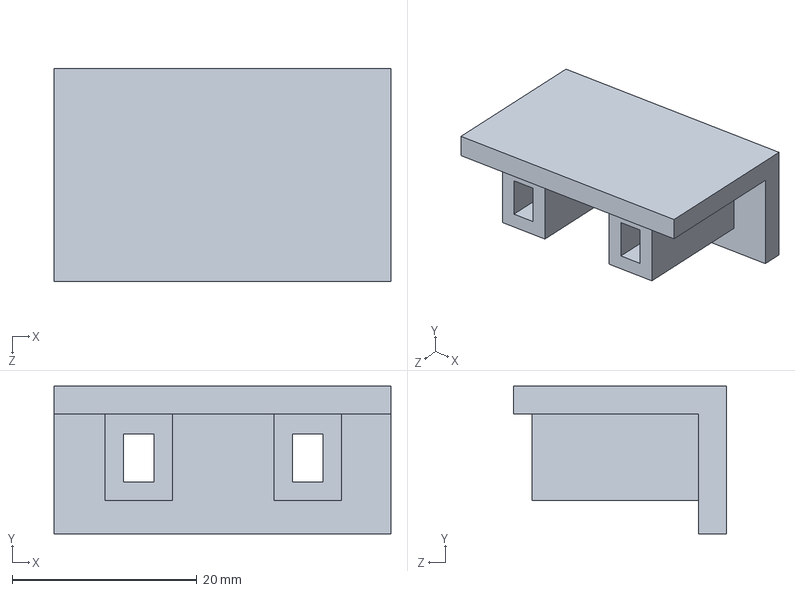
[picture p207: CAD file, 2024-11-25]
V3/Lever/nosepoke_V3_extended - rotated IRs/nosepoke_cap.SLDPRT
36.5 x 16.0 x 23.0 mm
