donaldsonlab/Operant-Cage/V3/Lever/nosepoke_V3_extended/inner floor.SLDPRT

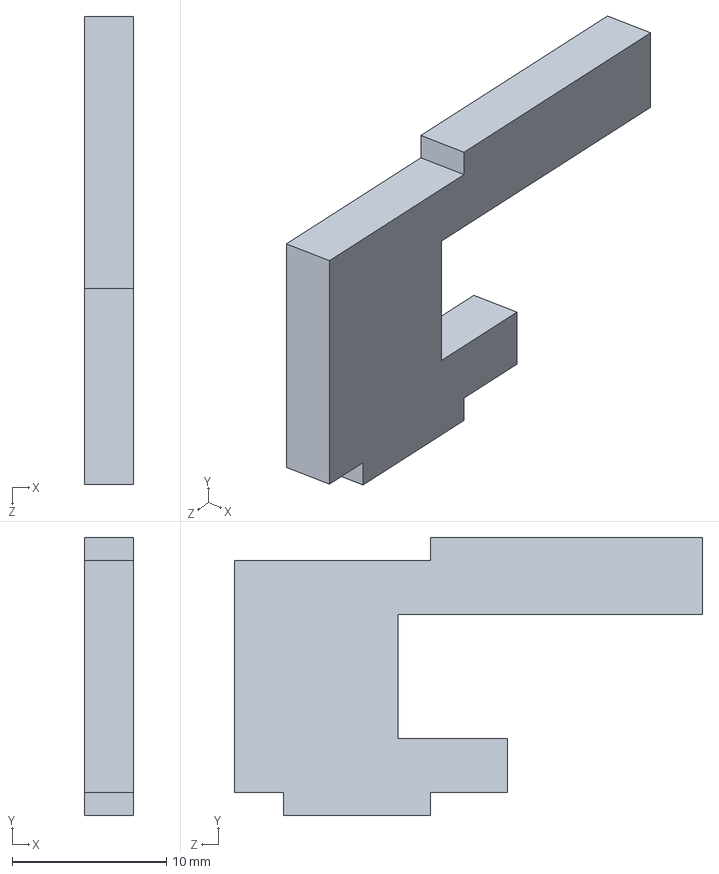
[picture p208: CAD file, 2024-11-25]
V3/Lever/nosepoke_V3_extended/inner floor.SLDPRT
3.17 x 18.0 x 30.3 mm
