donaldsonlab/Operant-Cage/V3/Sound_Box/side.SLDPRT

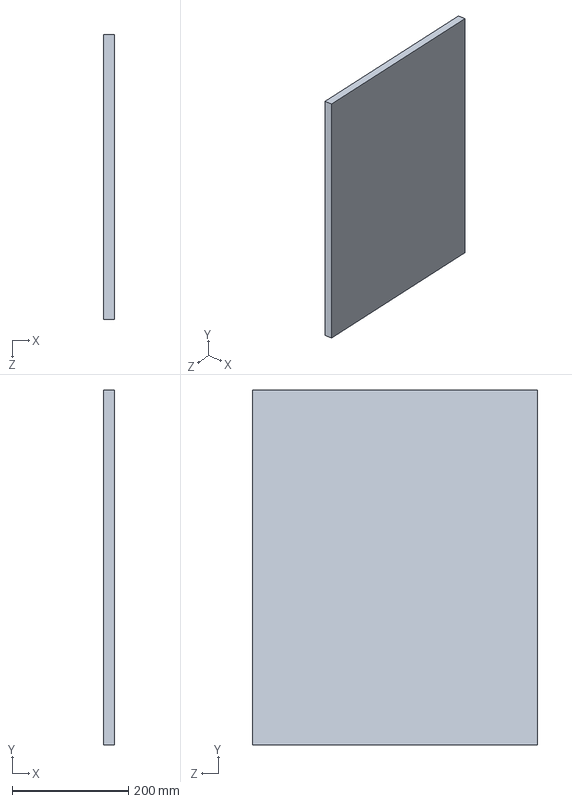
[picture p209: CAD file, 2021-07-21]
V3/Sound_Box/side.SLDPRT
19.1 x 609.6 x 489.0 mm
