donaldsonlab/Operant-Cage/V3/STL/preferenceV2_dispenser_trough_60.STL

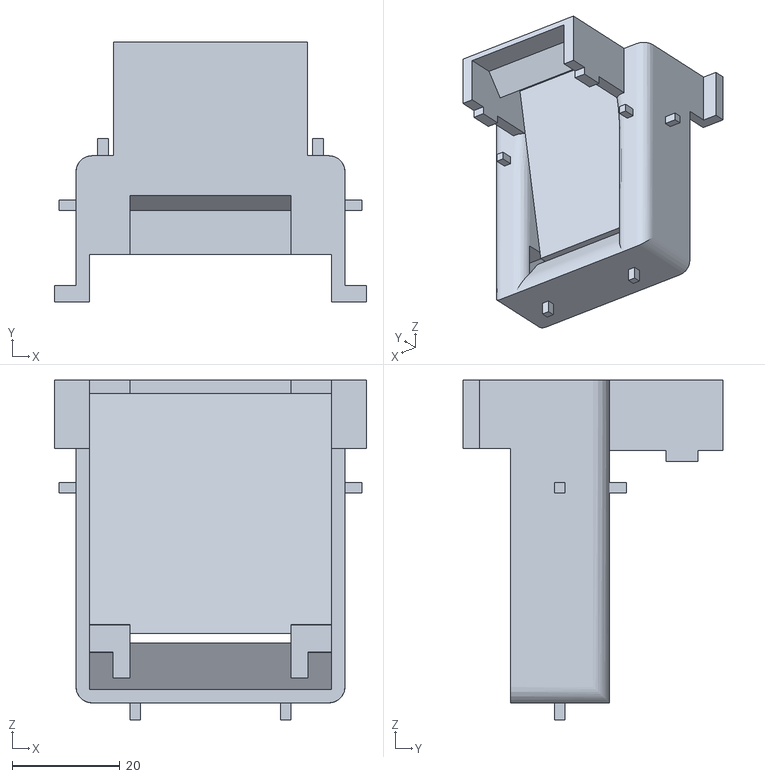
[picture p210: CAD file, 2022-07-01]
V3/STL/preferenceV2_dispenser_trough_60.STL
58.0 x 48.3 x 63.2
