donaldsonlab/Operant-Cage/GLOBAL/Door/servoJig_pinionA.SLDPRT

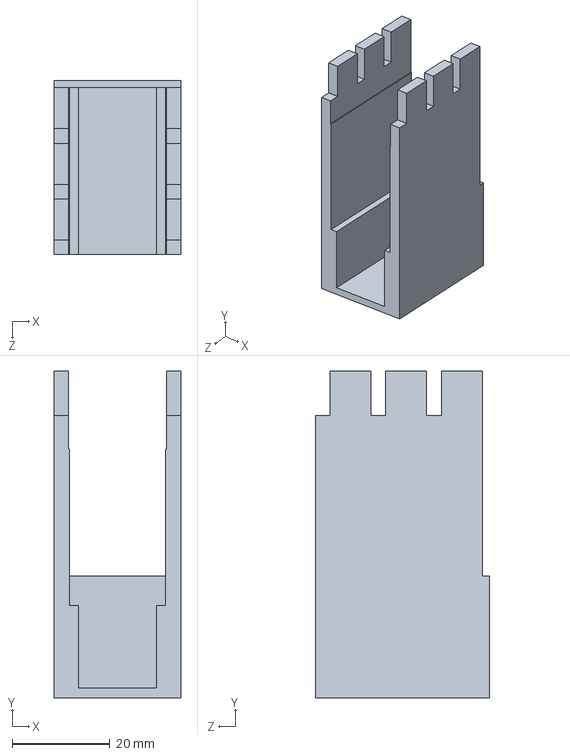
[picture p211: CAD file, 2021-05-10]
GLOBAL/Door/servoJig_pinionA.SLDPRT
26.0 x 67.0 x 35.7 mm
