donaldsonlab/Operant-Cage/GLOBAL/Lever/servoJig_leverB.SLDPRT

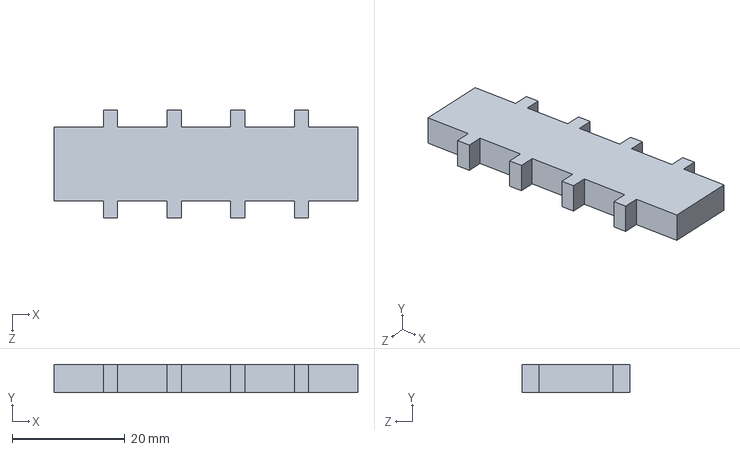
[picture p212: CAD file, 2021-05-10]
GLOBAL/Lever/servoJig_leverB.SLDPRT
54.0 x 5.00 x 19.1 mm
