donaldsonlab/Operant-Cage/GLOBAL/Motors/servoOutline.SLDPRT

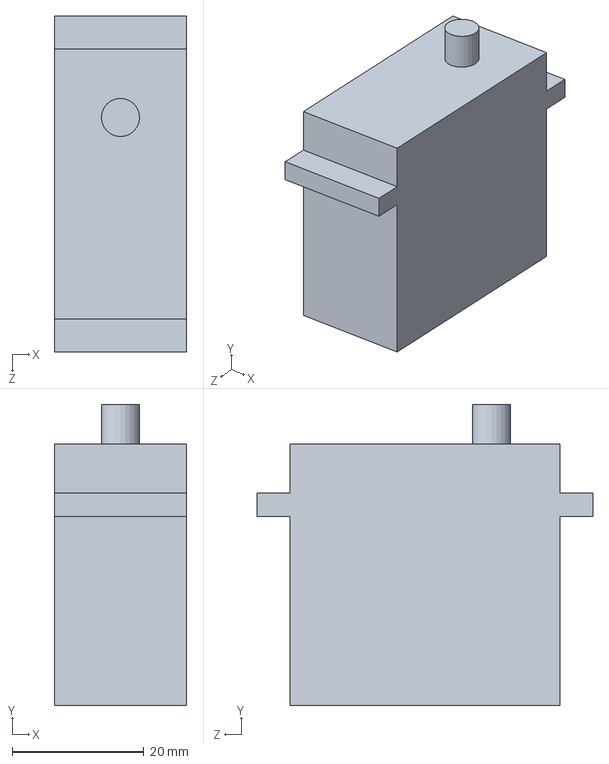
[picture p213: CAD file, 2021-05-10]
GLOBAL/Motors/servoOutline.SLDPRT
20.1 x 45.8 x 51.0 mm
