donaldsonlab/Operant-Cage/Operant Cage Drawing Files Scoped Voles - 20241001/preferenceV2_chamberBottom (Side).DXF

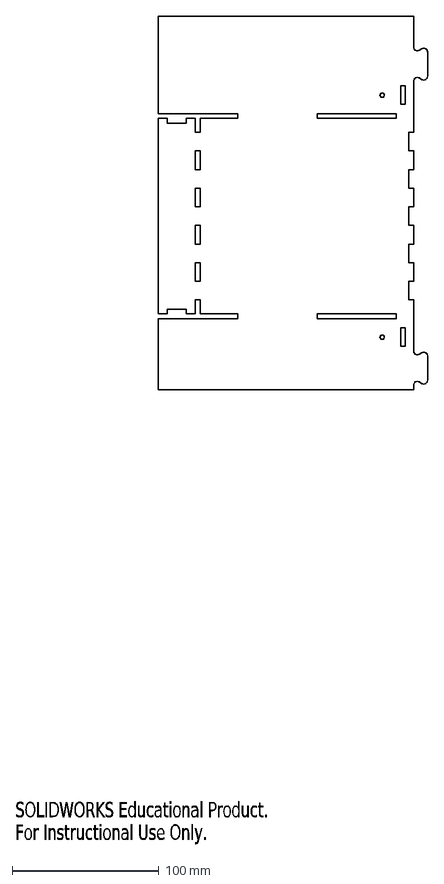
[picture p214: CAD file, 2024-09-05]
Operant Cage Drawing Files Scoped Voles - 20241001/preferenceV2_chamberBottom (Side).DXF
SOLIDWORKS Educational Product.
For Instructional Use Only.
