donaldsonlab/Operant-Cage/V3/Chamber/Food_dispenser_V2.SLDPRT

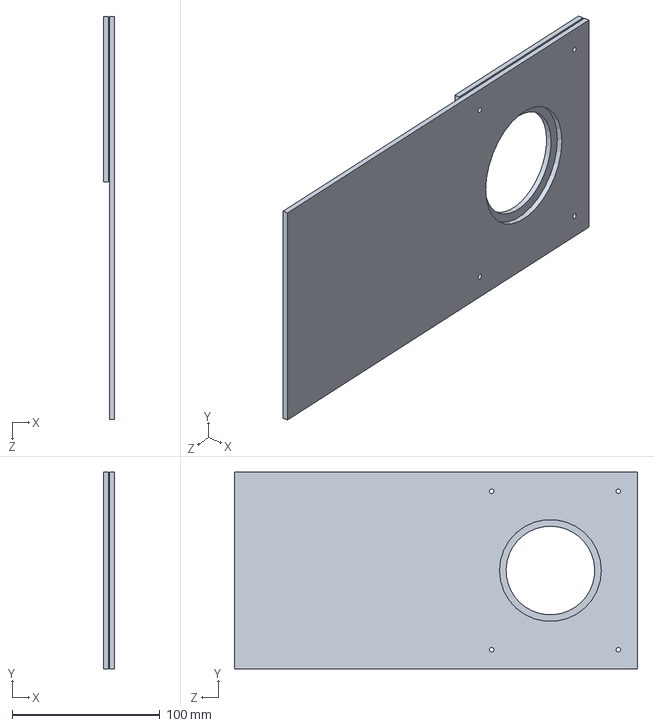
[picture p215: CAD file, 2023-07-11]
V3/Chamber/Food_dispenser_V2.SLDPRT
7.35 x 133.4 x 273.0 mm
