donaldsonlab/Operant-Cage/V3/Chamber/printing/mesh_divider_halfx8.DXF

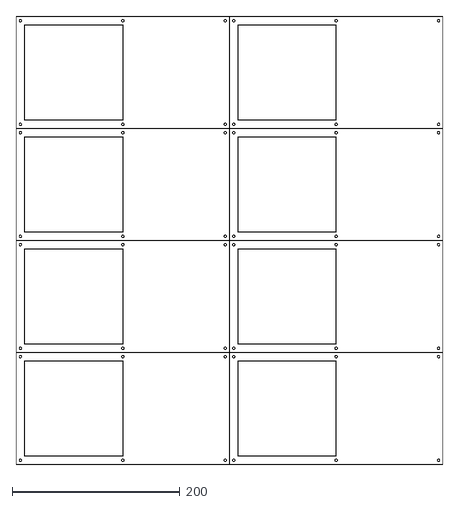
[picture p218: CAD file, 2023-05-15]
V3/Chamber/printing/mesh_divider_halfx8.DXF
508.4 x 533.8
