donaldsonlab/Operant-Cage/V3/Dispenser/printing/preferenceV2_dispenser_troughShield_Top525.DXF

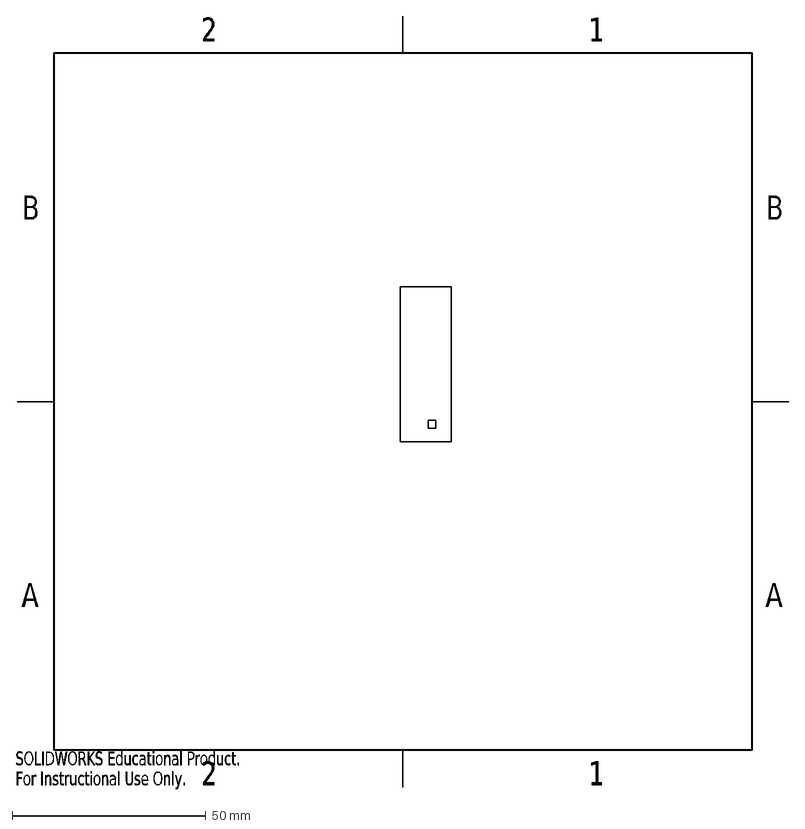
[picture p219: CAD file, 2023-02-03]
V3/Dispenser/printing/preferenceV2_dispenser_troughShield_Top525.DXF
A
B
2
1
SOLIDWORKS Educational Product.
For Instructional Use Only.
