donaldsonlab/Operant-Cage/V3/Dispenser/sparkfunIR_breakoutBoard.SLDPRT

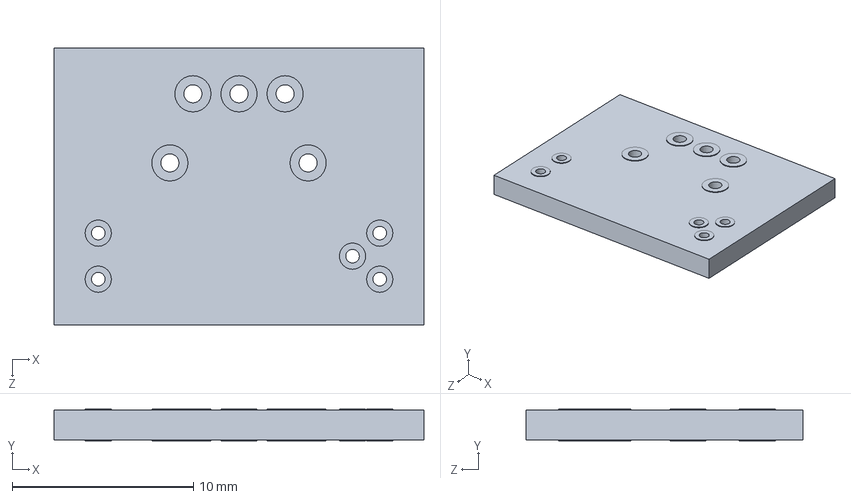
[picture p220: CAD file, 2023-07-26]
V3/Dispenser/sparkfunIR_breakoutBoard.SLDPRT
20.4 x 1.75 x 15.3 mm
