donaldsonlab/Operant-Cage/V3/DXF/preferenceV2_dispenser_troughShield_Top_72.DXF

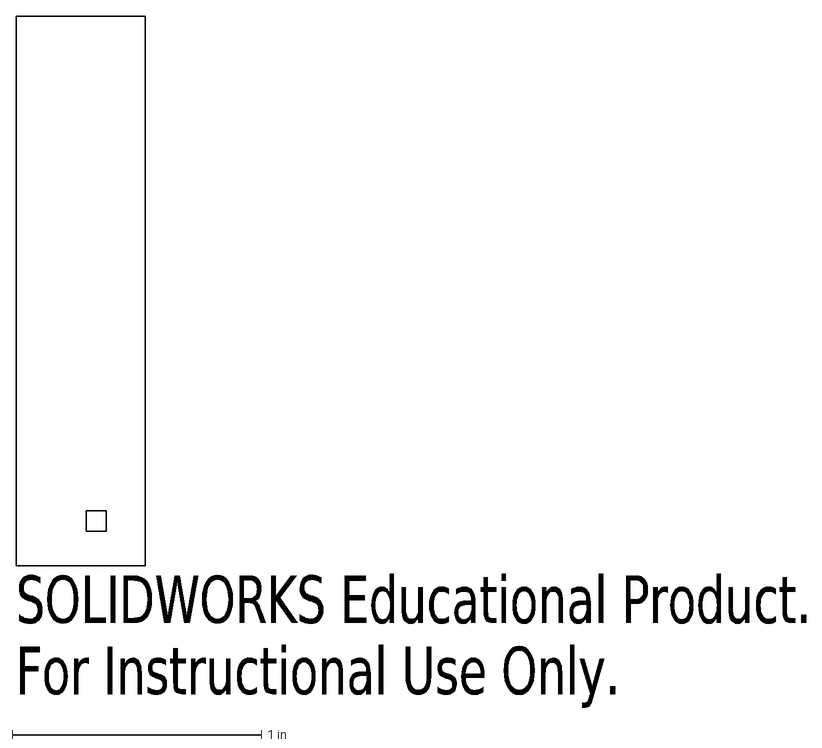
[picture p221: CAD file, 2022-07-01]
V3/DXF/preferenceV2_dispenser_troughShield_Top_72.DXF
SOLIDWORKS Educational Product.
For Instructional Use Only.
