donaldsonlab/Operant-Cage/V3/Lever/nosepoke_V3/nosepoke_magnet_mount.SLDPRT

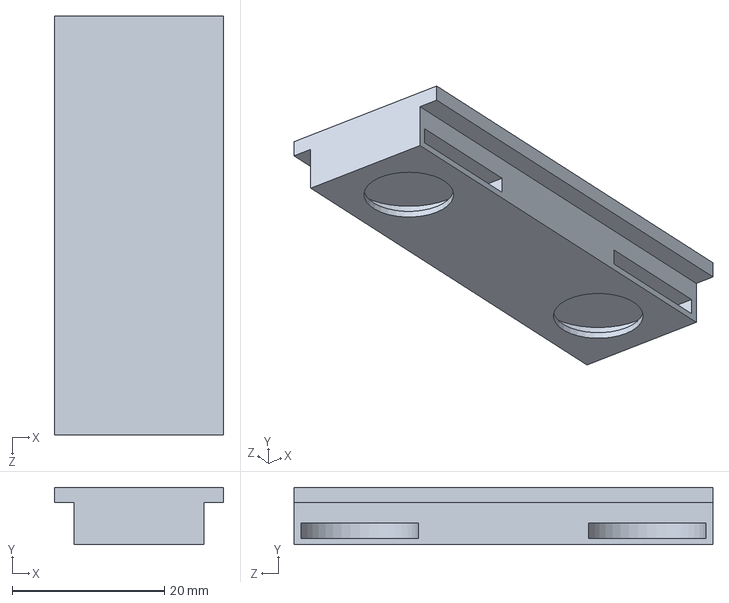
[picture p222: CAD file, 2024-12-18]
V3/Lever/nosepoke_V3/nosepoke_magnet_mount.SLDPRT
22.2 x 7.50 x 55.0 mm
