donaldsonlab/Operant-Cage/V3/Lever/nosepoke_V3_extended/tabs.SLDPRT

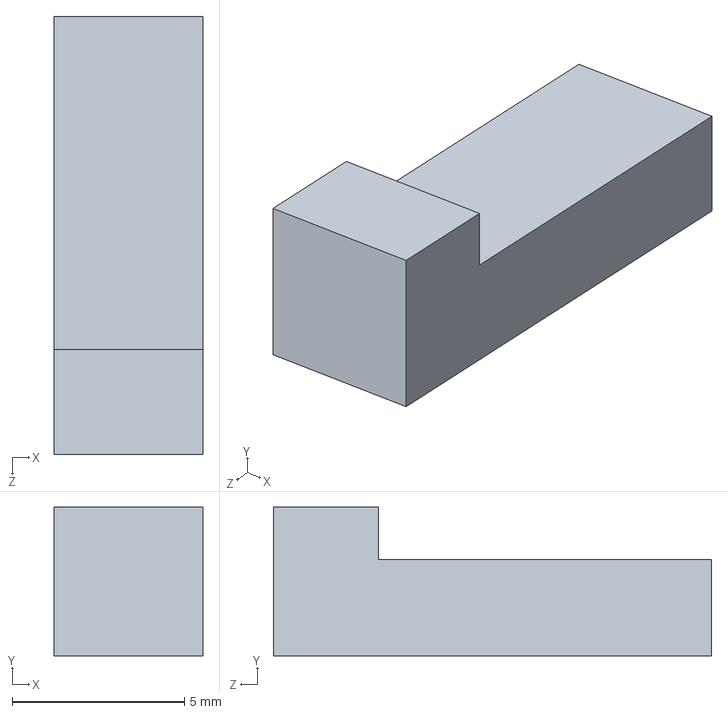
[picture p223: CAD file, 2024-11-25]
V3/Lever/nosepoke_V3_extended/tabs.SLDPRT
4.32 x 4.32 x 12.7 mm
