donaldsonlab/Operant-Cage/V3/Lever/printing/lvrV2_housing_22217_leftSide.STL

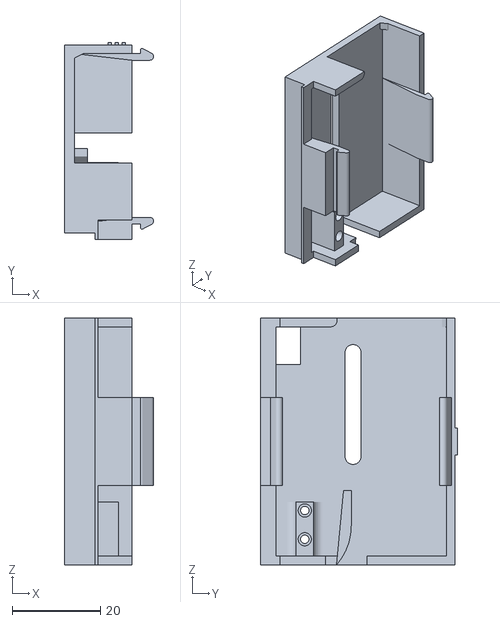
[picture p224: CAD file, 2022-11-23]
V3/Lever/printing/lvrV2_housing_22217_leftSide.STL
20.2 x 44.5 x 55.8
