donaldsonlab/Operant-Cage/V3/Sound_Box/box-hinge.SLDPRT

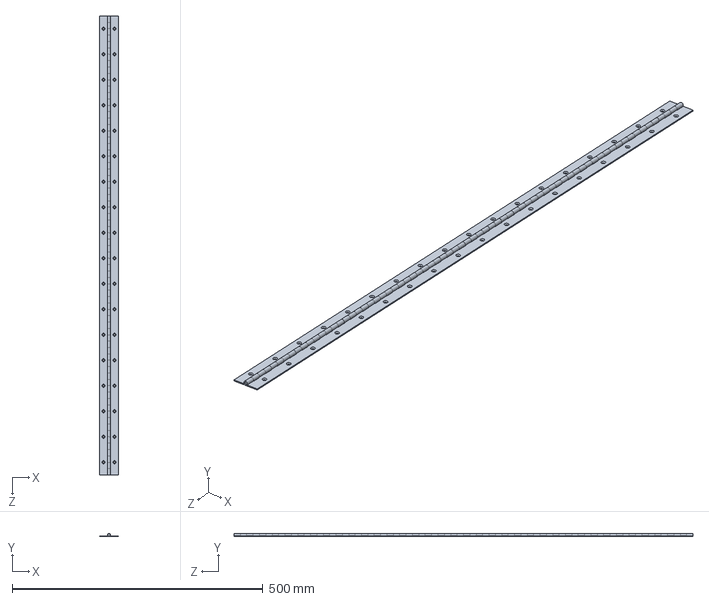
[picture p225: CAD file, 2021-06-29]
V3/Sound_Box/box-hinge.SLDPRT
38.1 x 6.22 x 914.4 mm
