donaldsonlab/Operant-Cage/V3/STL/preferenceV2_dispenser_trough_mountPlate_72.STL

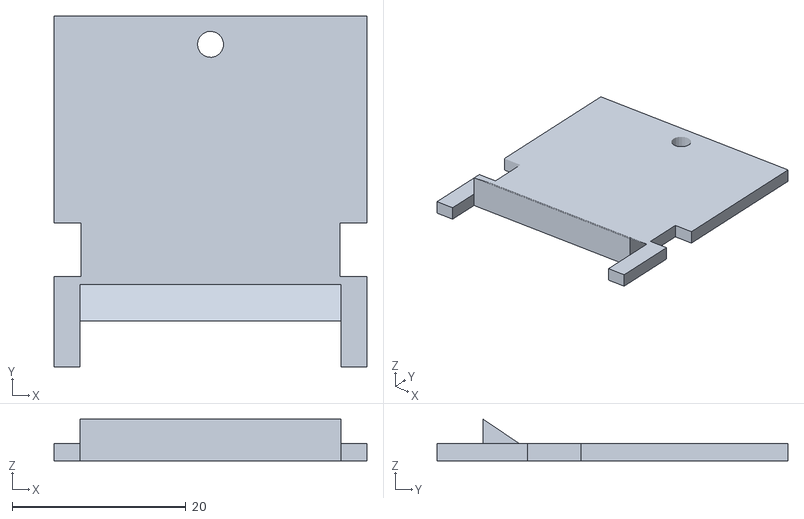
[picture p226: CAD file, 2022-07-01]
V3/STL/preferenceV2_dispenser_trough_mountPlate_72.STL
36.0 x 40.4 x 4.81
