donaldsonlab/Operant-Cage/(list of files, cad)

Other CAD files:
V3/Lever/nosepoke_CloserIRs/lvrV2_nosepoke.SLDASM
V3/Dispenser/preferenceV2_dispenser_IRAssembly.SLDASM
V3/Lever/nosepoke_V3_extended - rotated IRs/lvrV2_nosepoke.SLDASM
V3/Lever/nosepoke_V3_extended/lvrV2_nosepoke.SLDASM
V3/Dispenser/sparkfunIR_casing.SLDPRT
V3/Dispenser/printing/preferenceV2_dispenser_feedingDisk_6hole.STL
V3/Extra Feet/preferenceV3_Extend_Feet_Extra.SLDPRT
V3/Lever/nosepoke_V3_extended - rotated IRs/extended_drw_v4/outside guard extended.DXF
V3/Lever/nosepoke_V3_extended/extended_drw_v4/outside guard extended.DXF
V3/Door/pinion_211705_metal_insert.SLDPRT
V3/Extra Feet/Extra_Feet.STL
V3/Lever/printing/lvrV2_housing_22217_rightSide.STL
V3/Lever/servoOutline_micro.SLDPRT
GLOBAL/AH1_switchOutline.SLDPRT
GLOBAL/Door/servoMountSpacer.SLDPRT
GLOBAL/Lever/servoJig_leverSpacer.SLDPRT
GLOBAL/M3_nut.SLDPRT
GLOBAL/M3x12.SLDPRT
GLOBAL/M3x16.SLDPRT
GLOBAL/M3x20.SLDPRT
GLOBAL/Motors/servoOutline_mightyMicro.SLDPRT
Operant Cage Drawing Files Scoped Voles - 20241001/pinion_211705_2.STL
Operant Cage Drawing Files Scoped Voles - 20241001/preferenceV2_Extend_LBracket.STL
Operant Cage Drawing Files Scoped Voles - 20241001/preferenceV2_Extend_topBracket.STL
Operant Cage Drawing Files Scoped Voles - 20241001/preferenceV2_chamberFront (Extension Side).DXF
Operant Cage Drawing Files Scoped Voles - 20241001/preferenceV2_chamberSide.DXF
Operant Cage Drawing Files Scoped Voles - 20241001/preferenceV2_door_larger_gap.DXF
Operant Cage Drawing Files Scoped Voles - 20241001/surfaceMount_top.STL
V1/Chamber/D2RV_switchMount.SLDPRT
V1/Chamber/D2RV_switchMount_mirror.SLDPRT
V1/Chamber/cableCaseAssembly.SLDASM
V1/Chamber/cableCase_bottom.SLDPRT
V1/Chamber/cableCase_top.SLDPRT
V1/Chamber/preference_LBracket.SLDASM
V1/Chamber/preference_LBracket.SLDPRT
V1/Chamber/preference_buttonMount.SLDPRT
V1/Chamber/preference_buttonMount_V2.SLDPRT
V1/Chamber/preference_buttonMount_backing.SLDPRT
V1/Chamber/preference_chamberBack.SLDPRT
V1/Chamber/preference_chamberBottom.SLDPRT
V1/Chamber/preference_chamberBottom_201104.SLDPRT
V1/Chamber/preference_chamberFeet.SLDPRT
V1/Chamber/preference_chamberFront.SLDPRT
V1/Chamber/preference_chamberSide.SLDPRT
V1/Chamber/preference_cornerBracket.SLDPRT
V1/Chamber/preference_pcbMount.SLDPRT
V1/Chamber/preference_piHatSpacer.SLDPRT
V1/Chamber/preference_piMount.SLDPRT
V1/Chamber/preference_piMount2.SLDPRT
V1/Chamber/preference_tetherMount.SLDPRT
V1/Dispenser/dispenserAssembly1.SLDASM
V1/Dispenser/dispenser_feedingDisk.SLDPRT
V1/Dispenser/dispenser_funnel.SLDPRT
V1/Dispenser/dispenser_servoMount.SLDPRT
V1/Dispenser/dispenser_trough.SLDPRT
V1/Dispenser/dispenser_troughIRShield.SLDPRT
V1/Dispenser/dispenser_troughShield_Front.SLDPRT
V1/Dispenser/dispenser_troughShield_Top.SLDPRT
V1/Dispenser/dispenser_troughShield_side.SLDPRT
V1/Dispenser/preference_troughCoverAssembly.SLDASM
V1/Dispenser/preference_troughCover_front.SLDPRT
V1/Dispenser/preference_troughCover_side.SLDPRT
V1/Dispenser/preference_troughCover_top.SLDPRT
V1/Door/door_rack_test.SLDPRT
V1/Door/preference_DoorGuidePin.SLDPRT
V1/Door/preference_door.SLDPRT
V1/Door/preference_doorAssembly.SLDASM
V1/Door/preference_doorGuide.SLDPRT
V1/Door/preference_doorGuideFlange.SLDPRT
V1/Door/preference_doorGuideMount.SLDPRT
V1/Door/preference_doorGuideMount_thin.SLDPRT
V1/Door/preference_doorGuideSupport.SLDPRT
V1/Door/preference_doorGuideTop.SLDPRT
V1/Door/preference_doorGuide_printed.SLDPRT
V1/Door/preference_doorPanel.SLDPRT
V1/Door/preference_doorServoAssembly.SLDASM
V1/Door/preference_doorServoMount.SLDPRT
V1/Door/preference_doorServoMountSpacer.SLDPRT
V1/Door/preference_doorStopper.SLDPRT
V1/Door/preference_doorSwitchPress.SLDPRT
V1/Door/preference_panelSwitchPress.SLDPRT
V1/Extension/DXF/preference_Extend_bottom.DXF
V1/Extension/DXF/preference_Extend_side.DXF
V1/Extension/STL/preference_Extend_Feet.STL
V1/Extension/STL/preference_Extend_LBracket.STL
V1/Extension/STL/preference_Extend_bracket.STL
V1/Extension/STL/preference_Extend_cornerBracket.STL
V1/Extension/STL/preference_Extend_topBracket.STL
V1/Extension/STL/preference_topExtensions.STL
V1/Extension/preference_Extend_Feet.SLDPRT
V1/Extension/preference_Extend_LBracket.SLDPRT
V1/Extension/preference_Extend_bottom.SLDPRT
V1/Extension/preference_Extend_bracket.SLDPRT
V1/Extension/preference_Extend_cornerBracket.SLDPRT
V1/Extension/preference_Extend_feetHoleJig.SLDPRT
V1/Extension/preference_Extend_side.SLDPRT
V1/Extension/preference_Extend_sideAssembly.SLDASM
V1/Extension/preference_Extend_sideAssembly2.SLDASM
V1/Extension/preference_Extend_topBracket.SLDPRT
V1/Extension/preference_topExtensionBracket.SLDPRT
V1/Extension/preference_topExtensions.SLDPRT
V1/Lever/preference_ledMountHorizontal.SLDPRT
V1/STL/20mg feeding disk.STL
V1/STL/LBracket.STL
V1/STL/cableCase_bottom.STL
V1/STL/cableCase_top.STL
V1/STL/cornerBracket.STL
V1/STL/doorStopper.STL
V1/STL/door_rail_floorMount.STL
V1/STL/funnel.STL
V1/STL/funnelMotorMount_BigServo.STL
V1/STL/leverHousing_Mirrored.STL
V1/STL/leverHousing_V4.STL
V1/STL/leverPress.STL
V1/STL/lvr_Housing_20202508.STL
V1/STL/lvr_bottomSpacer_15mm.STL
V1/STL/lvr_bottomSpacer_1mm.STL
V1/STL/lvr_bottomSpacer_75mm.STL
V1/STL/panelDoorSpacer.STL
V1/STL/panelSpacer.STL
V1/STL/piHolder.STL
V1/STL/pinion_201007_2.STL
V1/STL/preference_DoorGuidePin.STL
V1/STL/preference_Extend_feetHoleJig.STL
V1/STL/preference_LBracket.STL
V1/STL/preference_PanelSpacer.STL
V1/STL/preference_buttonMount.STL
V1/STL/preference_buttonMount_V2.STL
V1/STL/preference_buttonMount_backing.STL
V1/STL/preference_chamberFeet.STL
V1/STL/preference_cornerBracket.STL
V1/STL/preference_doorGuide.STL
V1/STL/preference_doorGuideMount.STL
V1/STL/preference_doorGuideMount_thin.STL
V1/STL/preference_doorGuideTop.STL
V1/STL/preference_doorGuide_printed.STL
V1/STL/preference_doorServoMountSpacer.STL
V1/STL/preference_doorStopper.STL
V1/STL/preference_doorSwitchPress.STL
V1/STL/preference_irMount.STL
V1/STL/preference_pcbMount.STL
V1/STL/preference_piHatSpacer.STL
V1/STL/preference_piMount2.STL
V1/STL/preference_tetherMount.STL
V1/STL/riserCenter.STL
V1/STL/riserEdge.STL
V1/STL/servoHornAdapter_V4.STL
V1/STL/servoJig_leverA.STL
V1/STL/servoJig_leverB.STL
V1/STL/servoJig_pinionA.STL
V1/STL/servoJig_pinionB.STL
V1/STL/servoMountSpacer2.STL
V1/STL/switchMount.STL
V1/STL/switchMount_mirror.STL
V1/STL/trough_v1.STL
V1/STL/trough_v2.STL
V1/STL/trough_v2_med.STL
V1/STL/trough_v2_small.STL
V1/STL/trough_v3.STL
V1/STL/trough_v3_noShield.STL
V1/STL/trough_v3_xs.STL
V1/STL/trough_v4.STL
V1/preference_TotalAssembly.SLDASM
V1/preference_TotalAssembly_Extended.SLDASM
V2/Chamber/Dividers/mesh_divider.SLDPRT
V2/Chamber/Dividers/mesh_divider_assem.SLDASM
V2/Chamber/Interaction_Box/Interaction_Box.SLDASM
V2/Chamber/divider_bars.SLDPRT
V2/Chamber/divider_clip.SLDPRT
V2/Chamber/food_cover.SLDDRW
V2/Chamber/food_cover.SLDPRT
V2/Chamber/food_cover_assem.SLDASM
V2/Chamber/food_cover_mount.SLDPRT
V2/Chamber/middle_riser.SLDPRT
V2/Chamber/preferenceV2_chamberBottom.SLDPRT
V2/Chamber/preferenceV2_chamberFront.SLDPRT
V2/Chamber/printing/food_cover.DXF
V2/Chamber/printing/food_cover_mount.STL
V2/Chamber/printing/middle_riser.STL
V2/Chamber/printing/middle_riser_side.STL
V2/Chamber/printing/wall_bracket_half.STL
V2/Chamber/wall_bracket.SLDPRT
V2/Dispenser/preferenceV2_dispenserAssembly.SLDASM
V2/Dispenser/preferenceV2_dispenser_funnel.SLDPRT
V2/Dispenser/preferenceV2_dispenser_troughShield_Front.SLDPRT
V2/Dispenser/preferenceV2_dispenser_troughShield_Side.SLDPRT
V2/Dispenser/preferenceV2_dispenser_troughShield_Top.SLDPRT
V2/Door/2TiltCageV2_doorPanel.SLDPRT
V2/Door/Drawings/2TiltCageV2_doorPanel.SLDDRW
V2/Door/Drawings/pinion_211705_2.SLDDRW
V2/Door/Drawings/preferenceV2_door.SLDDRW
V2/Door/Drawings/preferenceV2_doorServoMount.SLDDRW
V2/Door/cutting/2TiltCageV2_doorPanel.DXF
V2/Door/door_rail_SurfaceMount.SLDPRT
V2/Door/pinion_211705_2.SLDPRT
V2/Door/preferenceV2_door.SLDPRT
V2/Door/preferenceV2_doorServoMount.SLDPRT
V2/Door/preferenceV2_door_Assembly.SLDASM
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
