donaldsonlab/Operant-Cage/V3/Documentation/Images/Dispenser/assembly_step1_2.png

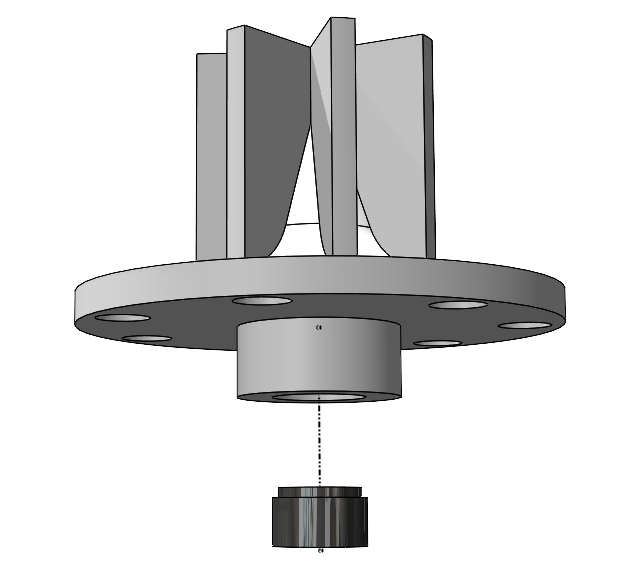
V3/Documentation/Images/Dispenser/assembly_step1_2.png
