donaldsonlab/Operant-Cage/V3/Documentation/Images/Dispenser/assembly_step1_3.png

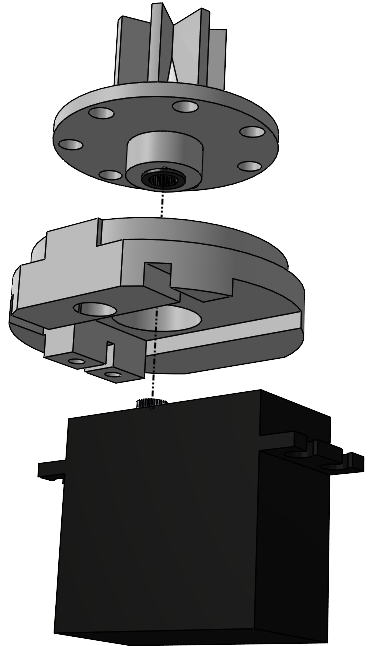
V3/Documentation/Images/Dispenser/assembly_step1_3.png
