donaldsonlab/Operant-Cage/V3/Documentation/Images/Dispenser/assemblyWireframe_step3_1_2.png

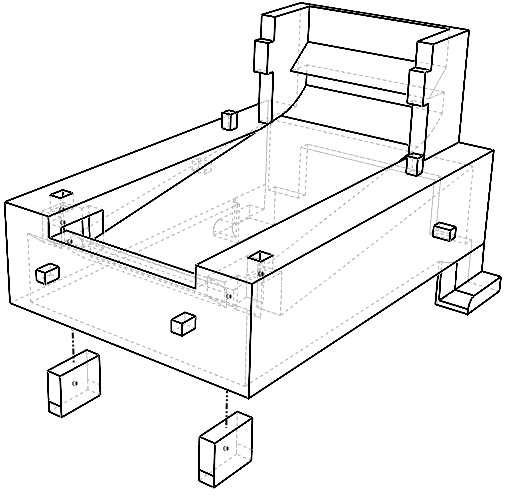
V3/Documentation/Images/Dispenser/assemblyWireframe_step3_1_2.png
