donaldsonlab/Operant-Cage/V3/Documentation/Images/Dispenser/assemblyWireframe_step3_.png

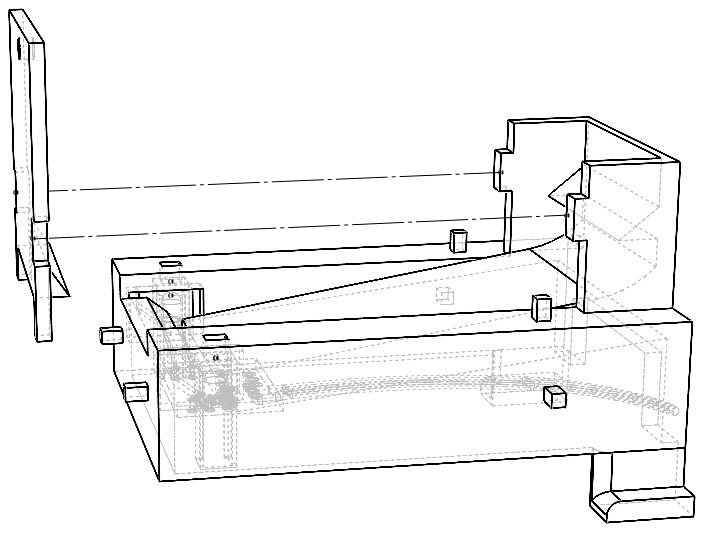
V3/Documentation/Images/Dispenser/assemblyWireframe_step3_.png
