donaldsonlab/Operant-Cage/V3/Documentation/Images/Dispenser/assemblyWireframe_step4_1.png

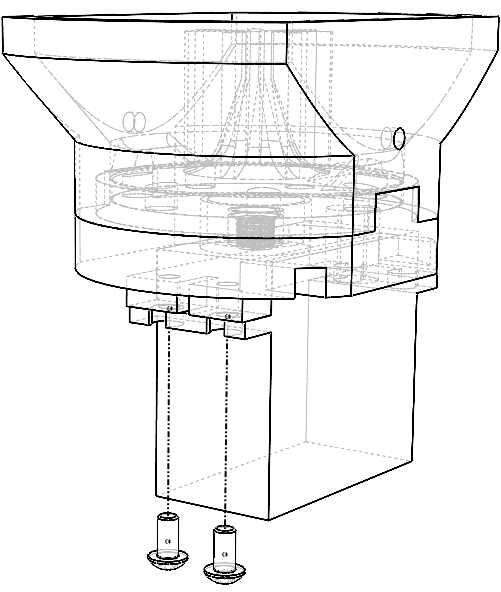
V3/Documentation/Images/Dispenser/assemblyWireframe_step4_1.png
