donaldsonlab/Operant-Cage/V3/Documentation/Images/Dispenser/dispenser_hopperAssembly.JPG

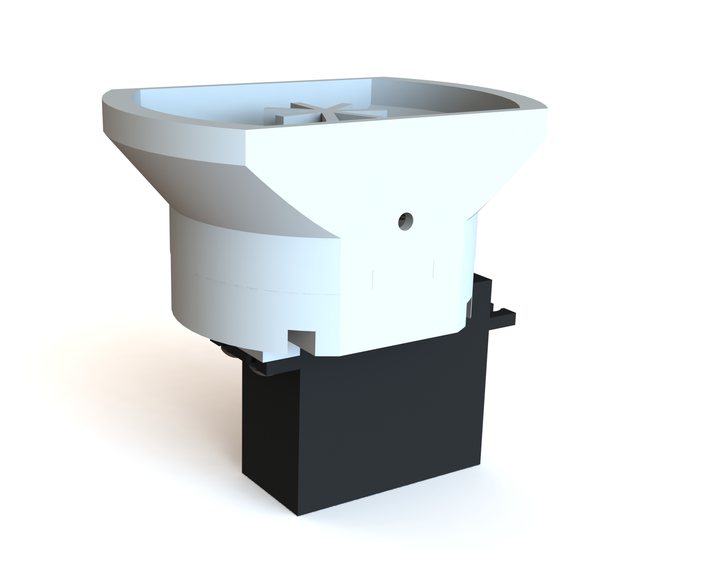
V3/Documentation/Images/Dispenser/dispenser_hopperAssembly.JPG
