donaldsonlab/Operant-Cage/V3/Documentation/Images/Dispenser/dispenser_irAssembly.JPG

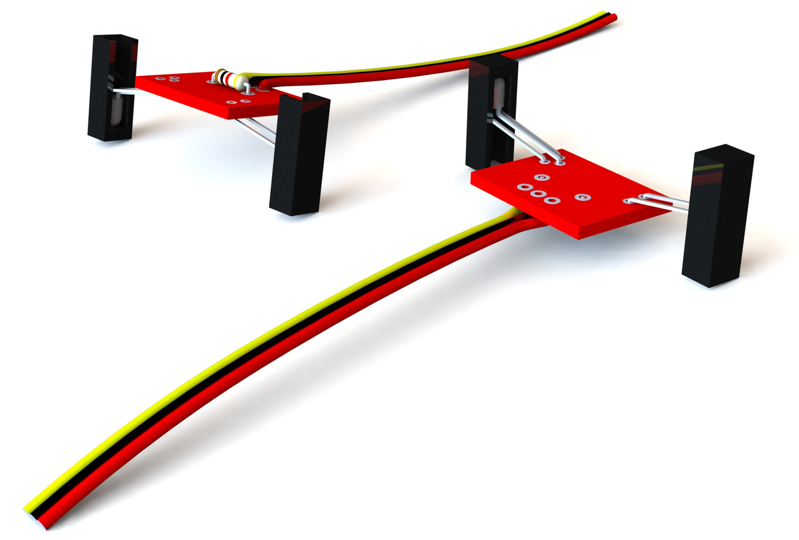
V3/Documentation/Images/Dispenser/dispenser_irAssembly.JPG
