donaldsonlab/Operant-Cage/V3/Documentation/Images/Dispenser/dispenser_troughAssembly.JPG

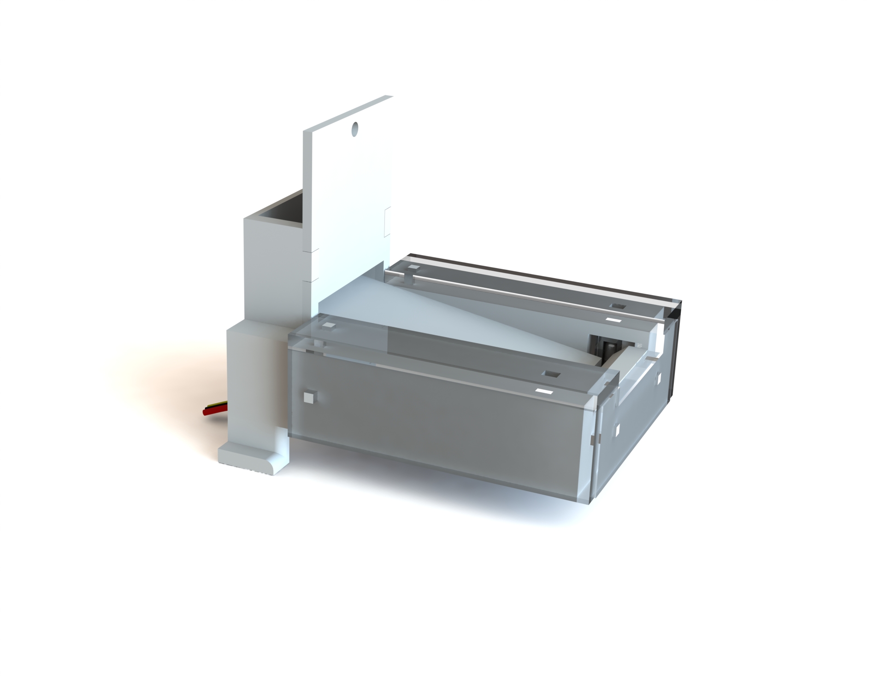
V3/Documentation/Images/Dispenser/dispenser_troughAssembly.JPG
