donaldsonlab/Operant-Cage/V3/Documentation/Images/Lever/housingAssembly2.png

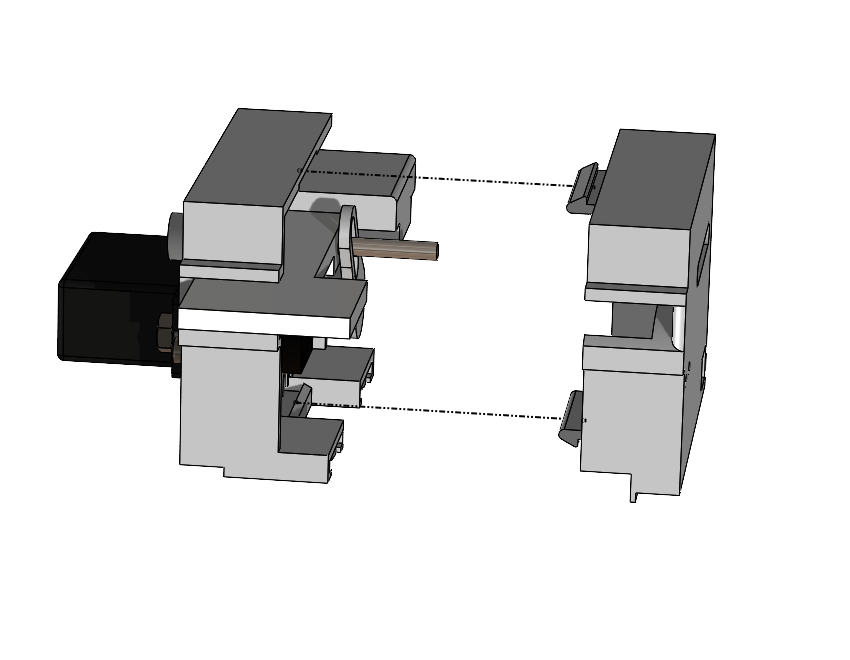
V3/Documentation/Images/Lever/housingAssembly2.png
