donaldsonlab/Operant-Cage/V3/Documentation/Images/Lever/mountServoAssembly.jpg

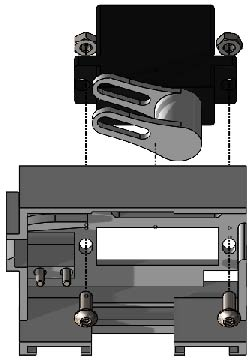
V3/Documentation/Images/Lever/mountServoAssembly.jpg
