donaldsonlab/Operant-Cage/V3/Documentation/Images/Lever/mountServoAssembly.png

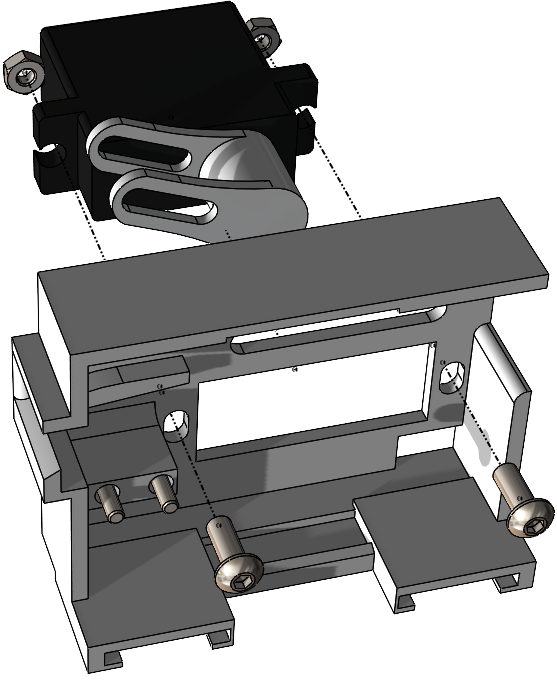
V3/Documentation/Images/Lever/mountServoAssembly.png
