donaldsonlab/Operant-Cage/V3/Drawings/Dispenser/preferenceV2_dispenser_irAssembly.pdf

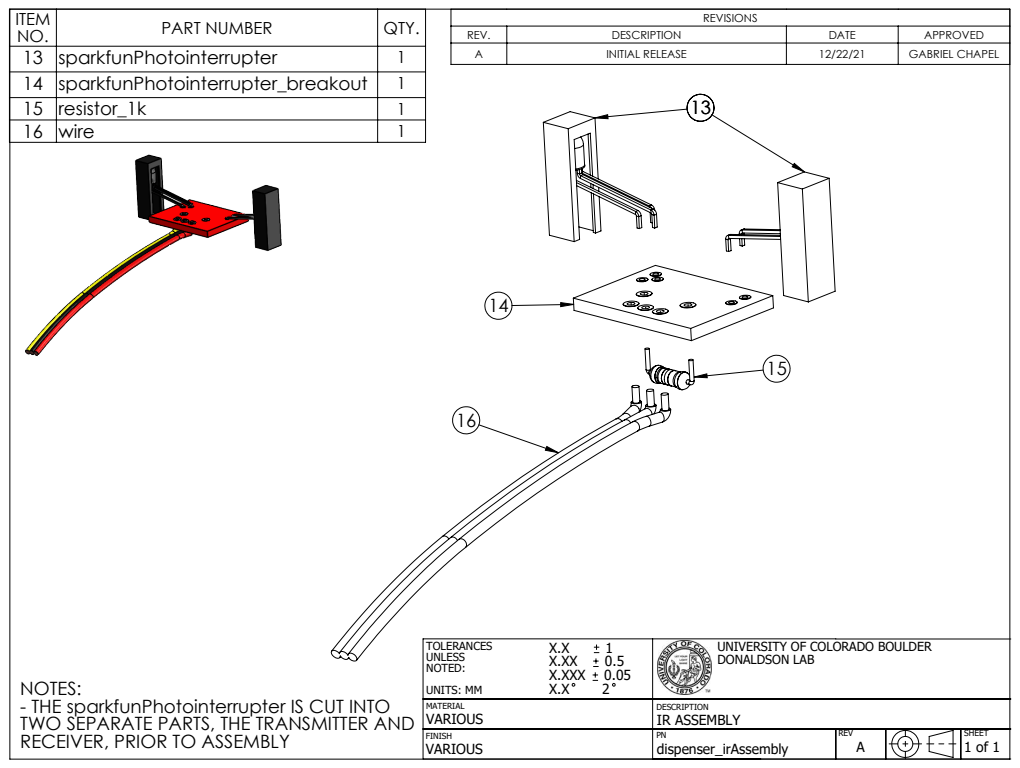
[picture p242: page 1]

ITEM NO. | PART NUMBER | QTY. | | REVISIONS
13 | sparkfunPhotointerrupter | 1
14 | sparkfunPhotointerrupter_breakout | 1
15 | resistor_1k | 1
16 | wire | 1

REV. | DESCRIPTION | DATE | APPROVED
A | INITIAL RELEASE | 12/22/21 | GABRIEL CHAPEL

TOLERANCES X.X 1 UNLESS X.XX 0.5 NOTED: X.XXX 0.05 X.X 2 UNITS: MM | UNIVERSITY OF COLORADO BOULDER DONALDSON LAB

NOTES:
- THE sparkfunPhotointerrupter IS CUT INTO
TWO SEPARATE PARTS, THE TRANSMITTER AND
RECEIVER, PRIOR TO ASSEMBLY

MATERIAL VARIOUS | DESCRIPTION IR ASSEMBLY

FINISH VARIOUS | PN dispenser_irAssembly | REV A | SHEET 1 of 1
