donaldsonlab/Operant-Cage/V3/Drawings/Dispenser/preferenceV2_dispenserAssembly.pdf

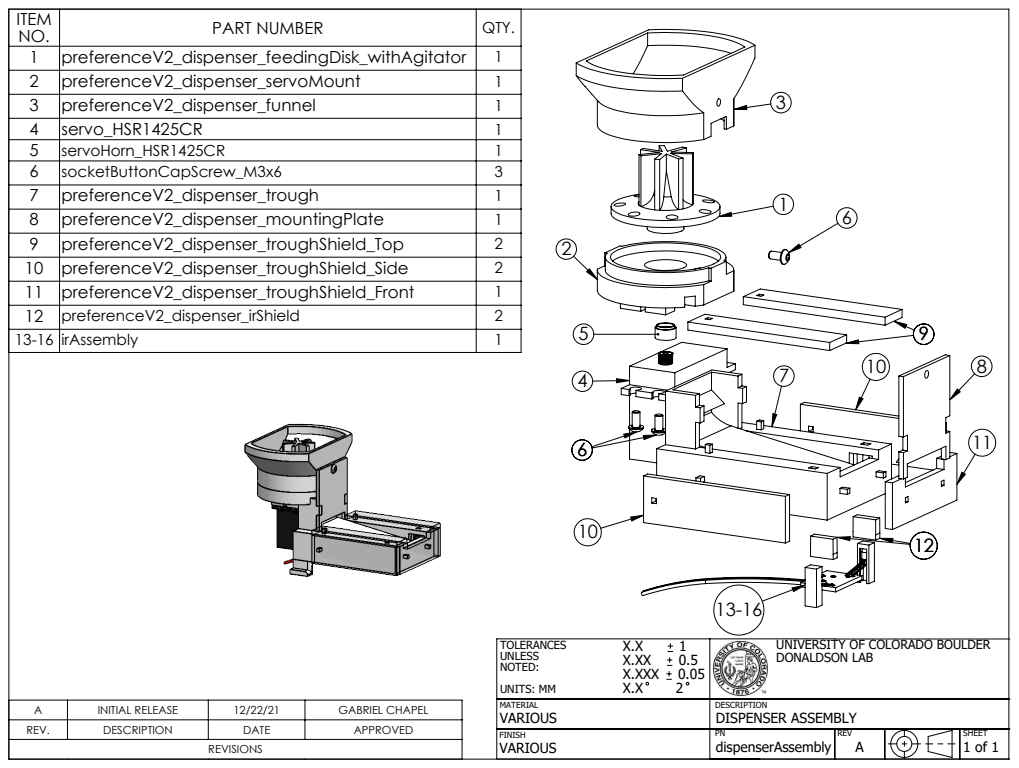
[picture p243: page 1]
INITIAL RELEASE; GABRIEL CHAPEL; DISPENSER ASSEMBLY; X.XXX 0.05; UNITS: MM

ITEM NO. | PART NUMBER | QTY.
1 | preferenceV2_dispenser_feedingDisk_withAgitator | 1
2 | preferenceV2_dispenser_servoMount | 1
3 | preferenceV2_dispenser_funnel | 1
4 | servo_HSR1425CR | 1
5 | servoHorn_HSR1425CR | 1
6 | socketButtonCapScrew_M3x6 | 3
7 | preferenceV2_dispenser_trough | 1
8 | preferenceV2_dispenser_mountingPlate | 1
9 | preferenceV2_dispenser_troughShield_Top | 2
10 | preferenceV2_dispenser_troughShield_Side | 2
11 | preferenceV2_dispenser_troughShield_Front | 1
12 | preferenceV2_dispenser_irShield | 2
13-16 | irAssembly | 1

UNIVERSITY OF COLORADO BOULDER
DONALDSON LAB
