donaldsonlab/Operant-Cage/V3/Drawings/Lever/lvrV2_assembly.pdf

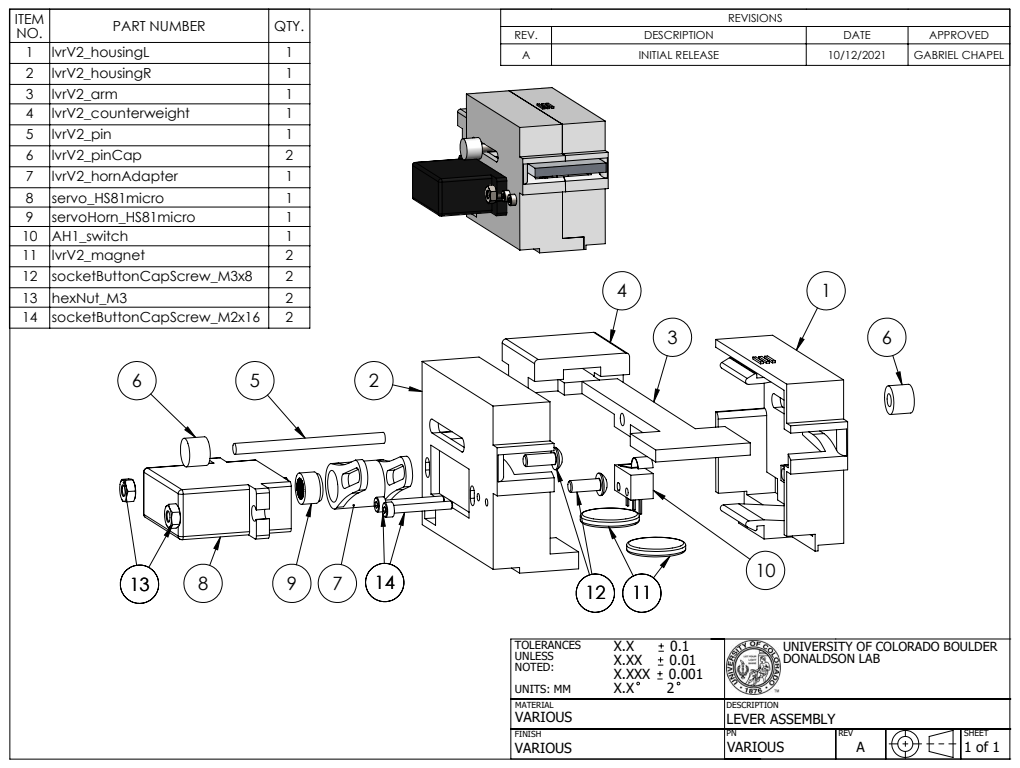
[picture p244: page 1]

ITEM NO. | PART NUMBER | QTY. | | REVISIONS
1 | lvrV2_housingL | 1 | | A | INITIAL RELEASE | 10/12/2021 | GABRIEL CHAPEL
2 | lvrV2_housingR | 1
3 | lvrV2_arm | 1
4 | lvrV2_counterweight | 1
5 | lvrV2_pin | 1
6 | lvrV2_pinCap | 2
7 | lvrV2_hornAdapter | 1
8 | servo_HS81micro | 1
9 | servoHorn_HS81micro | 1
10 | AH1_switch | 1
11 | lvrV2_magnet | 2
12 | socketButtonCapScrew_M3x8 | 2
13 | hexNut_M3 | 2
14 | socketButtonCapScrew_M2x16 | 2

REV. | DESCRIPTION | DATE | APPROVED

TOLERANCES X.X 0.1 UNLESS X.XX 0.01 NOTED: X.XXX 0.001 UNITS: MM X.X 2 | UNIVERSITY OF COLORADO BOULDER DONALDSON LAB

MATERIAL VARIOUS | DESCRIPTION LEVER ASSEMBLY

FINISH VARIOUS | PN VARIOUS | REV A | SHEET 1 of 1
