donaldsonlab/Operant-Cage/V3/Drawings/Dispenser/preferenceV2_dispenser_IRShield.pdf

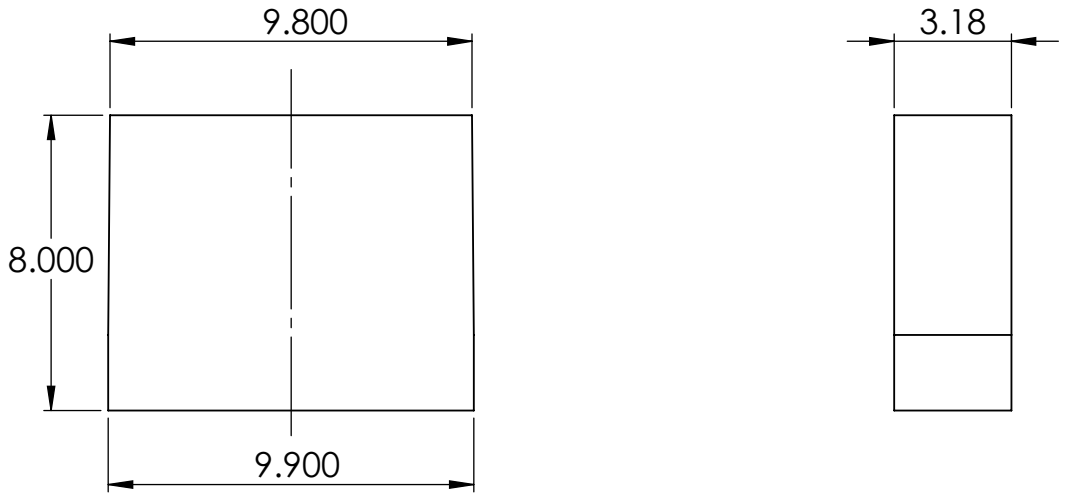
[picture p245: page 1]

9.800 | REVISIONS

REV. | DESCRIPTION | DATE | APPROVED
A | INITIAL RELEASE | 12/22/21 | GABRIEL CHAPEL

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

MATERIAL 1/8" ACRYLIC SHEET | DESCRIPTION IR SHIELD

FINISH NONE | PN dispenser_IRShield | REV A | SHEET 1 of 1
