donaldsonlab/Operant-Cage/V3/Drawings/Dispenser/preferenceV2_dispenser_servoMount.pdf

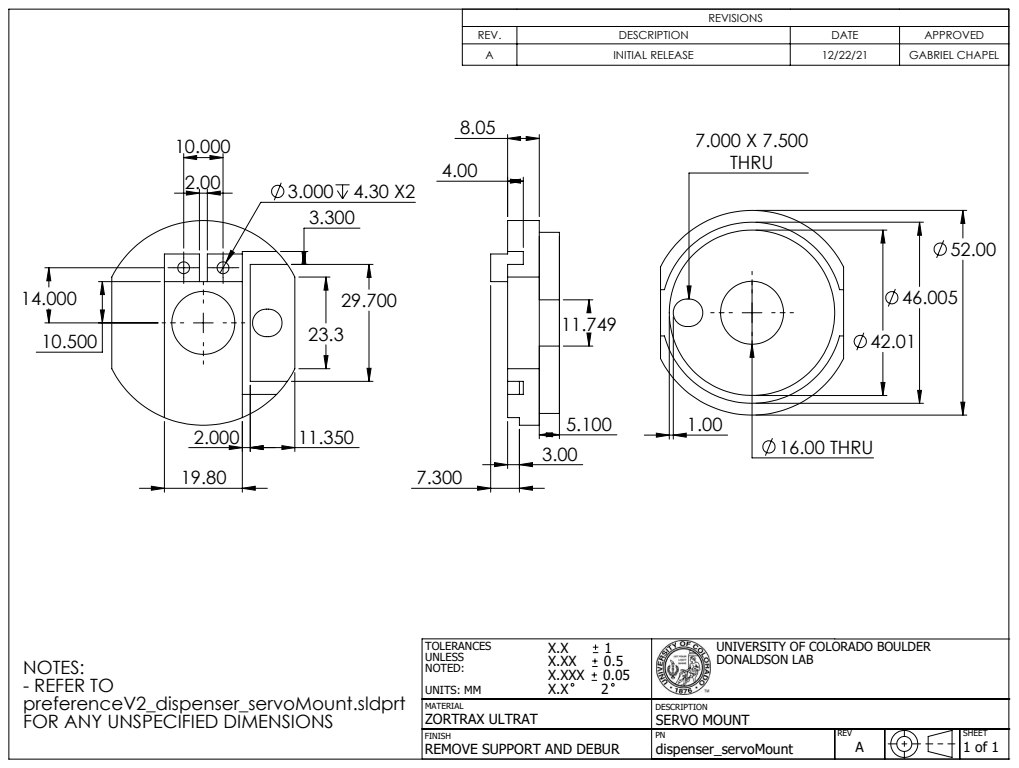
[picture p246: page 1]
16.00 THRU

REVISIONS

REV. | DESCRIPTION | DATE | APPROVED
A | INITIAL RELEASE | 12/22/21 | GABRIEL CHAPEL

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

NOTES:
- REFER TO
preferenceV2_dispenser_servoMount.sldprt
FOR ANY UNSPECIFIED DIMENSIONS

MATERIAL ZORTRAX ULTRAT | DESCRIPTION SERVO MOUNT

FINISH REMOVE SUPPORT AND DEBUR | PN dispenser_servoMount | REV A | SHEET 1 of 1
