donaldsonlab/Operant-Cage/V3/Drawings/Dispenser/preferenceV2_dispenser_trough_mountingPlate.pdf

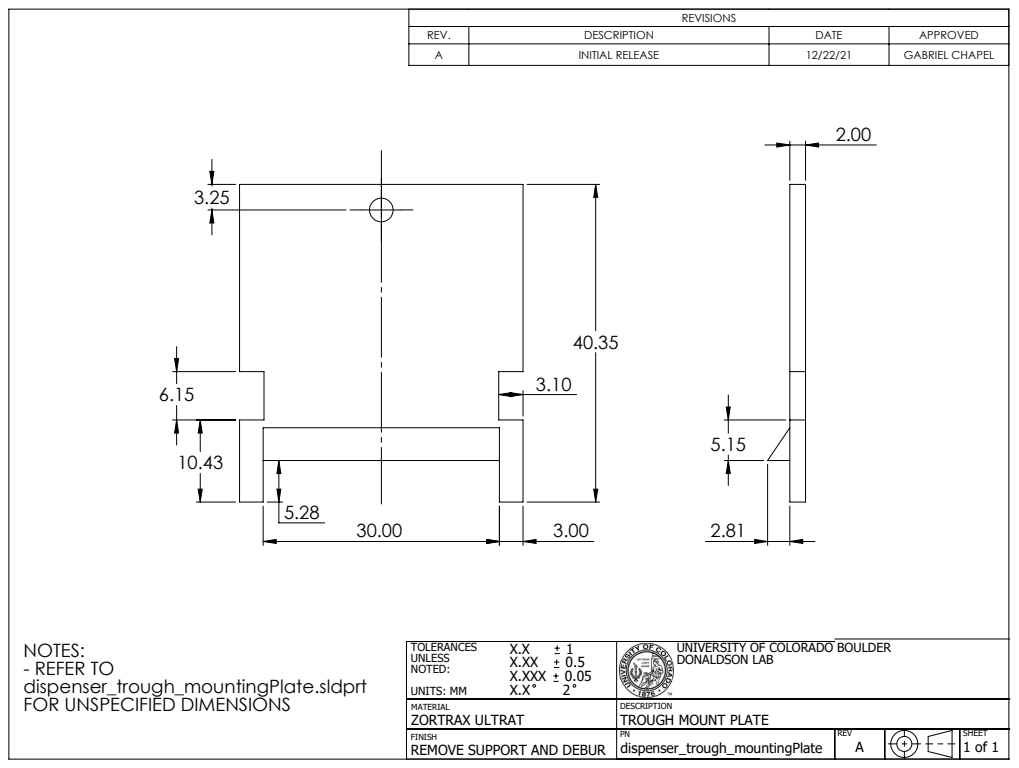
[picture p247: page 1]
X.XXX 0.05; UNITS: MM

REVISIONS

REV. | DESCRIPTION | DATE | APPROVED
A | INITIAL RELEASE | 12/22/21 | GABRIEL CHAPEL

NOTES:
- REFER TO
dispenser_trough_mountingPlate.sldprt
FOR UNSPECIFIED DIMENSIONS

UNIVERSITY OF COLORADO BOULDER
DONALDSON LAB

MATERIAL ZORTRAX ULTRAT | DESCRIPTION TROUGH MOUNT PLATE

FINISH REMOVE SUPPORT AND DEBUR | PN dispenser_trough_mountingPlate | REV A | SHEET 1 of 1
