donaldsonlab/Operant-Cage/V3/Drawings/Lever/lvrV2_arm.pdf

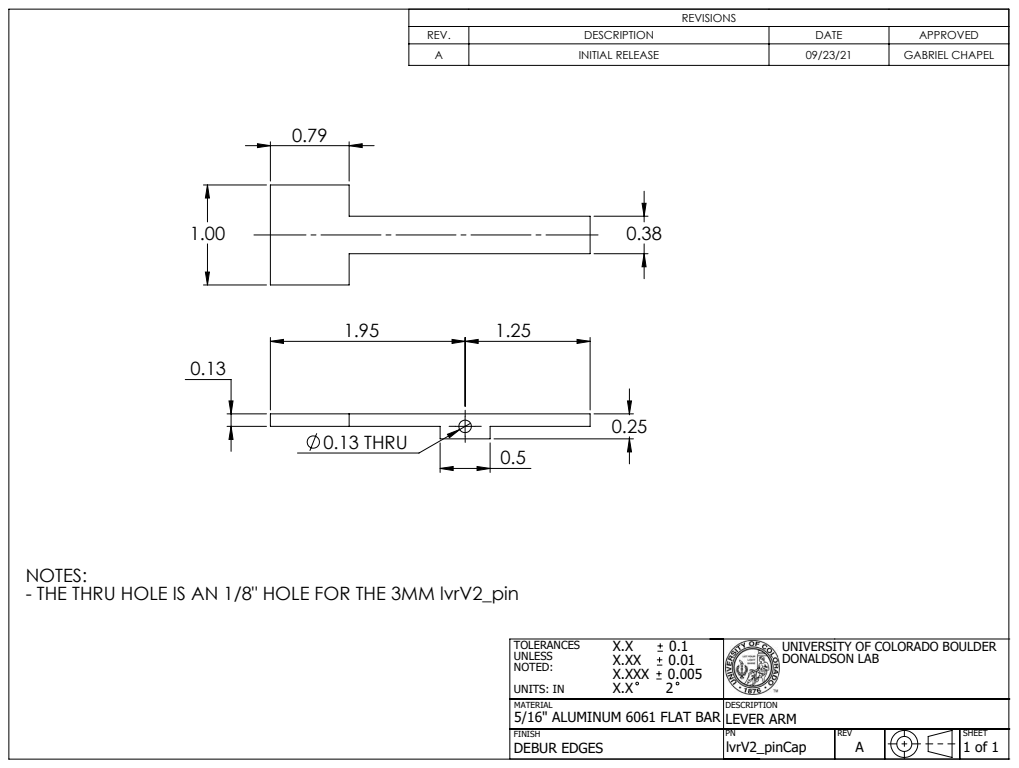
[picture p248: page 1]
0.13 THRU

0.79 | REVISIONS

REV. | DESCRIPTION | DATE | APPROVED
A | INITIAL RELEASE | 09/23/21 | GABRIEL CHAPEL

NOTES:
- THE THRU HOLE IS AN 1/8" HOLE FOR THE 3MM lvrV2_pin

TOLERANCES X.X 0.1 UNLESS X.XX 0.01 NOTED: X.XXX 0.005 UNITS: IN X.X 2 | UNIVERSITY OF COLORADO BOULDER DONALDSON LAB

MATERIAL 5/16" ALUMINUM 6061 FLAT BAR | DESCRIPTION LEVER ARM

FINISH DEBUR EDGES | PN lvrV2_pinCap | REV A | SHEET 1 of 1
