donaldsonlab/Operant-Cage/V3/Drawings/Lever/lvrV2_hornAdapter.pdf

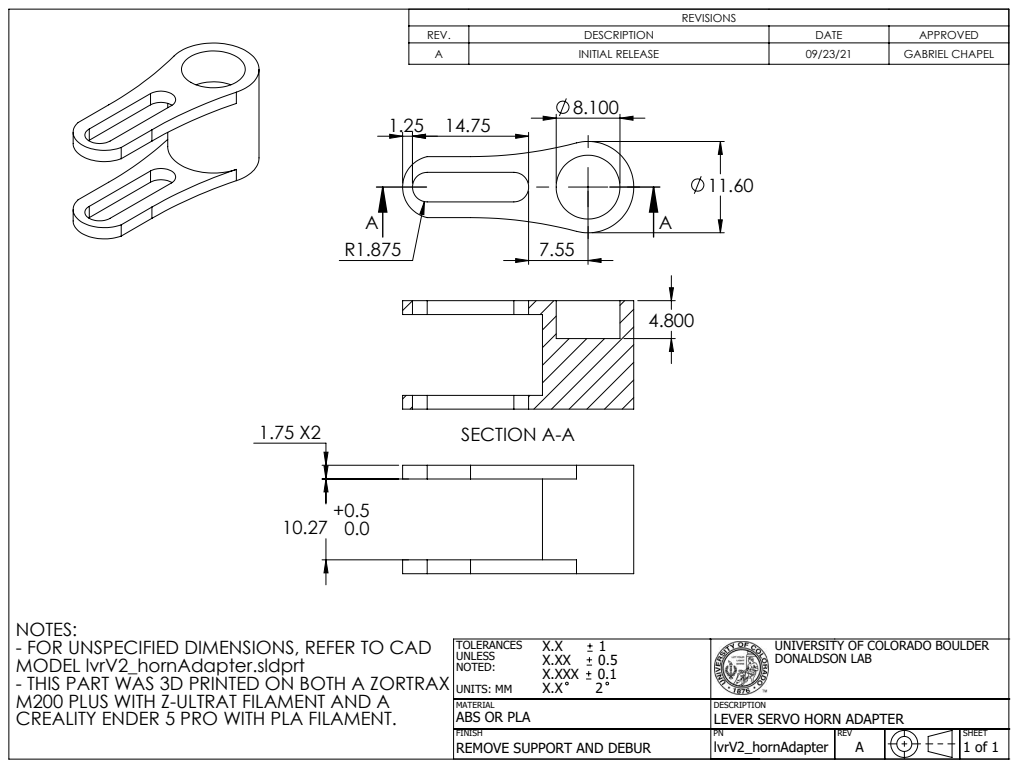
[picture p249: page 1]
SECTION A-A

REVISIONS

REV. | DESCRIPTION | DATE | APPROVED
A | INITIAL RELEASE | 09/23/21 | GABRIEL CHAPEL

NOTES:
- FOR UNSPECIFIED DIMENSIONS, REFER TO CAD
MODEL lvrV2_hornAdapter.sldprt
- THIS PART WAS 3D PRINTED ON BOTH A ZORTRAX
M200 PLUS WITH Z-ULTRAT FILAMENT AND A
CREALITY ENDER 5 PRO WITH PLA FILAMENT.

TOLERANCES X.X 1 UNLESS X.XX 0.5 NOTED: X.XXX 0.1 UNITS: MM X.X 2 | UNIVERSITY OF COLORADO BOULDER DONALDSON LAB

MATERIAL ABS OR PLA | DESCRIPTION LEVER SERVO HORN ADAPTER

FINISH REMOVE SUPPORT AND DEBUR | PN lvrV2_hornAdapter | REV A | SHEET 1 of 1
