donaldsonlab/Operant-Cage/V3/Drawings/Lever/lvrV2_housingL.pdf

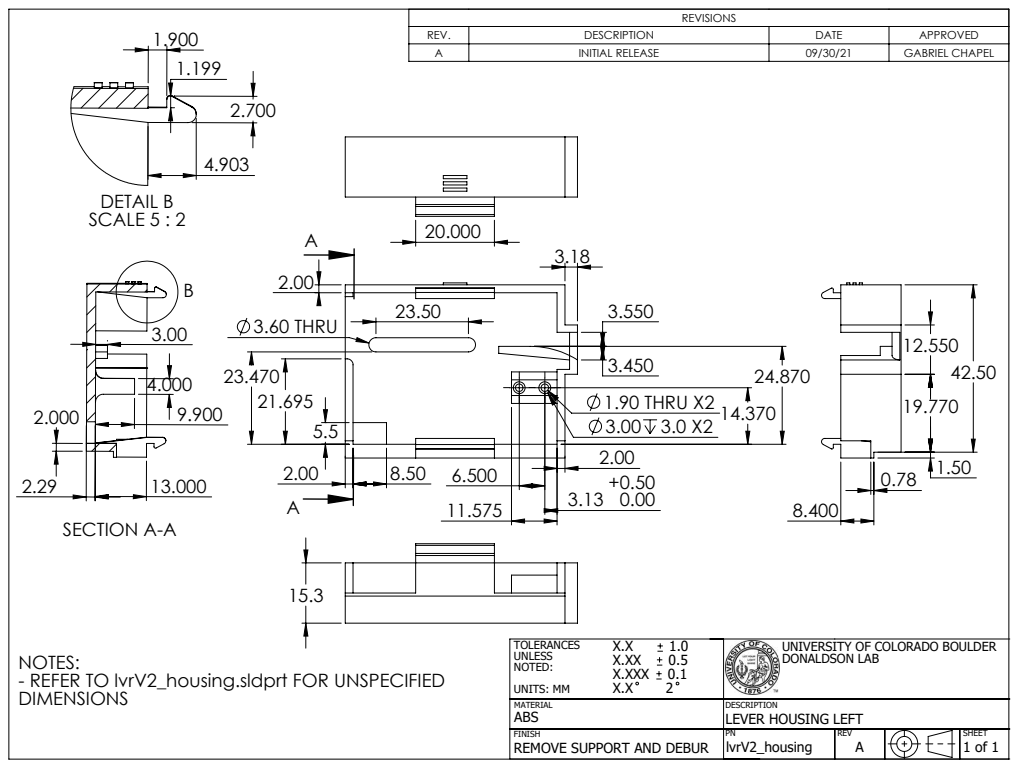
[picture p250: page 1]
3.60 THRU; 1.90 THRU X2; SECTION A-A; DETAIL B SCALE 5 : 2

REVISIONS

REV. | DESCRIPTION | DATE | APPROVED
A | INITIAL RELEASE | 09/30/21 | GABRIEL CHAPEL

TOLERANCES X.X 1.0 UNLESS X.XX 0.5 NOTED: X.XXX 0.1 UNITS: MM X.X 2 | UNIVERSITY OF COLORADO BOULDER DONALDSON LAB

NOTES:
- REFER TO lvrV2_housing.sldprt FOR UNSPECIFIED
DIMENSIONS

MATERIAL ABS | DESCRIPTION LEVER HOUSING LEFT

FINISH REMOVE SUPPORT AND DEBUR | PN lvrV2_housing | REV A | SHEET 1 of 1
