donaldsonlab/Operant-Cage/V3/Drawings/Lever/lvrV2_housingR.pdf

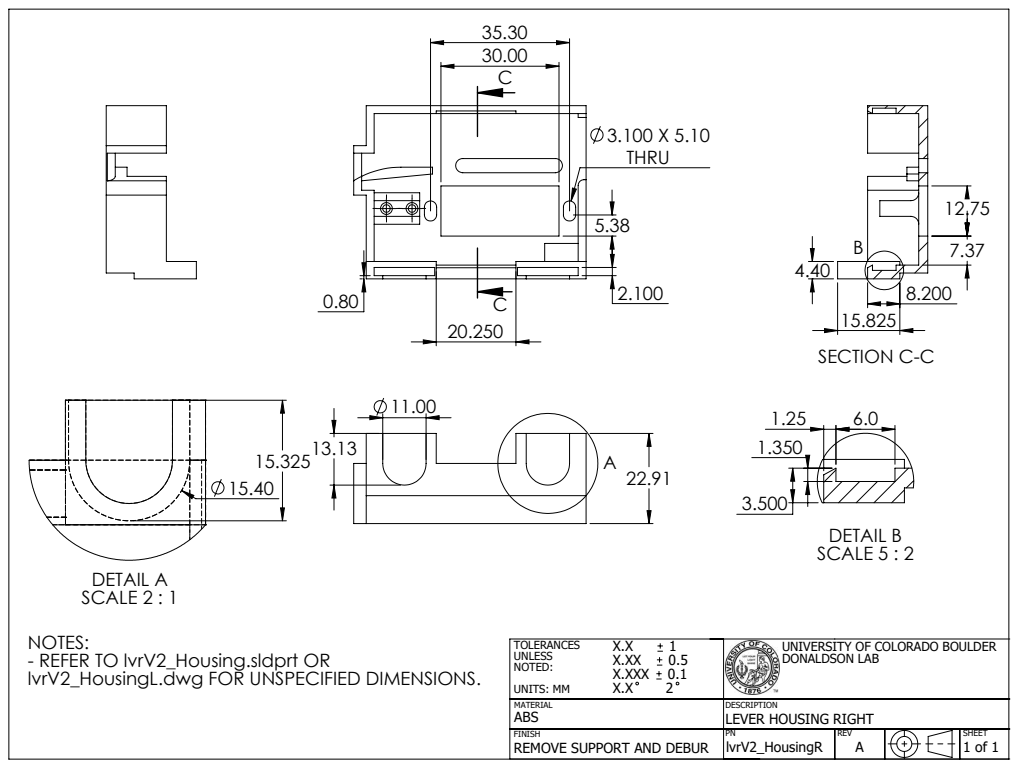
[picture p251: page 1]
SECTION C-C; DETAIL B SCALE 5 : 2

DETAIL A
SCALE 2 : 1
NOTES:
- REFER TO lvrV2_Housing.sldprt OR
lvrV2_HousingL.dwg FOR UNSPECIFIED DIMENSIONS.

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

MATERIAL ABS | DESCRIPTION LEVER HOUSING RIGHT

FINISH REMOVE SUPPORT AND DEBUR | PN lvrV2_HousingR | REV A | SHEET 1 of 1
