donaldsonlab/Operant-Cage/V3/Drawings/Lever/lvrV2_magnetMount.pdf

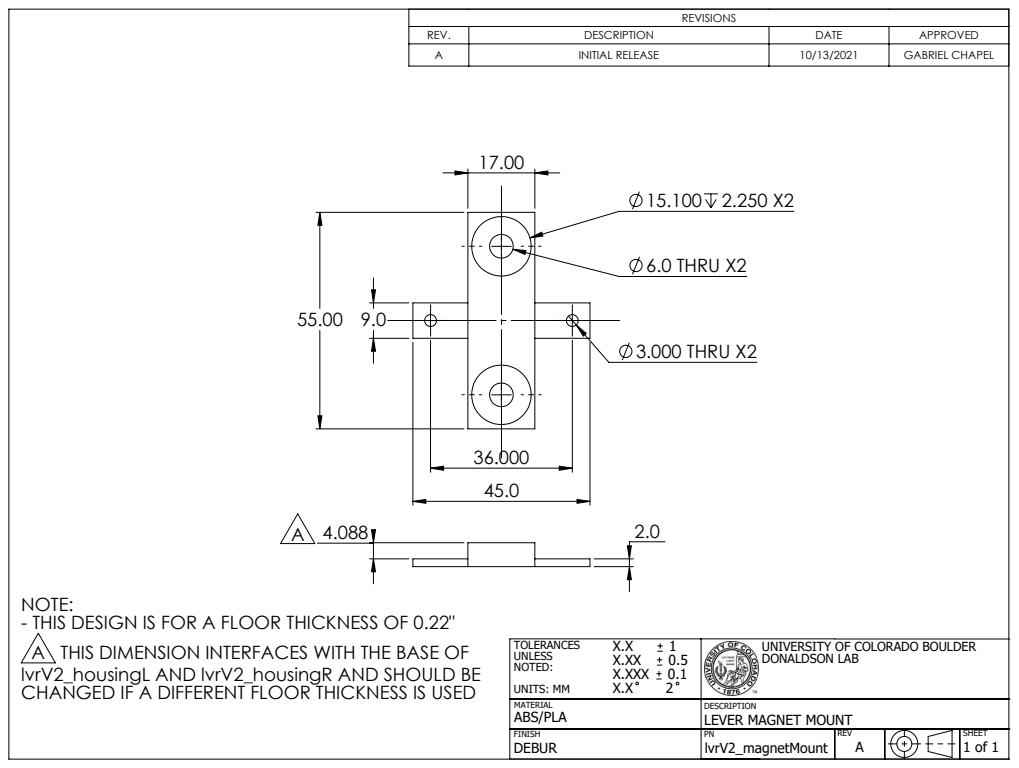
[picture p252: page 1]
6.0 THRU X2; 3.000 THRU X2

REVISIONS

REV. | DESCRIPTION | DATE | APPROVED
A | INITIAL RELEASE | 10/13/2021 | GABRIEL CHAPEL

NOTE:
- THIS DESIGN IS FOR A FLOOR THICKNESS OF 0.22"
A THIS DIMENSION INTERFACES WITH THE BASE OF
lvrV2_housingL AND lvrV2_housingR AND SHOULD BE
CHANGED IF A DIFFERENT FLOOR THICKNESS IS USED

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

MATERIAL ABS/PLA | DESCRIPTION LEVER MAGNET MOUNT

FINISH DEBUR | PN lvrV2_magnetMount | REV A | SHEET 1 of 1
