donaldsonlab/Operant-Cage/V3/Drawings/Lever/lvrV2_pin.PDF

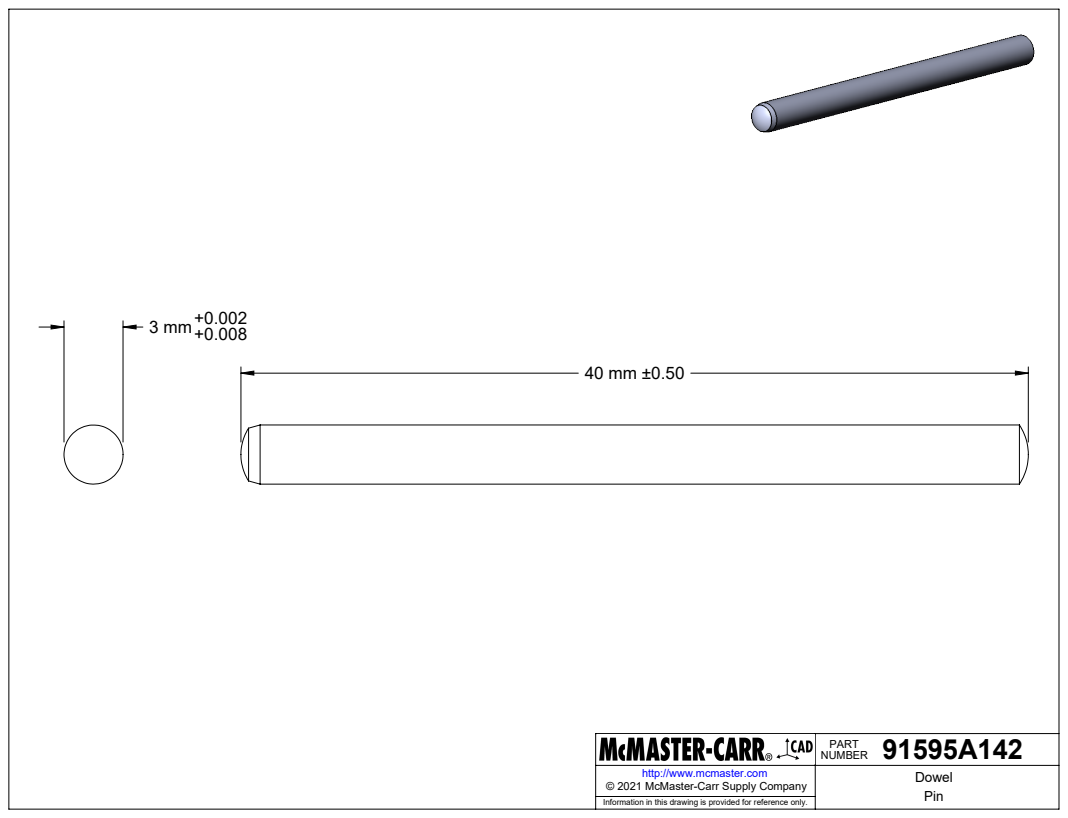
[picture p253: page 1]

91595A142 PART NUMBER

http://www.mcmaster.com | Dowel Pin © 2021 McMaster-Carr Supply Company

Information in this drawing is provided for reference only.
