donaldsonlab/Operant-Cage/V3/Drawings/Lever/lvrV2_pinCap.pdf

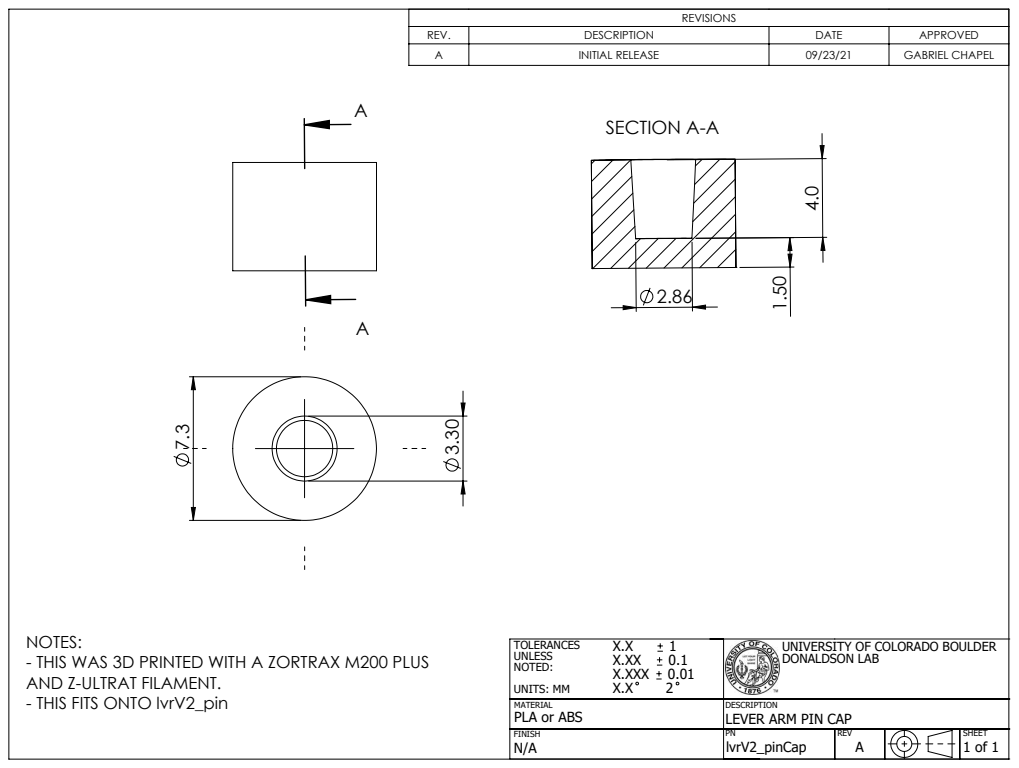
[picture p254: page 1]
SECTION A-A

REVISIONS

REV. | DESCRIPTION | DATE | APPROVED
A | INITIAL RELEASE | 09/23/21 | GABRIEL CHAPEL

NOTES:
- THIS WAS 3D PRINTED WITH A ZORTRAX M200 PLUS
AND Z-ULTRAT FILAMENT.
- THIS FITS ONTO lvrV2_pin

TOLERANCES X.X 1 UNLESS X.XX 0.1 NOTED: X.XXX 0.01 UNITS: MM X.X 2 | UNIVERSITY OF COLORADO BOULDER DONALDSON LAB

MATERIAL PLA or ABS | DESCRIPTION LEVER ARM PIN CAP

FINISH N/A | PN lvrV2_pinCap | REV A | SHEET 1 of 1
