donaldsonlab/Operant-Cage/V3/Lever/lvrDrawing_metric.PDF

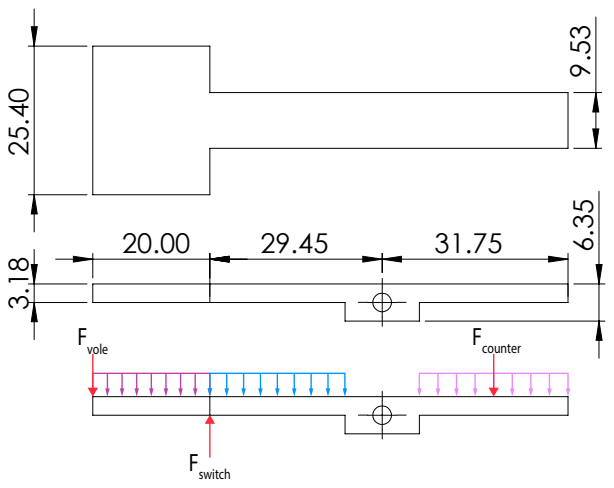
[picture p255: page 1]
