donaldsonlab/Operant-Cage/V3/Drawings/Dispenser/preferenceV2_dispenser_feedingDisk_withAgitator.pdf

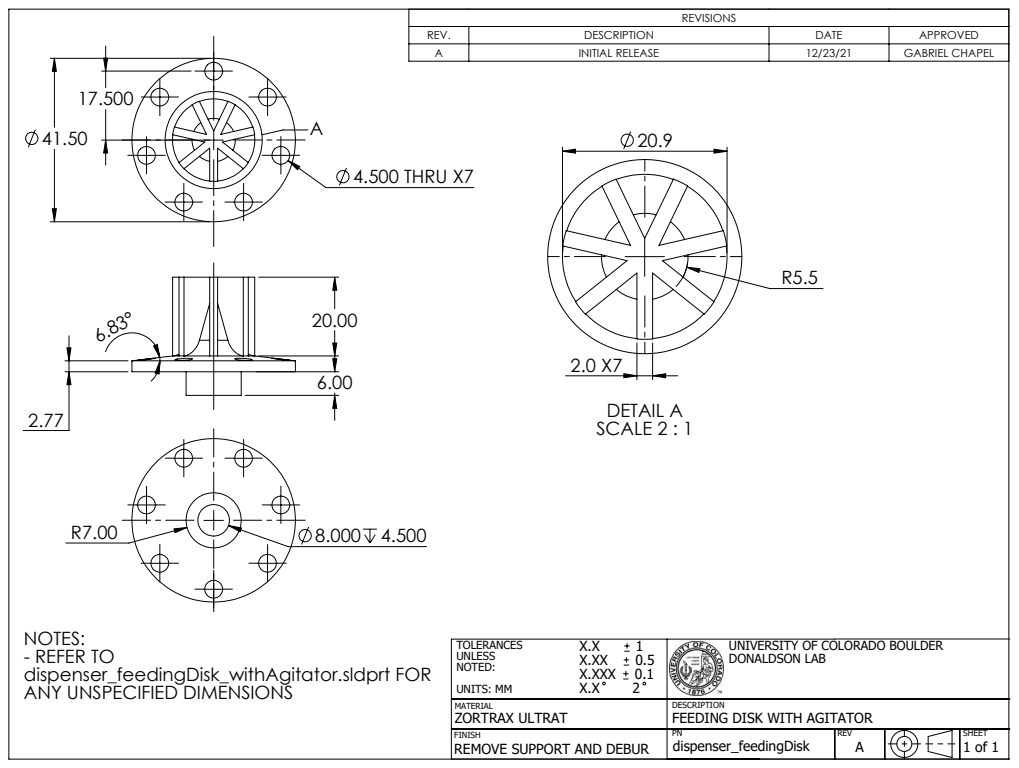
[picture p256: page 1]
4.500 THRU X7; DETAIL A SCALE 2 : 1

REVISIONS

REV. | DESCRIPTION | DATE | APPROVED
A | INITIAL RELEASE | 12/23/21 | GABRIEL CHAPEL

NOTES:
- REFER TO
dispenser_feedingDisk_withAgitator.sldprt FOR
ANY UNSPECIFIED DIMENSIONS

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

MATERIAL ZORTRAX ULTRAT | DESCRIPTION FEEDING DISK WITH AGITATOR

FINISH REMOVE SUPPORT AND DEBUR | PN dispenser_feedingDisk | REV A | SHEET 1 of 1
