donaldsonlab/Operant-Cage/V3/Drawings/Dispenser/preferenceV2_dispenser_funnel.pdf

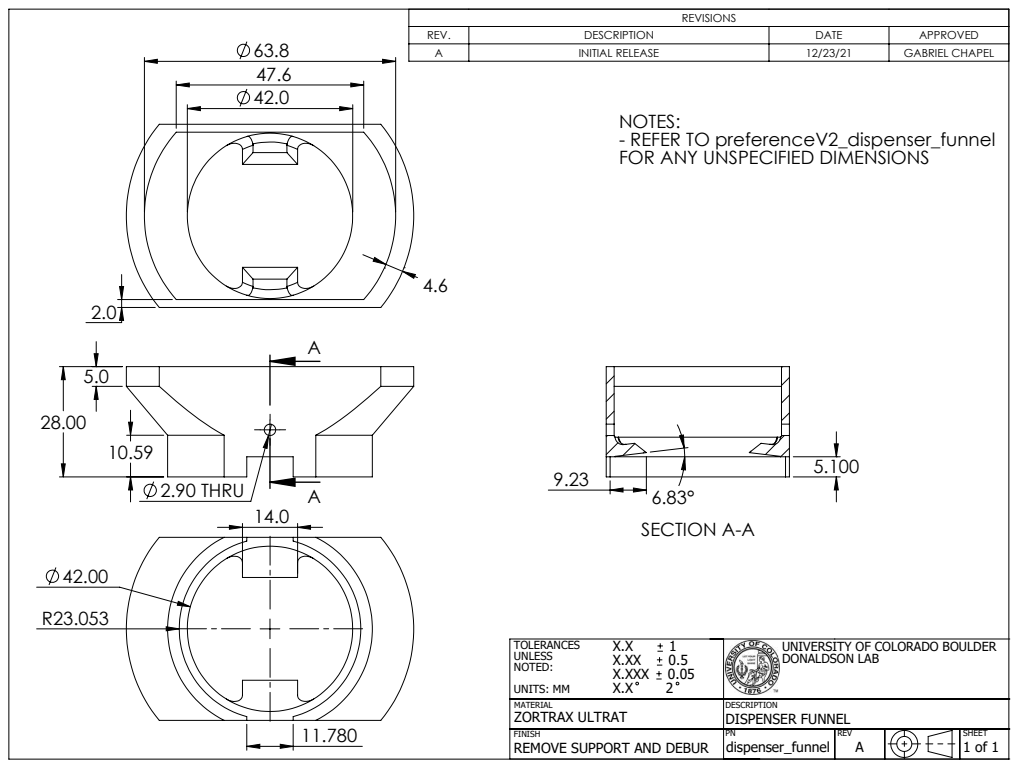
[picture p257: page 1]
2.90 THRU; SECTION A-A

63.8 | REVISIONS

REV. | DESCRIPTION | DATE | APPROVED
A | INITIAL RELEASE | 12/23/21 | GABRIEL CHAPEL

NOTES:
- REFER TO preferenceV2_dispenser_funnel
FOR ANY UNSPECIFIED DIMENSIONS

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

MATERIAL ZORTRAX ULTRAT | DESCRIPTION DISPENSER FUNNEL

FINISH REMOVE SUPPORT AND DEBUR | PN dispenser_funnel | REV A | SHEET 1 of 1
