donaldsonlab/Operant-Cage/V3/Drawings/Dispenser/preferenceV2_dispenser_trough.pdf

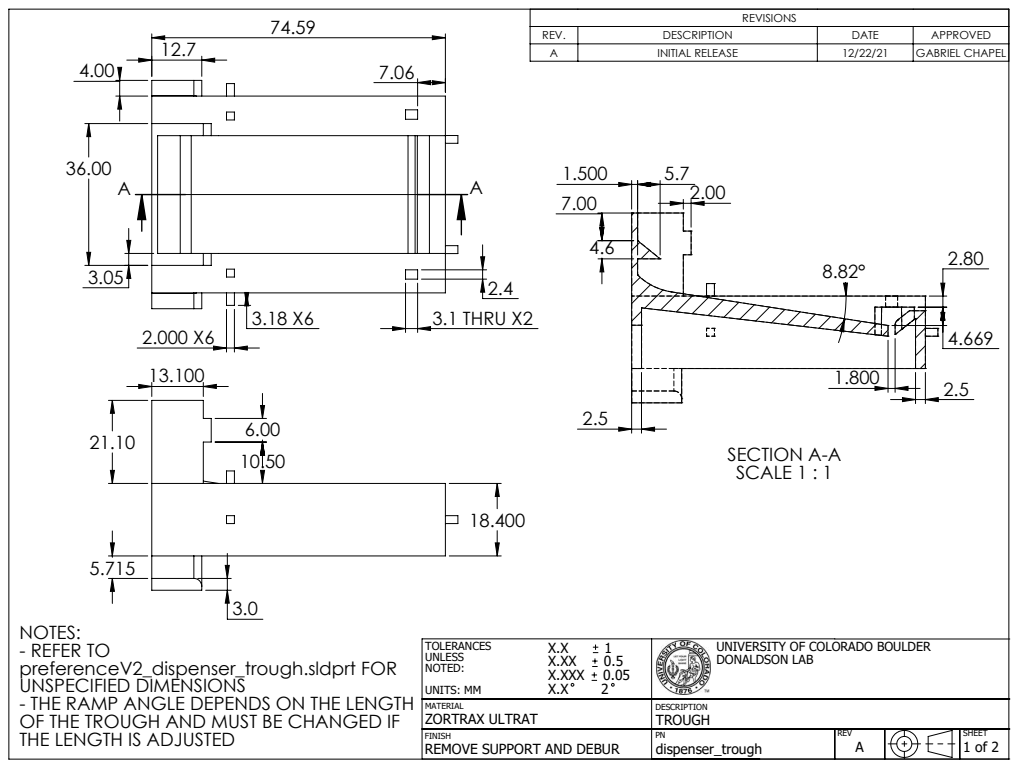
[picture p258: page 1]
3.1 THRU X2; SECTION A-A SCALE 1 : 1

74.59 | REVISIONS

REV. | DESCRIPTION | DATE | APPROVED
A | INITIAL RELEASE | 12/22/21 | GABRIEL CHAPEL

NOTES:
- REFER TO
preferenceV2_dispenser_trough.sldprt FOR
UNSPECIFIED DIMENSIONS
- THE RAMP ANGLE DEPENDS ON THE LENGTH
OF THE TROUGH AND MUST BE CHANGED IF
THE LENGTH IS ADJUSTED

TOLERANCES X.X 1 UNLESS X.XX 0.5 NOTED: X.XXX 0.05 X.X 2 UNITS: MM | UNIVERSITY OF COLORADO BOULDER DONALDSON LAB

MATERIAL ZORTRAX ULTRAT | DESCRIPTION TROUGH

FINISH REMOVE SUPPORT AND DEBUR | PN dispenser_trough | REV A | SHEET 1 of 2

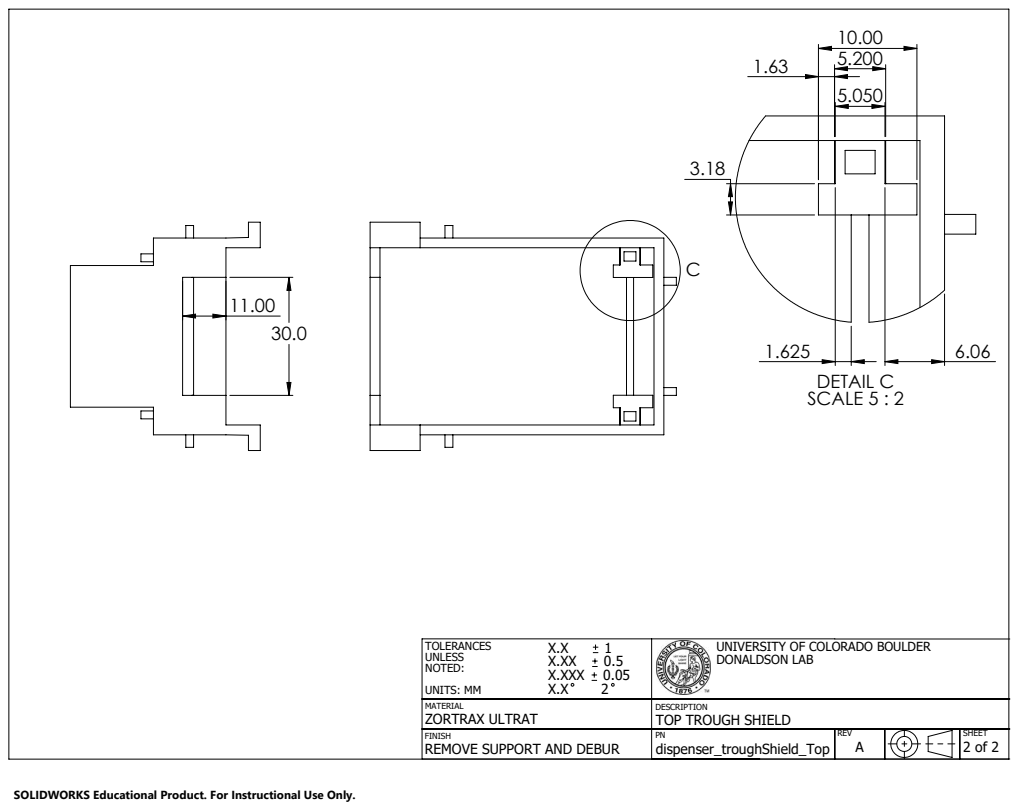
[picture p259: page 2]
DETAIL C SCALE 5 : 2

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

MATERIAL ZORTRAX ULTRAT | DESCRIPTION TOP TROUGH SHIELD

FINISH REMOVE SUPPORT AND DEBUR | PN dispenser_troughShield_Top | REV A | SHEET 2 of 2

SOLIDWORKS Educational Product. For Instructional Use Only.
