donaldsonlab/Operant-Cage/V3/Drawings/Dispenser/preferenceV2_dispenser_troughShield_Side.pdf

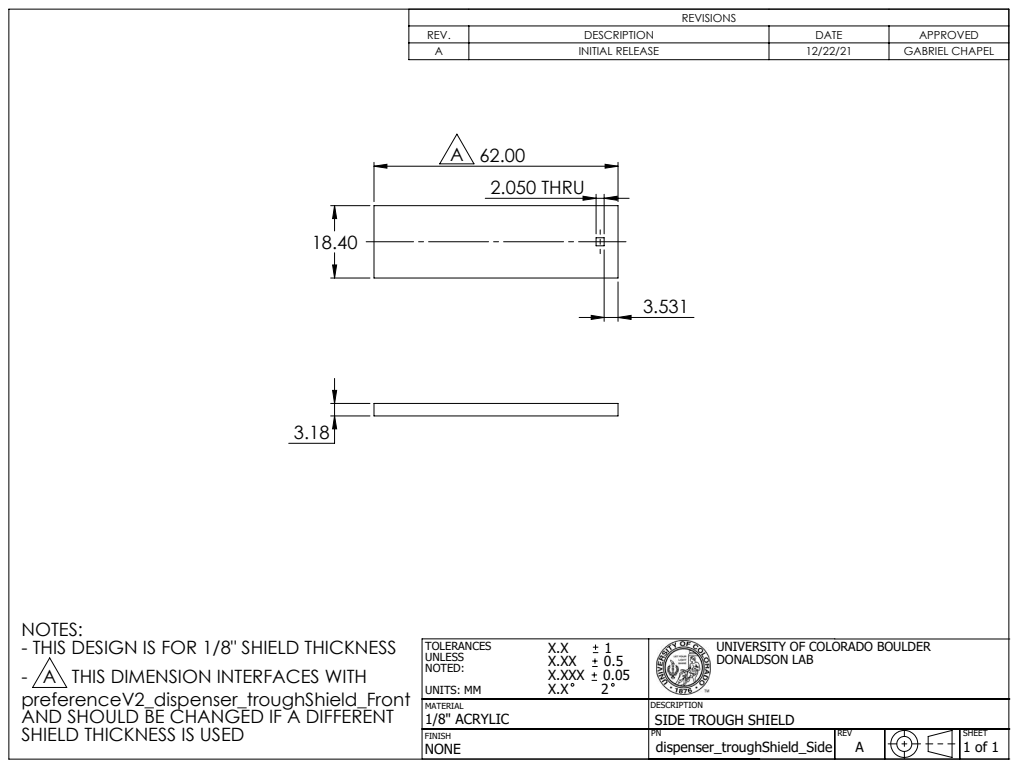
[picture p260: page 1]
2.050 THRU

REVISIONS

REV. | DESCRIPTION | DATE | APPROVED
A | INITIAL RELEASE | 12/22/21 | GABRIEL CHAPEL

NOTES:
- THIS DESIGN IS FOR 1/8" SHIELD THICKNESS
- A THIS DIMENSION INTERFACES WITH
preferenceV2_dispenser_troughShield_Front
AND SHOULD BE CHANGED IF A DIFFERENT
SHIELD THICKNESS IS USED

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

MATERIAL 1/8" ACRYLIC | DESCRIPTION SIDE TROUGH SHIELD

FINISH NONE | PN dispenser_troughShield_Side | REV A | SHEET 1 of 1
