donaldsonlab/Operant-Cage/Hardware/Electrical/Operant_Front_Bonsai_Large.brd

## EAGLE design Hardware/Electrical/Operant_Front_Bonsai_Large.brd (2021-10-21)

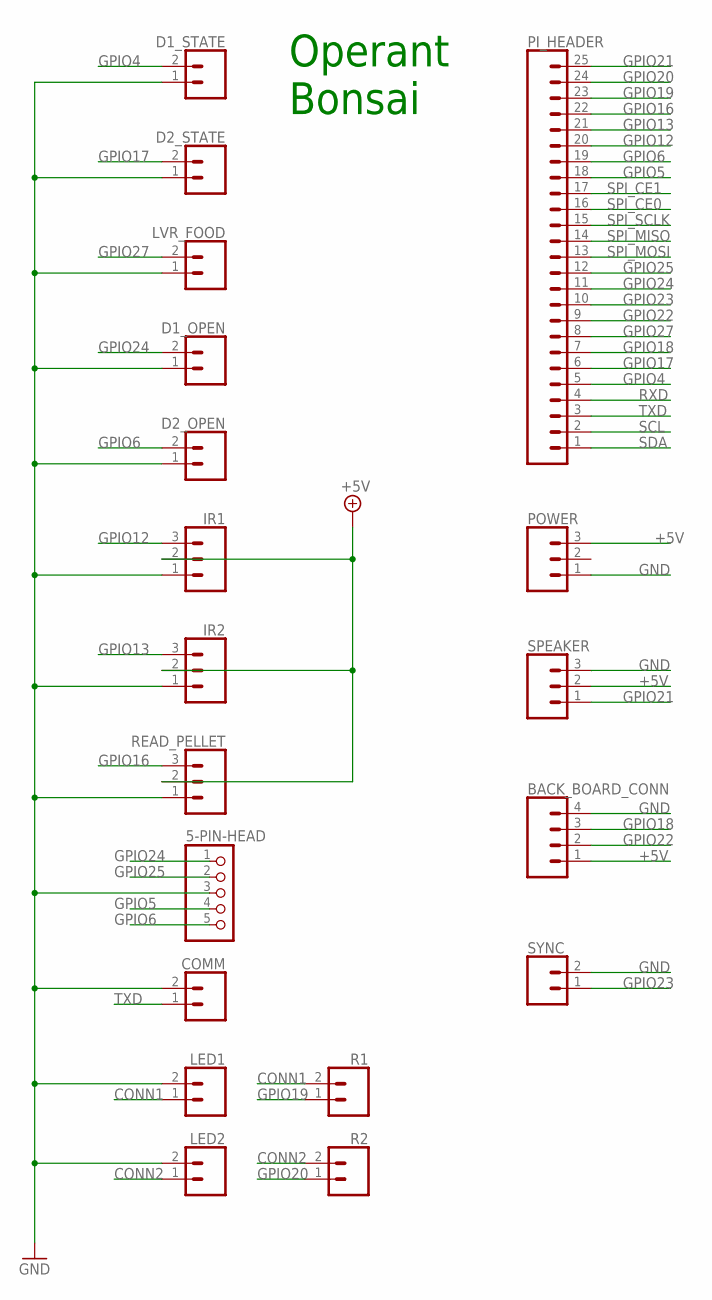
[picture p262: schematic Operant_Front_Bonsai_Large.sch]

Parts:
5-PIN-HEAD: PINHD-1X5; 1X05
BACK_BOARD_CONN: CONN_04JST-PTH; JST-4-PTH
COMM: CONN_02JST-PTH-2; JST-2-PTH
D1_OPEN, D1_STATE, D2_OPEN, D2_STATE: CONN_02JST-PTH-2; JST-2-PTH
IR1, IR2: CONN_03JST-PTH; JST-3-PTH
LED1, LED2: CONN_02; 1X02
LVR_FOOD: CONN_02JST-PTH-2; JST-2-PTH
PI_HEADER: CONN_25; 1X25
POWER: CONN_03; 1X03
R1, R2: CONN_02; 1X02
READ_PELLET: CONN_03JST-PTH; JST-3-PTH
SPEAKER: CONN_03JST-PTH; JST-3-PTH
SYNC: CONN_02; 1X02

Connections:
+5V: BACK_BOARD_CONN.1, IR1.2, IR2.2, POWER.3, READ_PELLET.2, SPEAKER.2
CONN1: LED1.1, R1.2
CONN2: LED2.1, R2.2
GND: 5-PIN-HEAD.3, BACK_BOARD_CONN.4, COMM.2, D1_OPEN.1, D1_STATE.1, D2_OPEN.1, D2_STATE.1, IR1.1, IR2.1, LED1.2, LED2.2, LVR_FOOD.1, POWER.1, READ_PELLET.1, SPEAKER.3, SYNC.2
GPIO4: D1_STATE.2, PI_HEADER.5
GPIO5: 5-PIN-HEAD.4, PI_HEADER.18
GPIO6: 5-PIN-HEAD.5, D2_OPEN.2, PI_HEADER.19
GPIO12: IR1.3, PI_HEADER.20
GPIO13: IR2.3, PI_HEADER.21
GPIO16: PI_HEADER.22, READ_PELLET.3
GPIO17: D2_STATE.2, PI_HEADER.6
GPIO18: BACK_BOARD_CONN.3, PI_HEADER.7
GPIO19: PI_HEADER.23, R1.1
GPIO20: PI_HEADER.24, R2.1
GPIO21: PI_HEADER.25, SPEAKER.1
GPIO22: BACK_BOARD_CONN.2, PI_HEADER.9
GPIO23: PI_HEADER.10, SYNC.1
GPIO24: 5-PIN-HEAD.1, D1_OPEN.2, PI_HEADER.11
GPIO25: 5-PIN-HEAD.2, PI_HEADER.12
GPIO27: LVR_FOOD.2, PI_HEADER.8
RXD: PI_HEADER.4
SCL: PI_HEADER.2
SDA: PI_HEADER.1
SPI_CE0: PI_HEADER.16
SPI_CE1: PI_HEADER.17
SPI_MISO: PI_HEADER.14
SPI_MOSI: PI_HEADER.13
SPI_SCLK: PI_HEADER.15
TXD: COMM.1, PI_HEADER.3

Notes on the sheet:
Operant Bonsai

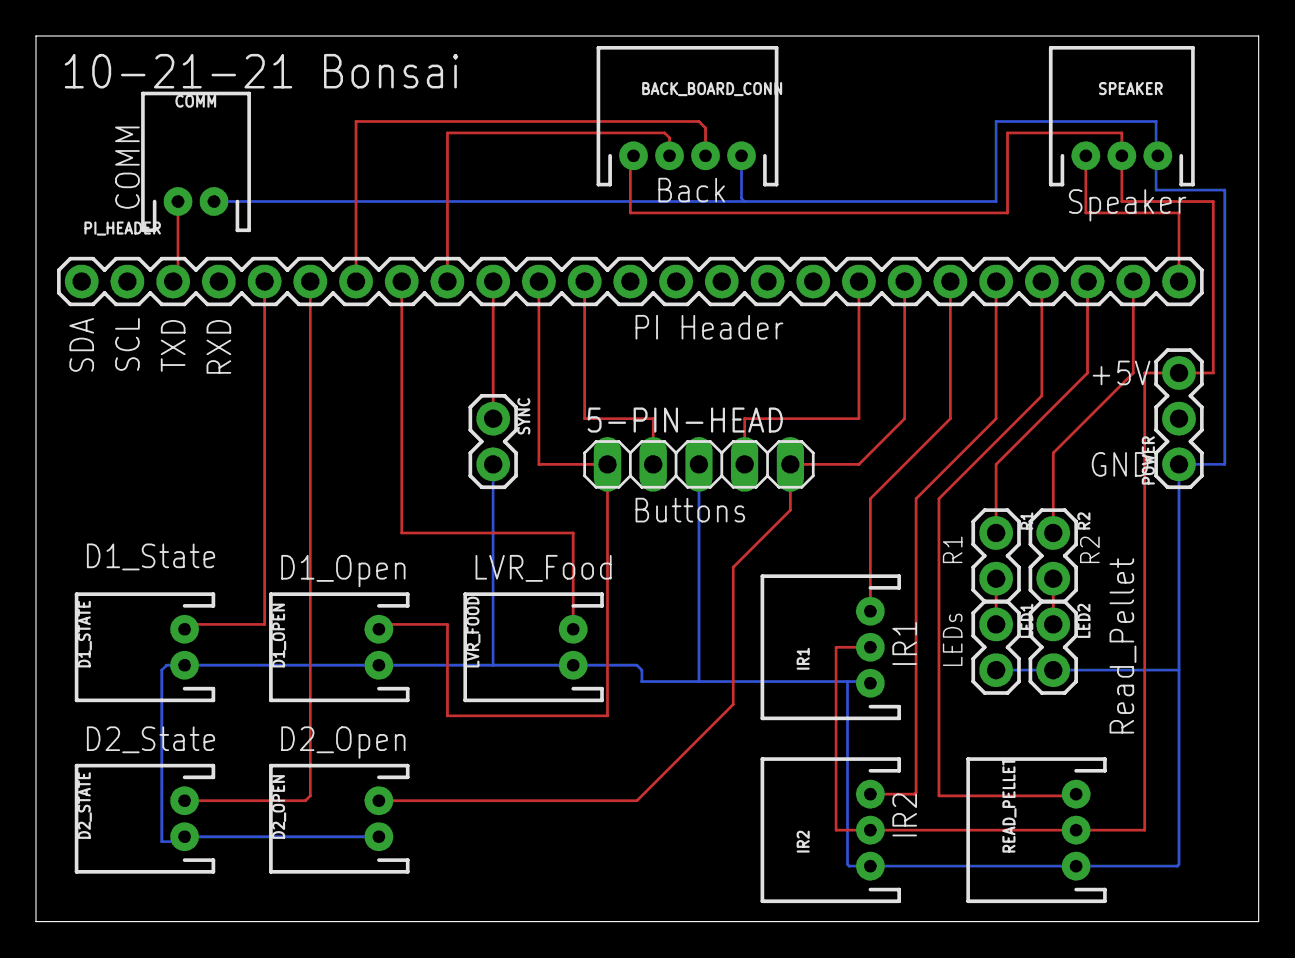
[picture p263: board Operant_Front_Bonsai_Large.brd from above]

Board: 2 copper layers, 67.9 x 49.2 mm, 19 parts (0 on the bottom side), 21 nets.
