donaldsonlab/Operant-Cage/Hardware/Electrical/Operant-Back/Operant-Back.brd

## EAGLE design Hardware/Electrical/Operant-Back/Operant-Back.brd (2021-10-19)

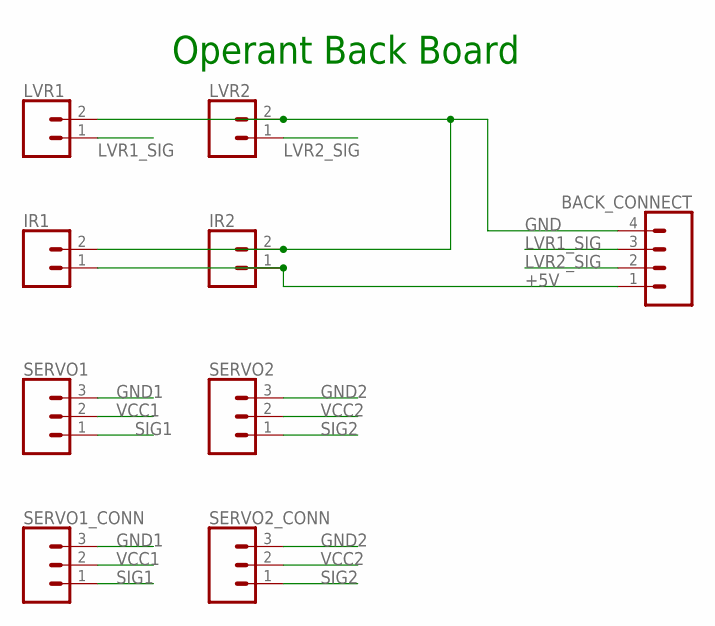
[picture p264: schematic Operant-Back.sch]

Parts:
BACK_CONNECT: CONN_04JST-PTH; JST-4-PTH
IR1, IR2: CONN_02JST-PTH-2; JST-2-PTH
LVR1, LVR2: CONN_02JST-PTH-2; JST-2-PTH
SERVO1, SERVO2: CONN_03; 1X03
SERVO1_CONN, SERVO2_CONN: CONN_03JST-PTH; JST-3-PTH

Connections:
+5V: BACK_CONNECT.1, IR1.1, IR2.1
GND: BACK_CONNECT.4, IR1.2, IR2.2, LVR1.2, LVR2.2
GND1: SERVO1.3, SERVO1_CONN.3
GND2: SERVO2.3, SERVO2_CONN.3
LVR1_SIG: BACK_CONNECT.3, LVR1.1
LVR2_SIG: BACK_CONNECT.2, LVR2.1
SIG1: SERVO1.1, SERVO1_CONN.1
SIG2: SERVO2.1, SERVO2_CONN.1
VCC1: SERVO1.2, SERVO1_CONN.2
VCC2: SERVO2.2, SERVO2_CONN.2

Notes on the sheet:
Operant Back Board

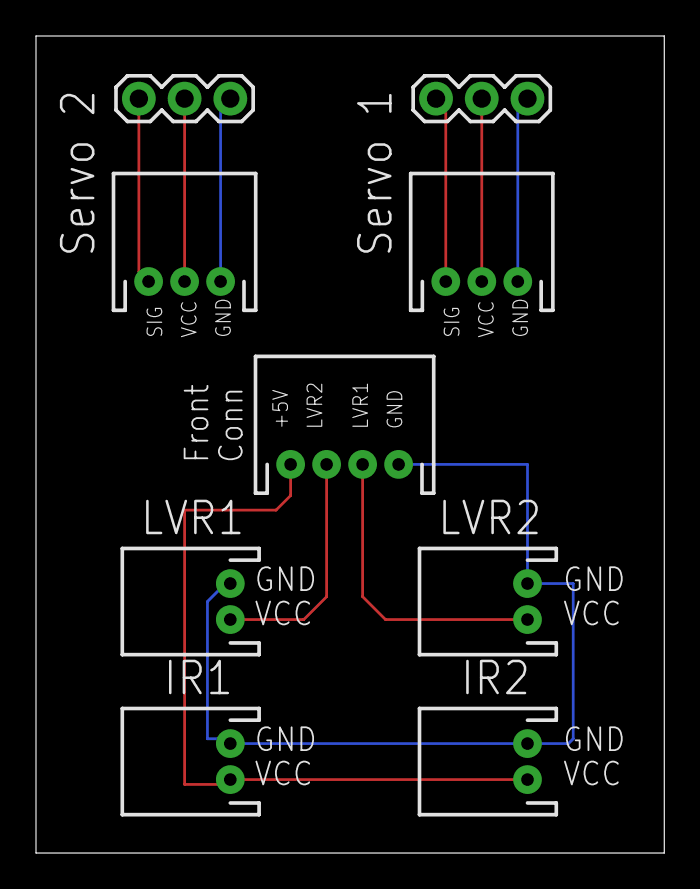
[picture p265: board Operant-Back.brd from above]

Board: 2 copper layers, 34.9 x 45.4 mm, 9 parts (0 on the bottom side), 10 nets.
