donaldsonlab/Operant-Cage/Hardware/Electrical/Adafruit Servo HAT rev A.brd

## EAGLE design Hardware/Electrical/Adafruit Servo HAT rev A.brd (2021-10-12)

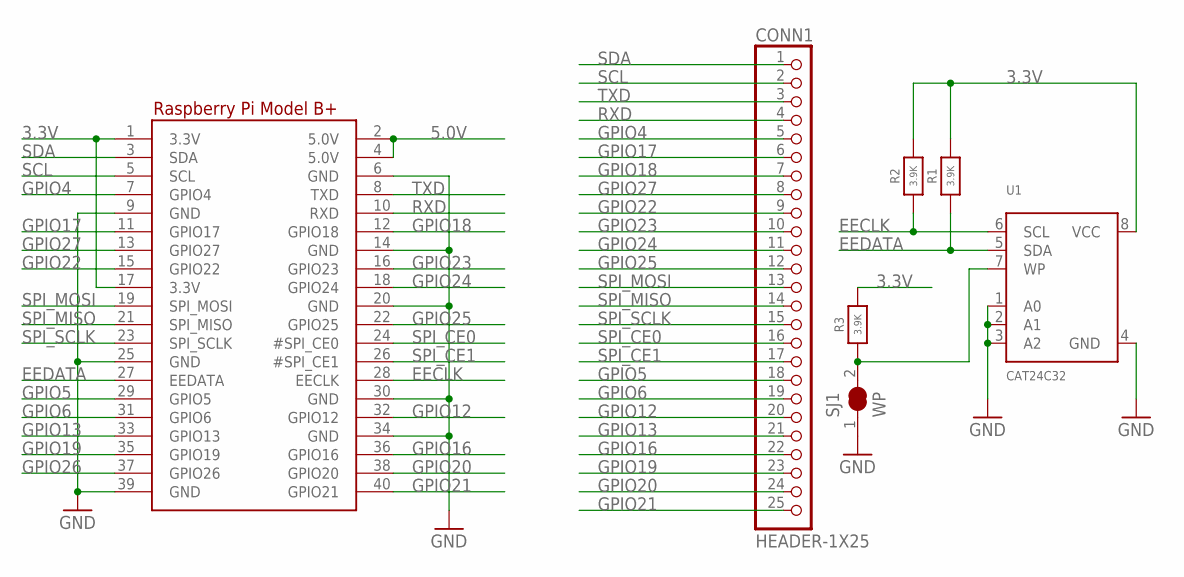
[picture p266: schematic Adafruit Servo HAT rev A.sch, sheet 1]

Parts:
CONN1: HEADER-1X25; 1X25_ROUND_70MIL
R1, R2, R3: 3.9K; 0805-NO
RPI1: RASPBERRYPI_BPLUS_HATSLOTS; PI_HAT_SLOTS
SJ1: WP; SOLDERJUMPER_CLOSEDWIRE
U1: CAT24C32; SOIC8_150MIL

Connections:
3.3V: R1.2, R2.2, R3.2, RPI1.1 (3.3V), RPI1.17 (3.3V), U1.8 (VCC); also elsewhere on the board
5.0V: RPI1.2 (5.0V), RPI1.4 (5.0V)
EECLK: R2.1, RPI1.28 (EECLK), U1.6 (SCL)
EEDATA: R1.1, RPI1.27 (EEDATA), U1.5 (SDA)
GND: RPI1.6 (GND), RPI1.9 (GND), RPI1.14 (GND), RPI1.20 (GND), RPI1.25 (GND), RPI1.30 (GND), RPI1.34 (GND), RPI1.39 (GND), SJ1.1, U1.1 (A0), U1.2 (A1), U1.3 (A2), U1.4 (GND); also elsewhere on the board
GPIO4: CONN1.5, RPI1.7 (GPIO4)
GPIO5: CONN1.18, RPI1.29 (GPIO5)
GPIO6: CONN1.19, RPI1.31 (GPIO6)
GPIO12: CONN1.20, RPI1.32 (GPIO12)
GPIO13: CONN1.21, RPI1.33 (GPIO13)
GPIO16: CONN1.22, RPI1.36 (GPIO16)
GPIO17: CONN1.6, RPI1.11 (GPIO17)
GPIO18: CONN1.7, RPI1.12 (GPIO18)
GPIO19: CONN1.23, RPI1.35 (GPIO19)
GPIO20: CONN1.24, RPI1.38 (GPIO20)
GPIO21: CONN1.25, RPI1.40 (GPIO21)
GPIO22: CONN1.9, RPI1.15 (GPIO22)
GPIO23: CONN1.10, RPI1.16 (GPIO23)
GPIO24: CONN1.11, RPI1.18 (GPIO24)
GPIO25: CONN1.12, RPI1.22 (GPIO25)
GPIO26: RPI1.37 (GPIO26)
GPIO27: CONN1.8, RPI1.13 (GPIO27)
unnamed: R3.1, SJ1.2, U1.7 (WP)
RXD: CONN1.4, RPI1.10 (RXD)
SCL: CONN1.2, RPI1.5 (SCL); also elsewhere on the board
SDA: CONN1.1, RPI1.3 (SDA); also elsewhere on the board
SPI_CE0: CONN1.16, RPI1.24 (#SPI_CE0)
SPI_CE1: CONN1.17, RPI1.26 (#SPI_CE1)
SPI_MISO: CONN1.14, RPI1.21 (SPI_MISO)
SPI_MOSI: CONN1.13, RPI1.19 (SPI_MOSI)
SPI_SCLK: CONN1.15, RPI1.23 (SPI_SCLK)
TXD: CONN1.3, RPI1.8 (TXD)

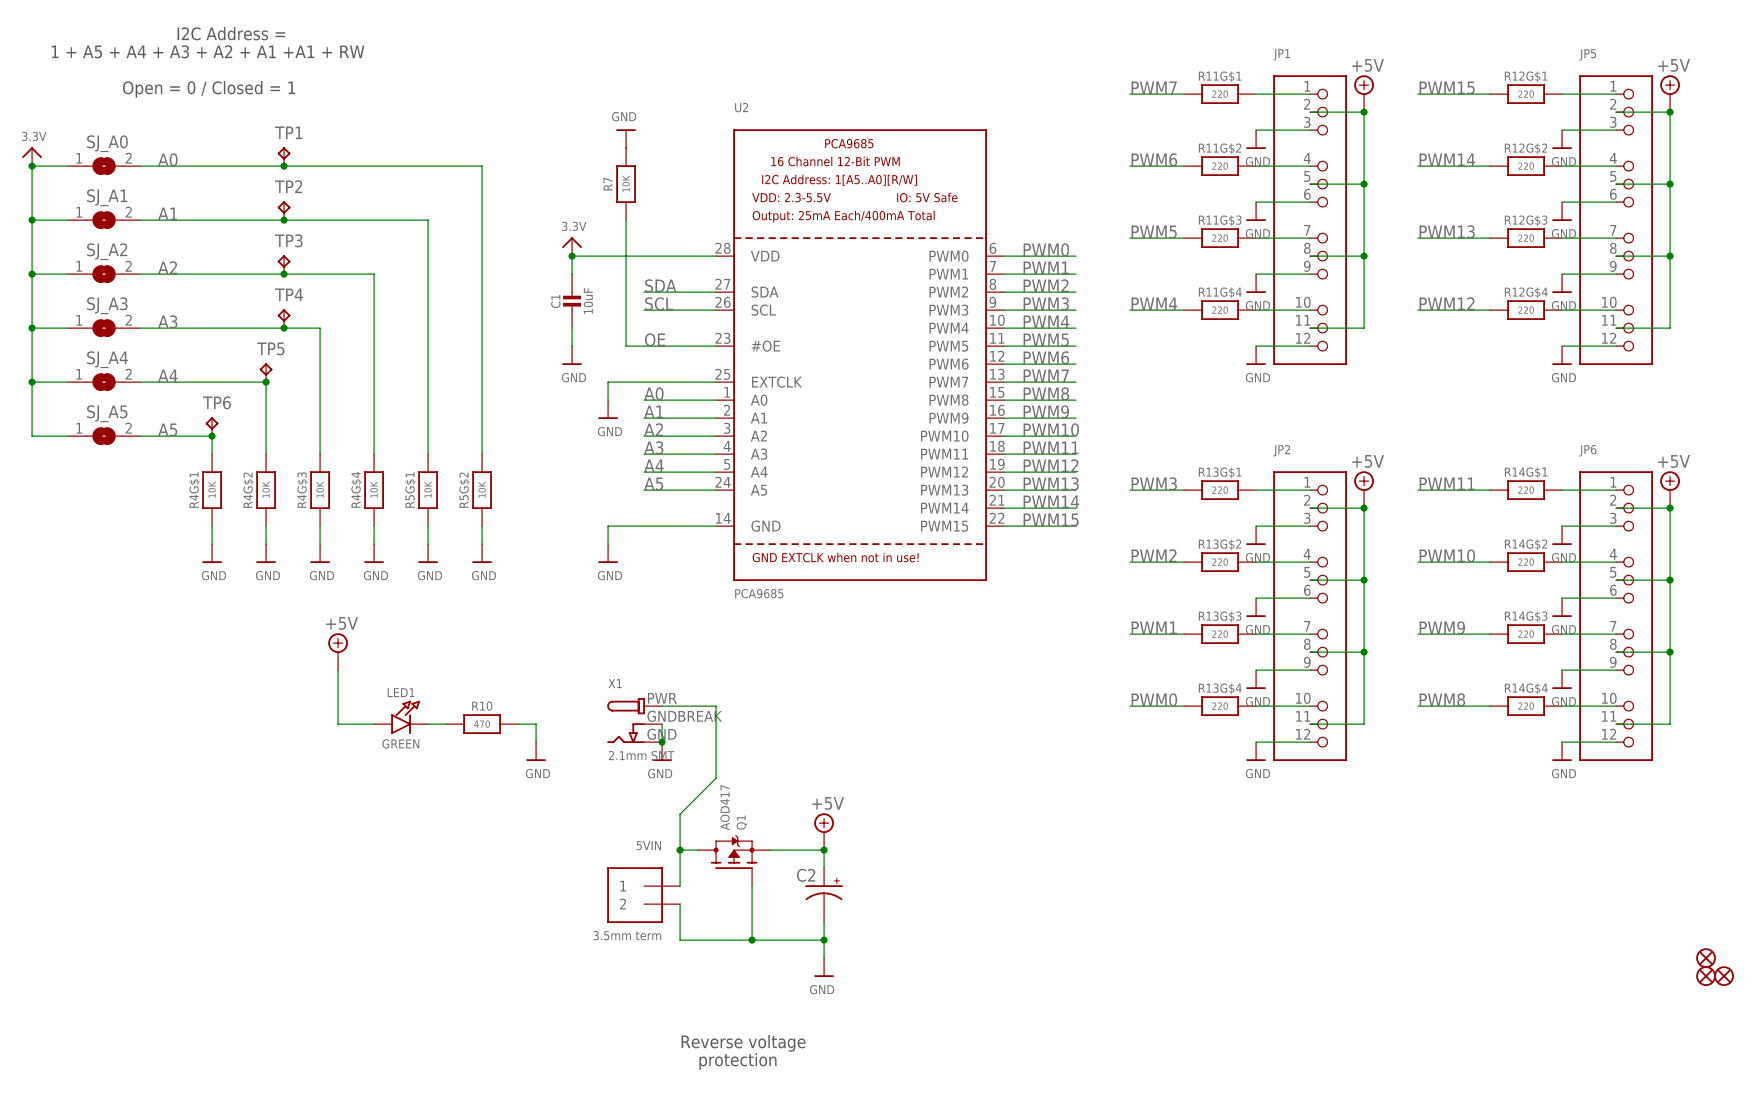
[picture p267: schematic Adafruit Servo HAT rev A.sch, sheet 2]

Parts:
5VIN: 3.5mm term; TERMBLOCK_1X2-3.5MM
C1: 10uF; 0805-NO
C2: CPOL-USE3.5-8; E3,5-8
FID1, FID2, FID3: FIDUCIAL""; FIDUCIAL_1MM
JP1, JP2, JP5, JP6: HEADER-3X04; 3X04
LED1: GREEN; CHIPLED_0805_NOOUTLINE
Q1: AOD417; TO252
R4, R5: 10K; RESPACK_4X0603
R7: 10K; 0805-NO
R10: 470; _0805MP
R11, R12, R13, R14: 220; RESPACK_4X0603
SJ_A0, SJ_A1, SJ_A2, SJ_A3, SJ_A4, SJ_A5: SOLDERJUMPERREFLOW_NOPASTE; SOLDERJUMPER_REFLOW_NOPASTE
TP1, TP2, TP3, TP4, TP5, TP6: TPB1,27; B1,27
U2: PCA9685; TSSOP28
X1: 2.1mm SMT; DCJACK_2MM_SMT

Connections:
3.3V: C1.1, SJ_A0.1, SJ_A1.1, SJ_A2.1, SJ_A3.1, SJ_A4.1, SJ_A5.1, U2.28 (VDD); also elsewhere on the board
+5V: C2.+, JP1.2, JP1.5, JP1.8, JP1.11, JP2.2, JP2.5, JP2.8, JP2.11, JP5.2, JP5.5, JP5.8, JP5.11, JP6.2, JP6.5, JP6.8, JP6.11, LED1.A, Q1.2 (S)
A0: R5.7 (2), SJ_A0.2, TP1.TP, U2.1 (A0)
A1: R5.8 (2), SJ_A1.2, TP2.TP, U2.2 (A1)
A2: R4.5 (2), SJ_A2.2, TP3.TP, U2.3 (A2)
A3: R4.6 (2), SJ_A3.2, TP4.TP, U2.4 (A3)
A4: R4.7 (2), SJ_A4.2, TP5.TP, U2.5 (A4)
A5: R4.8 (2), SJ_A5.2, TP6.TP, U2.24 (A5)
GND: 5VIN.2, C1.2, C2.-, JP1.3, JP1.6, JP1.9, JP1.12, JP2.3, JP2.6, JP2.9, JP2.12, JP5.3, JP5.6, JP5.9, JP5.12, JP6.3, JP6.6, JP6.9, JP6.12, Q1.1 (G), R4.1, R4.2 (1), R4.3 (1), R4.4 (1), R5.1, R5.2 (1), R7.2, R10.2, U2.14 (GND), U2.25 (EXTCLK), X1.GND, X1.GNDBREAK; also elsewhere on the board
unnamed: LED1.C, R10.1
unnamed: JP1.4, R11.7 (2)
unnamed: JP1.1, R11.8 (2)
unnamed: JP1.7, R11.6 (2)
unnamed: JP1.10, R11.5 (2)
unnamed: JP2.1, R13.8 (2)
unnamed: JP2.4, R13.7 (2)
unnamed: JP2.7, R13.6 (2)
unnamed: JP2.10, R13.5 (2)
unnamed: JP6.10, R14.5 (2)
unnamed: JP6.7, R14.6 (2)
unnamed: JP6.4, R14.7 (2)
unnamed: JP6.1, R14.8 (2)
unnamed: JP5.10, R12.5 (2)
unnamed: JP5.7, R12.6 (2)
unnamed: JP5.4, R12.7 (2)
unnamed: JP5.1, R12.8 (2)
OE: R7.1, U2.23 (#OE)
PWM0: R13.4 (1), U2.6 (PWM0)
PWM1: R13.3 (1), U2.7 (PWM1)
PWM2: R13.2 (1), U2.8 (PWM2)
PWM3: R13.1, U2.9 (PWM3)
PWM4: R11.4 (1), U2.10 (PWM4)
PWM5: R11.3 (1), U2.11 (PWM5)
PWM6: R11.2 (1), U2.12 (PWM6)
PWM7: R11.1, U2.13 (PWM7)
PWM8: R14.4 (1), U2.15 (PWM8)
PWM9: R14.3 (1), U2.16 (PWM9)
PWM10: R14.2 (1), U2.17 (PWM10)
PWM11: R14.1, U2.18 (PWM11)
PWM12: R12.4 (1), U2.19 (PWM12)
PWM13: R12.3 (1), U2.20 (PWM13)
PWM14: R12.2 (1), U2.21 (PWM14)
PWM15: R12.1, U2.22 (PWM15)
PWRIN: 5VIN.1, Q1.3 (D), X1.PWR
SCL: U2.26 (SCL); also elsewhere on the board
SDA: U2.27 (SDA); also elsewhere on the board

Notes on the sheet:
Reverse voltage
protection
1 + A5 + A4 + A3 + A2 + A1 +A1 + RW
I2C Address =
Open = 0 / Closed = 1

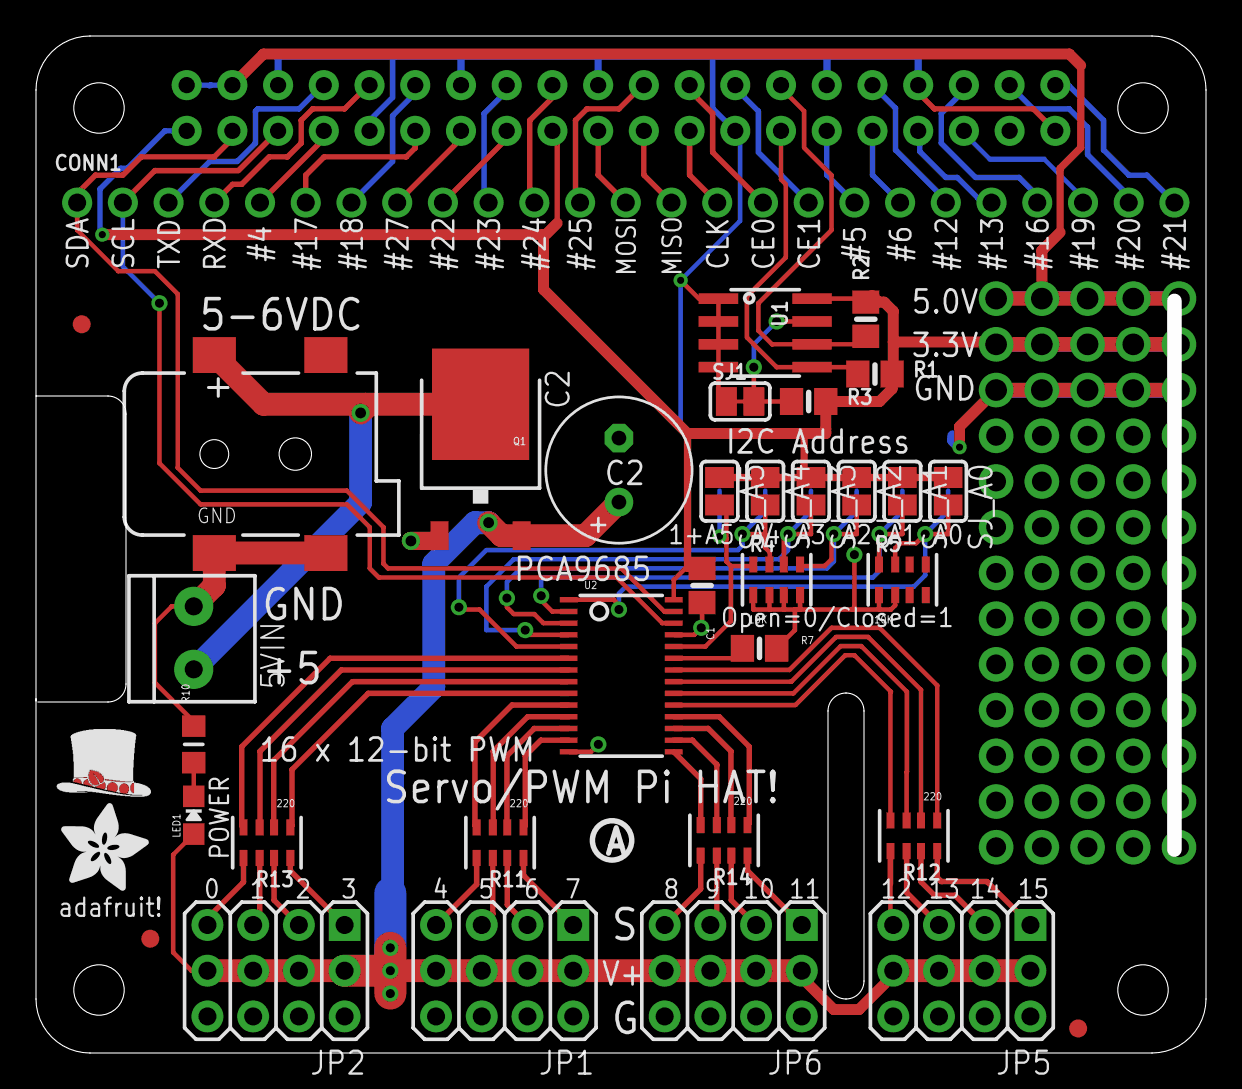
[picture p268: board Adafruit Servo HAT rev A.brd from above]

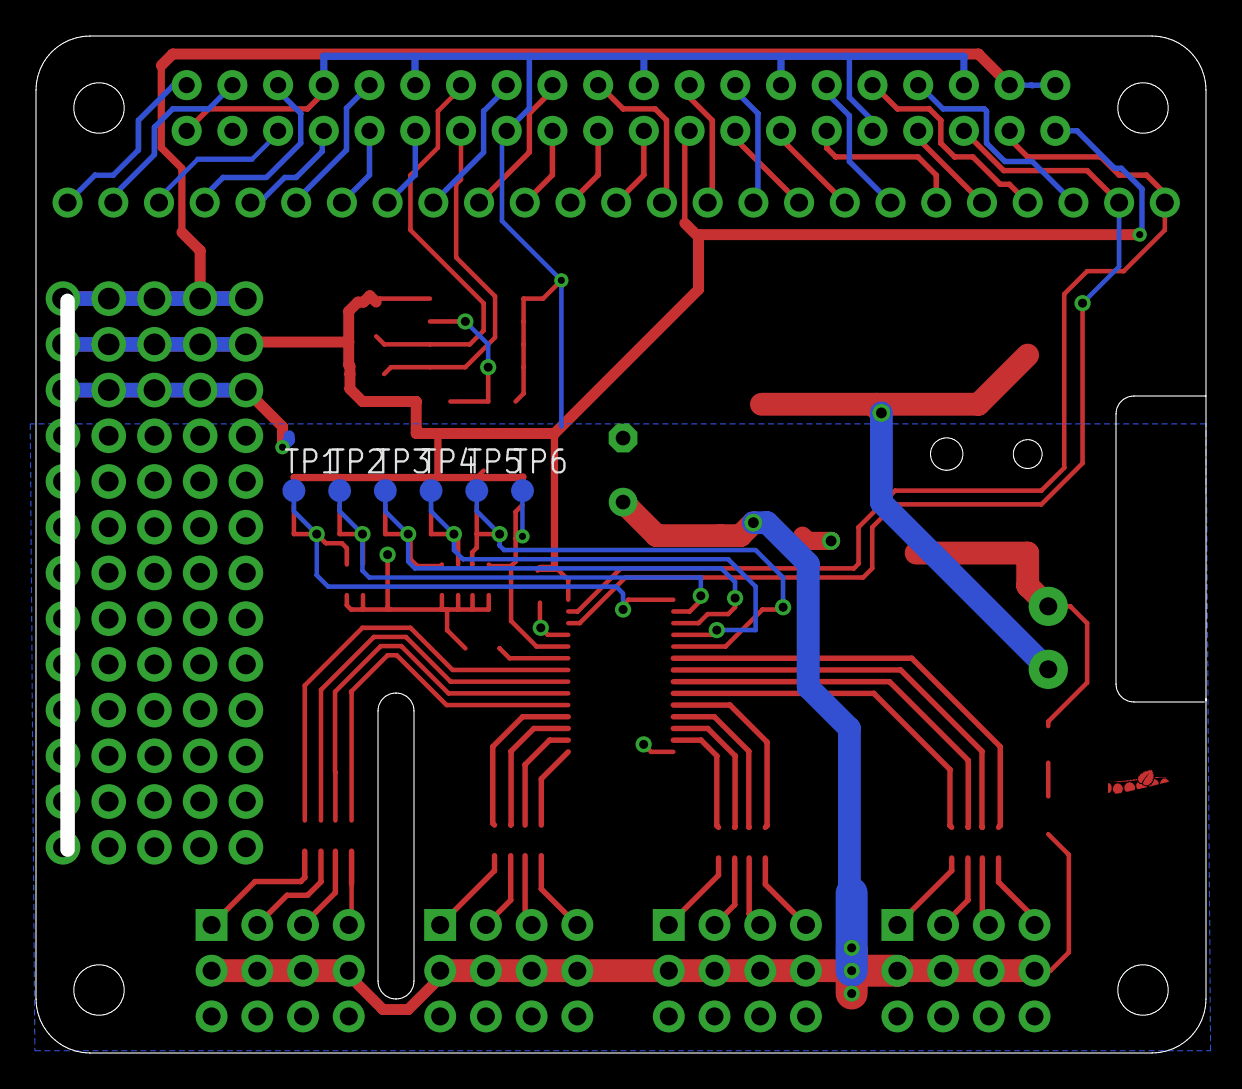
[picture p269: board Adafruit Servo HAT rev A.brd from below]

Board: 2 copper layers, 65.0 x 56.5 mm, 44 parts (6 on the bottom side), 73 nets.

Other parts of the board:
U$5: PIHATLOGO
U$6: PCBFEAT-REV-056
U$51: ADAFRUIT_5MM
