donaldsonlab/Operant-Cage/(commit log)

2021-05-10 Initial Upload
    [BoundingBox.SLDPRT, BoundingBox30_12.DXF, BoundingBox30_20.DXF, BoundingBox30_24.DXF, BoundingBox30_30.DXF, BoundingBox30_40.DXF, D2RV_L13.SLDASM, D2RV_L13_ACTUATOR.SLDPRT]
2021-05-13 Soundproof Box design
    [Bill of Materials.xlsx, bottom.DXF, bottom.SLDDRW, bottom.SLDPRT, box-hinge.SLDPRT, box.SLDPRT, boxV2.SLDPRT, box_assem.SLDASM]
2021-06-29 Minor Updates
    Minor Updates
    -Modify door gear rack
    - Add extra height to walls
    - Include Operant V1
    - Adjust wall and floor thickness
    - Other small changes
    [20mg feeding disk.STL, 2TiltCageV2_doorPanel.DXF, BoundingBox.SLDPRT, BoundingBox30_12.DXF, BoundingBox36_24.DXF, D2RV_switchMount.SLDPRT, D2RV_switchMount_mirror.SLDPRT, LBracket.STL]
2021-06-29 Accidental Deletion
    [preferenceV2_Extend_LBracket.SLDPRT, preferenceV2_Extend_bracket.SLDPRT, preferenceV2_Extend_topBracket.SLDPRT, preferenceV2_dispenser_feedingDisk.SLDPRT, preferenceV2_irMount.SLDPRT]
2021-07-09 Preference Height Updates
    [dispenserAssembly1.SLDASM, dispenser_trough.SLDPRT, door_rail_SurfaceMount.SLDPRT, door_rail_SurfaceMount.STL, lvrV2_HornAdapter.SLDPRT, lvrV2_armSleeve.SLDPRT, lvrV2_assembly.SLDASM, lvrV2_housing1.SLDPRT]
2021-07-13 Modify Door Height Extension
    [preferenceV2_door_extensionMount.SLDPRT, preferenceV2_door_extensionMount.STL, preference_Extend_topBracket.SLDPRT]
2021-08-17 Merge
    Creation of electronic components
    [cableCase_bottom.STL, cableCase_top.STL, doorPanel_antiClimbTest.DXF, door_rail_SurfaceMount.SLDPRT, lvrV2_HornAdapter.SLDPRT, lvrV2_HornAdapter_10mm.STL, lvrV2_HornAdapter_longer.STL, lvrV2_armCap.SLDPRT]
2021-08-26 Added Electrical Docs
    [Adafruit Servo HAT rev A.sch, Operant-Back.sch, Operant-Front.sch]
2021-09-09 post-processing script fro bonsai
    [data.csv]
2021-09-10 switched to main RPI_operant
2021-10-12 PCB Designs
    [Adafruit Servo HAT rev A.brd, Adafruit Servo HAT rev A.sch, Operant-Front.sch]
2021-10-14 Final version for standard operant board
    [Operant-Front.brd, Operant-Front.sch]
2021-10-19 Operant Front Board
    [Operant-Back.brd, Operant-Back.sch]
2021-10-19 Added dims
    [Operant-Back.brd]
2021-10-19 Added the Bonsai variation
    [Operant-Front-Bonsai.brd, Operant-Front-Bonsai.sch]
2021-10-21 Updated boards
    [Operant-Front-Bonsai.brd, Operant-Front-Bonsai.sch, Operant-Front.brd, Operant-Front.sch]
2021-10-21 Extended Board
    [Operant-Front-Extended.brd, Operant-Front-Extended.sch]
2022-02-03 Last commit from PC
    [Operant-Front.brd, Operant-Front.sch, data.csv]
2022-06-01 Add lower lever
    [bw_LBracket.STL, chamber_cableCases.SLDASM, dispenser_feedingDisk.SLDASM, dispenser_funnel.SLDASM, dispenser_servoMount.SLDASM, dispenser_trough.SLDASM, dispenser_wires.SLDPRT, door_rail_SurfaceMount.SLDPRT]
2022-06-01 door updates
    [2TiltCageV2_doorPanel.SLDPRT, AH1_switchOutline.SLDPRT, lvrV2_assembly.SLDASM, lvr_armPin.SLDPRT, lvr_armV3.SLDPRT, pinion_211705_2.SLDPRT, preferenceV2_door.SLDPRT, preferenceV2_door_Assembly.SLDASM]
2022-06-01 Fully assembly debugging
    [lvrV2_assembly_22217.SLDASM, pinion_211705_2.SLDPRT, preferenceV2_dispenserAssembly.SLDASM, preferenceV2_dispenser_IRAssembly.SLDASM, preferenceV2_dispenser_funnel.SLDPRT, preferenceV2_door_Assembly.SLDASM, preference_Extend_topBracket.SLDPRT, preference_TotalAssembly_V2.SLDASM]
2022-06-06 end of week
    [lvrV2_assembly_22217.SLDASM, pinion_211705_2.SLDPRT, preferenceV2_door_Assembly.SLDASM, preference_TotalAssembly_V2.SLDASM]
2022-08-15 end of day
    [door_rail_SurfaceMount.STL, lvrV2_assembly_22217.SLDASM, pinion.STL, preferenceV2_Extend_Bracket.STL, preferenceV2_Extend_Feet_Short.STL, preferenceV2_Extend_Feet_Tall.STL, preferenceV2_Extend_topBracket.SLDPRT, preferenceV2_dispenserAssembly.SLDASM]
2022-10-21 Manufacturing updates
    [Adafruit Servo HAT rev A.brd, Adafruit Servo HAT rev A.sch, Operant-Back.brd, Operant-Back.sch, Operant-Front-Bonsai.brd, Operant-Front-Bonsai.sch, Operant-Front-Extended.brd, Operant-Front-Extended.sch]
2022-11-23 manufacturing files added for short levers
    [low_levers.DXF, lvrV2_assembly_22217.SLDASM, lvrV2_housing_22217_leftSide.STL, lvrV2_housing_22217_rightSide.STL, pinion_211705_2.SLDPRT, preferenceV2_chamberBottom.SLDPRT, preferenceV2_chamberFront.SLDDRW, preferenceV2_chamberFront_backLever.DXF]
2023-02-03 end of week - added gerber files for electrical manufacturing
    [M3x12.SLDPRT, M3x16.SLDPRT, pinion_211705_2.STL, preferenceV2_dispenserAssembly.SLDASM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]
2023-03-07 Electrical files
    [Operant_Front_Bonsai_Large.brd, Operant_Front_Bonsai_Large.sch, Operant_Front_Bonsai_Small.brd, Operant_Front_Bonsai_Small.sch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]
2023-05-31 Added smaller interaction box
    [2TiltCageV2_doorPanel.SLDPRT, Interaction_Box.SLDASM, back.DXF, basex2.DXF, door_rail_SurfaceMount.SLDPRT, front.DXF, front_back.SLDDRW, front_back.SLDPRT]
2023-06-13 Added food dispenser
    [Food_dispenser_V2.SLDPRT, lvrV2_HornAdapter.STL, lvrV2_armCap.STL, lvrV2_space_cover_1_8_in.SLDPRT]
2023-06-13 merging part 2
    [Interaction_Box.SLDASM]
2023-06-13 merging part 3
    [Interaction_Box.SLDASM, front_back.SLDPRT, side.SLDPRT]
2023-06-19 Updating V3
    [Food_dispenser_V2.SLDPRT, lvrV2_assembly_22217.SLDASM, pinion_211705_2.SLDPRT, preferenceV2_door_Assembly.SLDASM, preference_TotalAssembly_V2.SLDASM, soundAssem.SLDASM, soundAssem2.SLDASM]
2023-07-24 End of Work - Ryan Cameron
    [2TiltCageV2_doorPanel.SLDDRW, 2TiltCageV2_doorPanel.SLDPRT, M3x12.SLDPRT, door_rail_SurfaceMount.SLDPRT, door_rail_SurfaceMount.STL, lvrV2_assembly_22217.SLDASM, pinion_211705_2.SLDDRW, pinion_211705_2.SLDPRT]
2023-07-26 update 20230726
    [AH1_switchOutline.SLDPRT, Assem1.SLDASM, Interaction_Box_Cover.DXF, Interaction_Box_Cover.SLDDRW, Interaction_Box_Cover^preference_TotalAssembly_V3.SLDPRT, V2_nosepoke.SLDPRT, dispenser_wires.SLDPRT, lvrV2_Nosepoke.SLDASM]
2024-06-27 6/27 v3 updates
    [Interaction_Box.SLDASM, nosepoke.SLDPRT, nosepoke_assembly_V3.SLDASM, nosepoke_guard.SLDPRT, nosepoke_guard_backing.SLDPRT, nosepoke_magnet_mount.SLDPRT, pinion_211705_2.SLDPRT, preferenceV2_dispenser_IRAssembly - Copy.SLDASM]
2024-09-05 Drawing + Printing Files for new operant box (for October 2024) Files uploaded 2024-09-05
    [M3_nut.SLDPRT, M3x12.SLDPRT, front.DXF, front_back.DXF, inner walls.DXF, interaction_lid.DXF, outside guard extended back face.DXF, outside guard extended second face.DXF]
2024-12-18 Lena - end of work
    [Food dispenser mod.SLDPRT, Nosepoke_Fit_check - new doors.SLDASM, Part1.SLDPRT, Part4.SLDPRT, Structural_base_TotalAssembly_V3.SLDPRT, nosepoke.SLDPRT, nosepoke_assembly_V3.SLDASM, nosepoke_guard.SLDPRT]
